NIJ18482/Luis-Nij-Tesis-2022/MODELADO 3D Y ENSAMBLAJES/Renderizado de versiones/v2.png

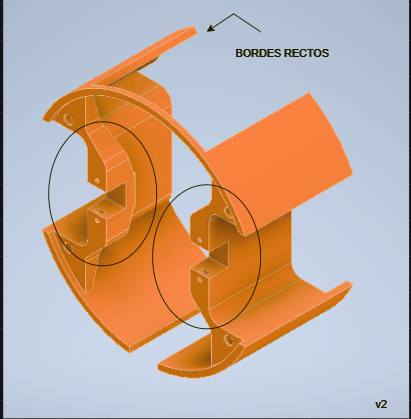
MODELADO 3D Y ENSAMBLAJES/Renderizado de versiones/v2.png
