NIJ18482/Luis-Nij-Tesis-2022/README.md

# ESTIMADO AMIGO LECTOR:

El objetivo de este repositorio es brindarte una herramienta mas con la que puedas trabajar experimentos de robotica de enjambre y que puedas ver el analisis desde la perspectiva de ingeniería de un agente robótico funcional. 

**IMPORTANTE: ESTE PRIMER README TIENE COMO OBJETIVO BRINDARTE UNA BREVE DESCRIPCION DE LOS ELEMENTOS DE ESTE REPOSITORIO
TE RECOMIENDO ENCARECIDAMENTE LEERLO Y PASAR A TRABAJO_DE_GRADUACION.MD PARA DISFRUTAR DEL TRABAJO COMPLETO Y DETALLADO**

Sirvete encontrarte con lo siguiente:

# ALPHABOT: DOCUMENTOS

- En esta carpeta encontrarás el renderizado de la documentación generada como parte del trabajo de graduación del autor. En ella encontrarás el enlace al archivo editable en Canva.com así como un archivo PDF descargable para revisar la version final de la documentación al momento de la entrega del trabajo de graduación. Así mismo se adjunta una libreria de imagenes renderizadas del archivo de documentación en formato PNG con el objetivo de brindar versatilidad a la disponibilidad de los archivos.

- Favor de ponerse en contacto con el autor si en caso quieres realizar actualizaciones al material de documentación para configurar los permisos correspondientes. 

# ALPHABOT: MODELADO 3D Y ENSAMBLAJES

- En esta carpeta encontrarás los modelos 3D de las partes que componen el agente robótico que se analiza en el presente repositorio.
- Es necesario mencionar que para el modelado de las piezas en 3D se utilizó la suite 2023 de Autodesk Inventor Professional. Es immportante mencionar esto ya que necesitarás una version igual o más actualizada para poder abrir dichos archivos ya que por politica de Autodesk (la compañía que desarrolló el software) no existe compatibilidad entre una version reciente de Autodesk Inventor reciente con archivos creados en versiones viejas.
- Para la manufactura de las piezas que veras a continuación se puede optar por varias tecnicas de impresion 3D. Dada la disponibilidad de recursos del autor se optó por impresion 3D por fundicion de material de filamento. El modelo utilizado fue la Ender 3 version 1 y PLA estándar de la marca eSUN. Puedes ponerte en contacto con el autor si deseas mas detalles de cómo fueron manufacturadas las piezas y la compatibilidad de impresoras 3D.
- Así mismo, las piezas planares como los covertores superiores con el emblema de la Universidad del Valle de Guatemala fueron manufacturados por corte laser de plancha de acrílico transparente de 3mm. Para esto se utilizó una cortadora laser de 40W de potencia de origen chino. Nuevamente, puedes ponerte en contacto con el autor para verificar la compatibilidad y viabilidad de utilizar diferente maquinaria.

# ALPHABOT: SCRIPTS Y PROGRAMACIÓN
-En esta carpeta encontrarás los dos scripts de programacion fundamentales con los que se aporto al trabajo de graduación. En su carpeta encontrarás mas información respecto a cada uno, sin embargo te puedo anticipar que corresponden al sistema de comunicacion esclavo-maestro de los agentes roboticos y que sirvio como plataforma para comunicar instrucciones y recibir comandos en el servicor (PC) proveniente de los agentes roboticos 

# ALPHABOT: TRABAJO DE GRADUACION.MD
- Aquí encontraras el consolidado del trabajo de graduación en formato repositorio para que puedas leerlo en GitHub, se adjunta también la version en PDF del trabajo final y posterior a la autorización final por parte de Secretaria General de la UVG de aprobada la tesis en cuanto a forma y redacción.
