NIJ18482/Luis-Nij-Tesis-2022/DOCUMENTOS/README.MD

# BIENVENIDO AMIGO

- En esta sección encontrarás el archivo comprimido de la documentación en formato imagenes JPG para descarga y facil distribución.
Es importante mencionar que corresponde a la V1.0 del mismo. 

Para mas detalles puedes ponerte en contacto con el autor.
