NIJ18482/Luis-Nij-Tesis-2022/Documentos/README_DOCUMENTOS.md

# DOCUMENTACIÓN DEL ANÁLISIS DEL AGENTE ROBÓTICO - DOCUMENTO PDF ADJUNTO

Enlace: https://www.canva.com/design/DAFGcc9DaEw/2KTWVuM6ZRo98AekcS2Smw/edit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

Como parte de los aportes de este trabajo se generó un documento a manera de documentación explicando componente por componente los elementos del Alphabot02. Se deja compartido el documento en este repositorio asi como el enlace a la plataforma Canva para poder descargarlo y/o editarlo segun se requiera. 

Para editar el documento favor escribir al autor para configurar los permisos.
