NIJ18482/Luis-Nij-Tesis-2022/DOCUMENTOS/Images/1.png

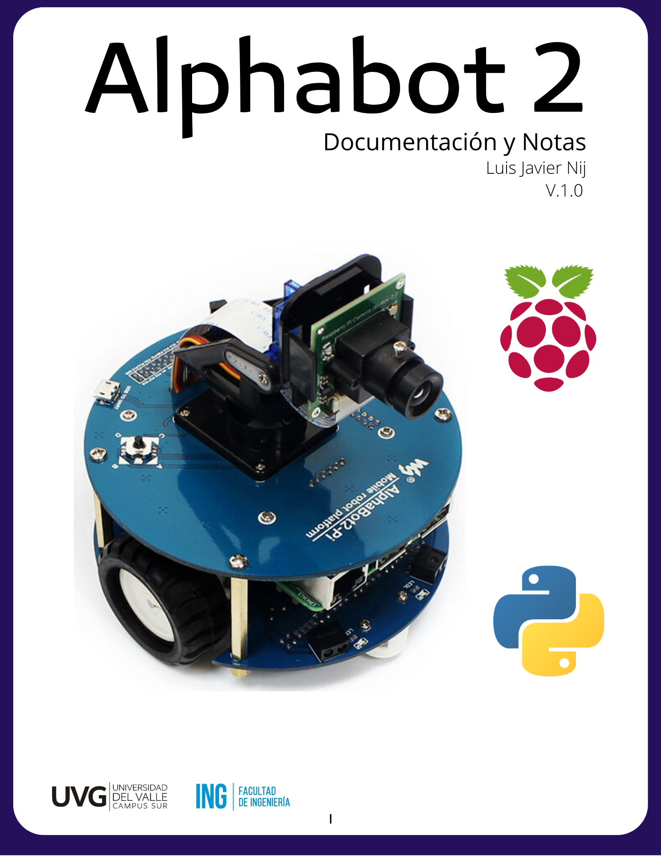
DOCUMENTOS/Images/1.png
