NIJ18482/Luis-Nij-Tesis-2022/DOCUMENTOS/Images/2.png

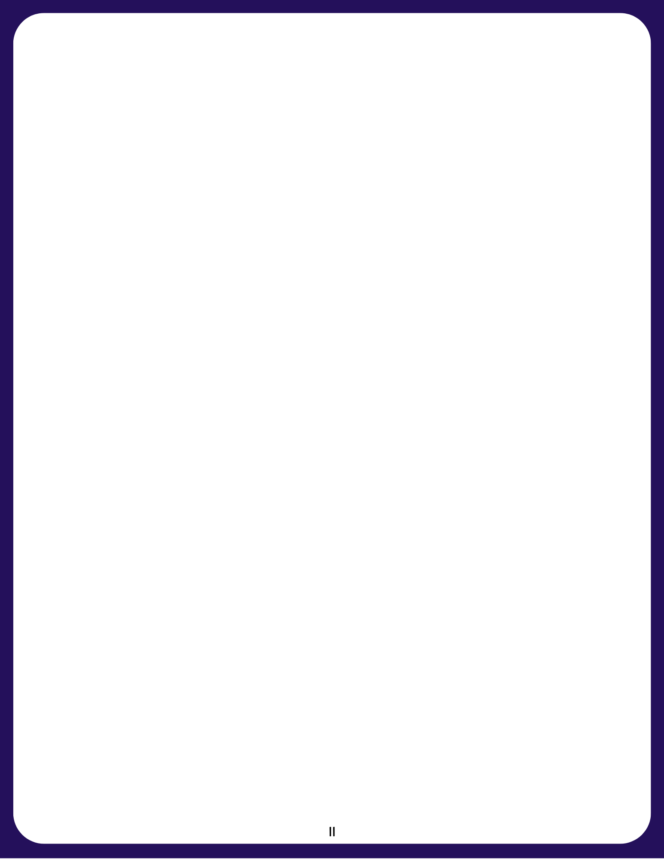
DOCUMENTOS/Images/2.png
