NIJ18482/Luis-Nij-Tesis-2022/DOCUMENTOS/Images/3.png

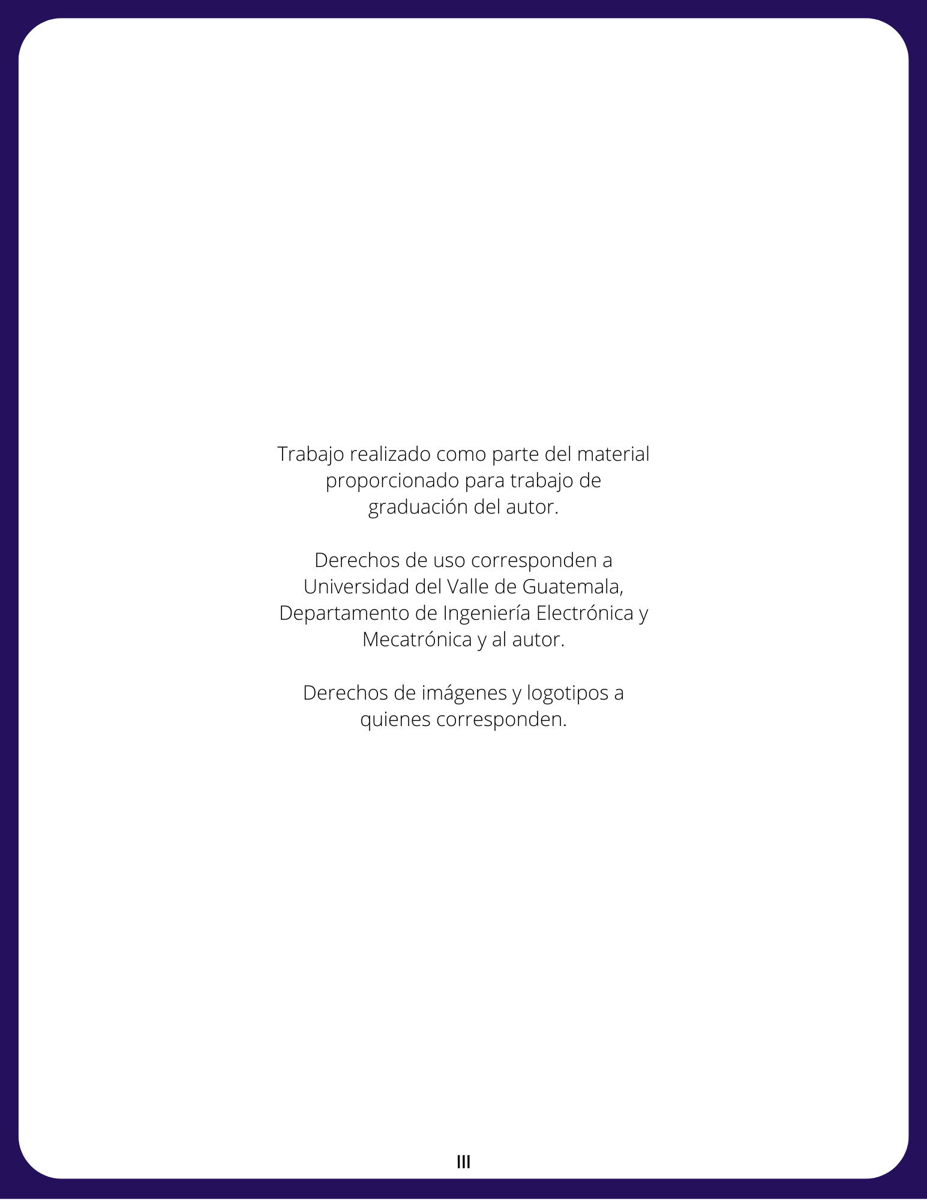
DOCUMENTOS/Images/3.png
