NIJ18482/Luis-Nij-Tesis-2022/DOCUMENTOS/Images/7.png

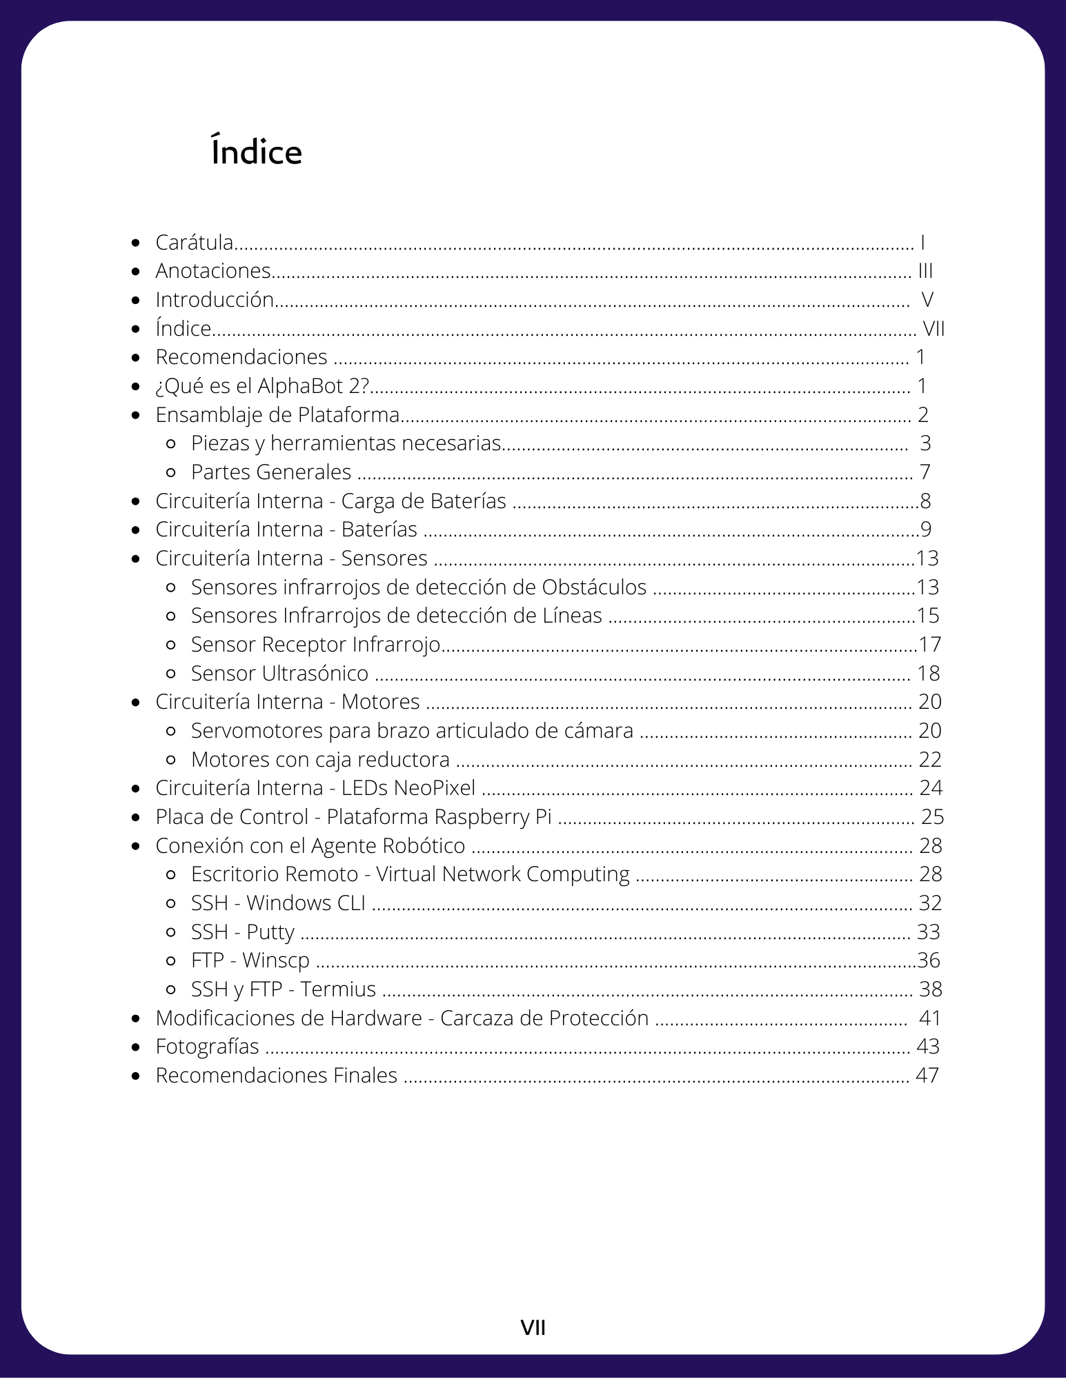
DOCUMENTOS/Images/7.png
