NIJ18482/Luis-Nij-Tesis-2022/DOCUMENTOS/Images/8.png

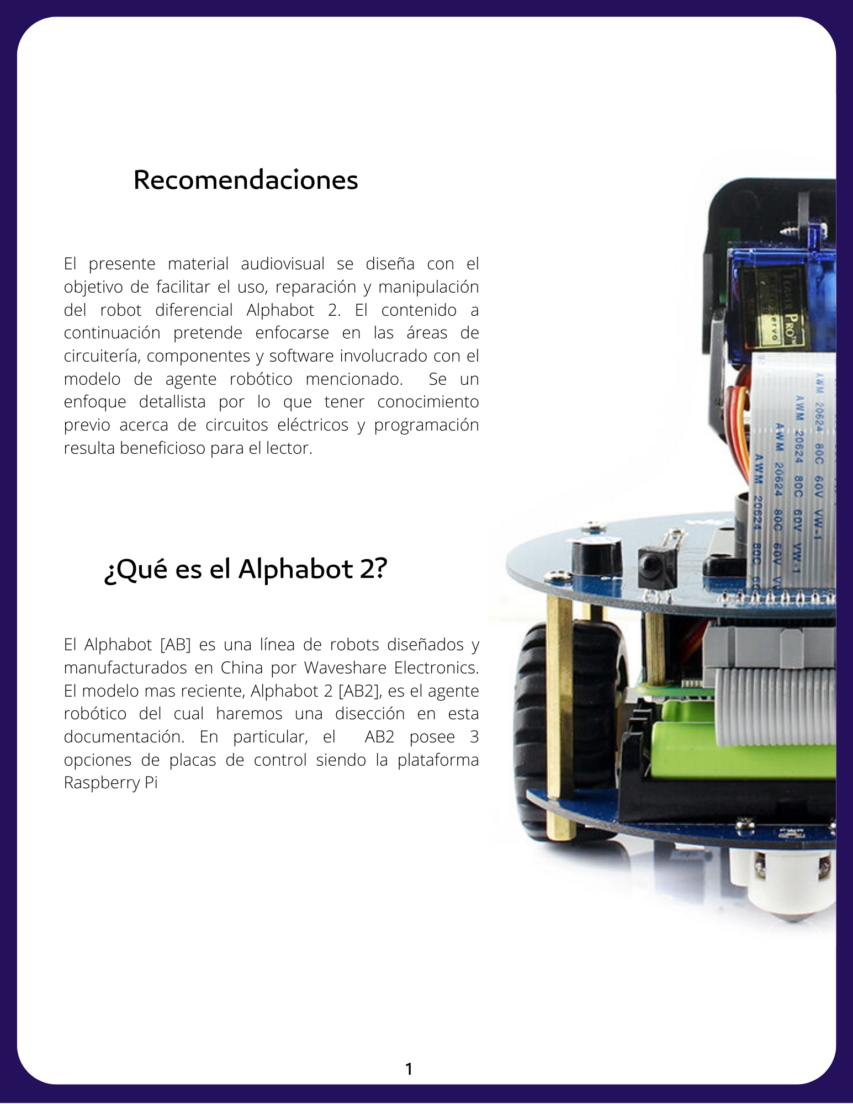
DOCUMENTOS/Images/8.png
