NIJ18482/Luis-Nij-Tesis-2022/DOCUMENTOS/Images/9.png

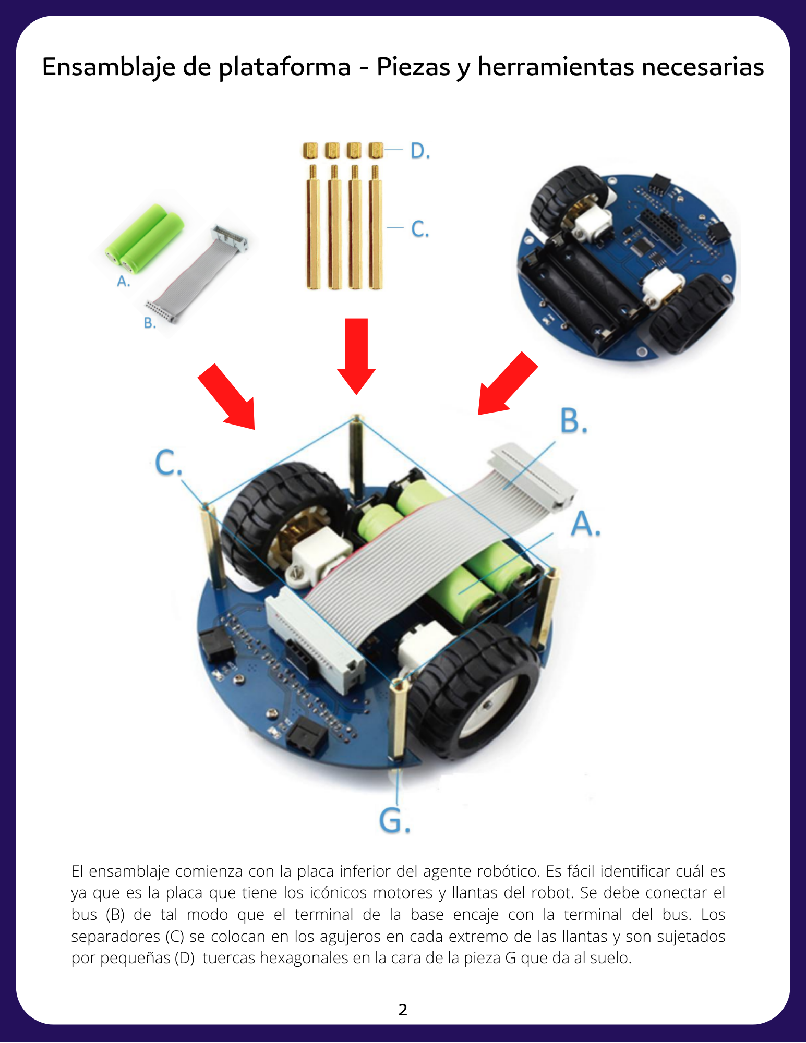
DOCUMENTOS/Images/9.png
