NIJ18482/Luis-Nij-Tesis-2022/DOCUMENTOS/Images/10.png

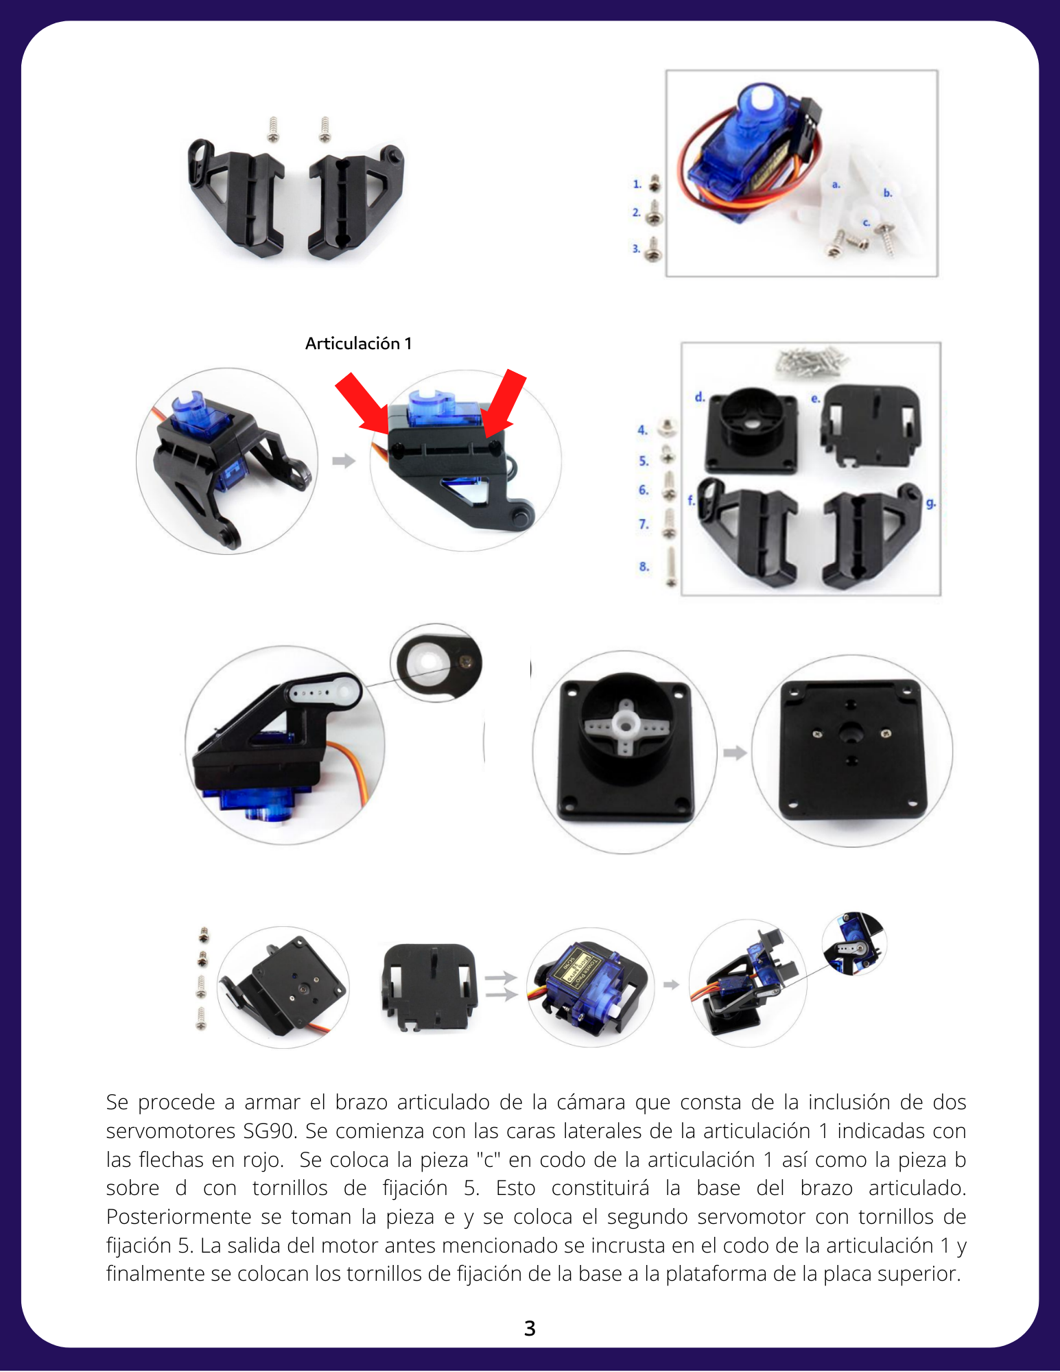
DOCUMENTOS/Images/10.png
