NIJ18482/Luis-Nij-Tesis-2022/DOCUMENTOS/Images/11.png

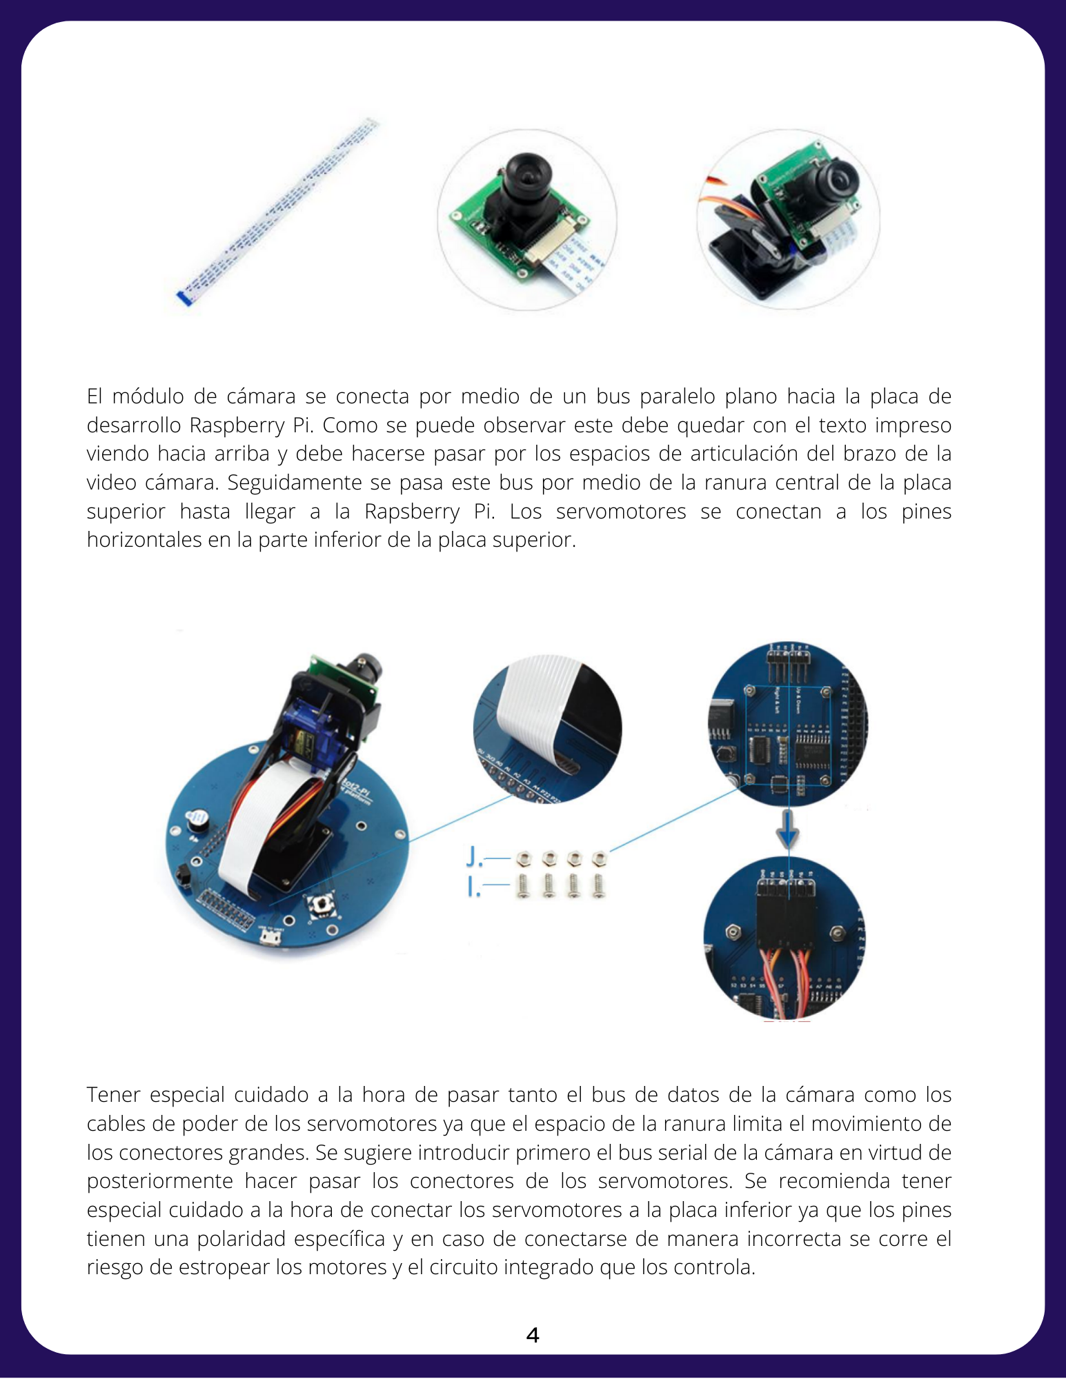
DOCUMENTOS/Images/11.png
