NIJ18482/Luis-Nij-Tesis-2022/DOCUMENTOS/Images/12.png

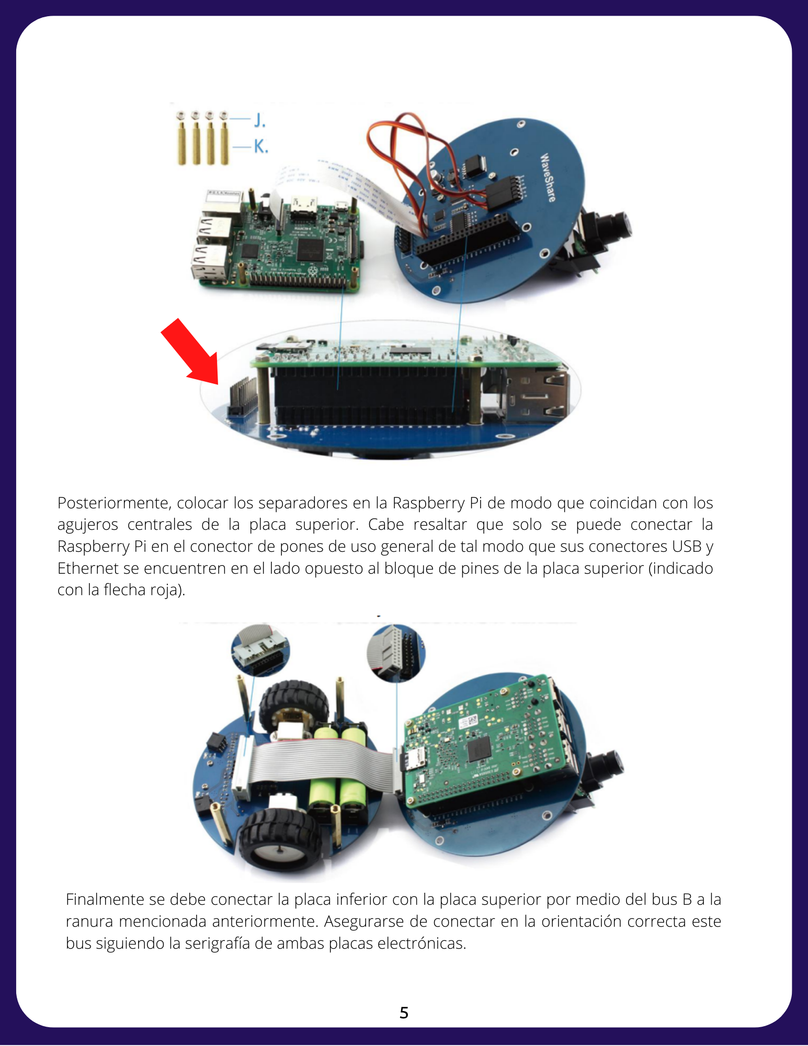
DOCUMENTOS/Images/12.png
