NIJ18482/Luis-Nij-Tesis-2022/DOCUMENTOS/Images/13.png

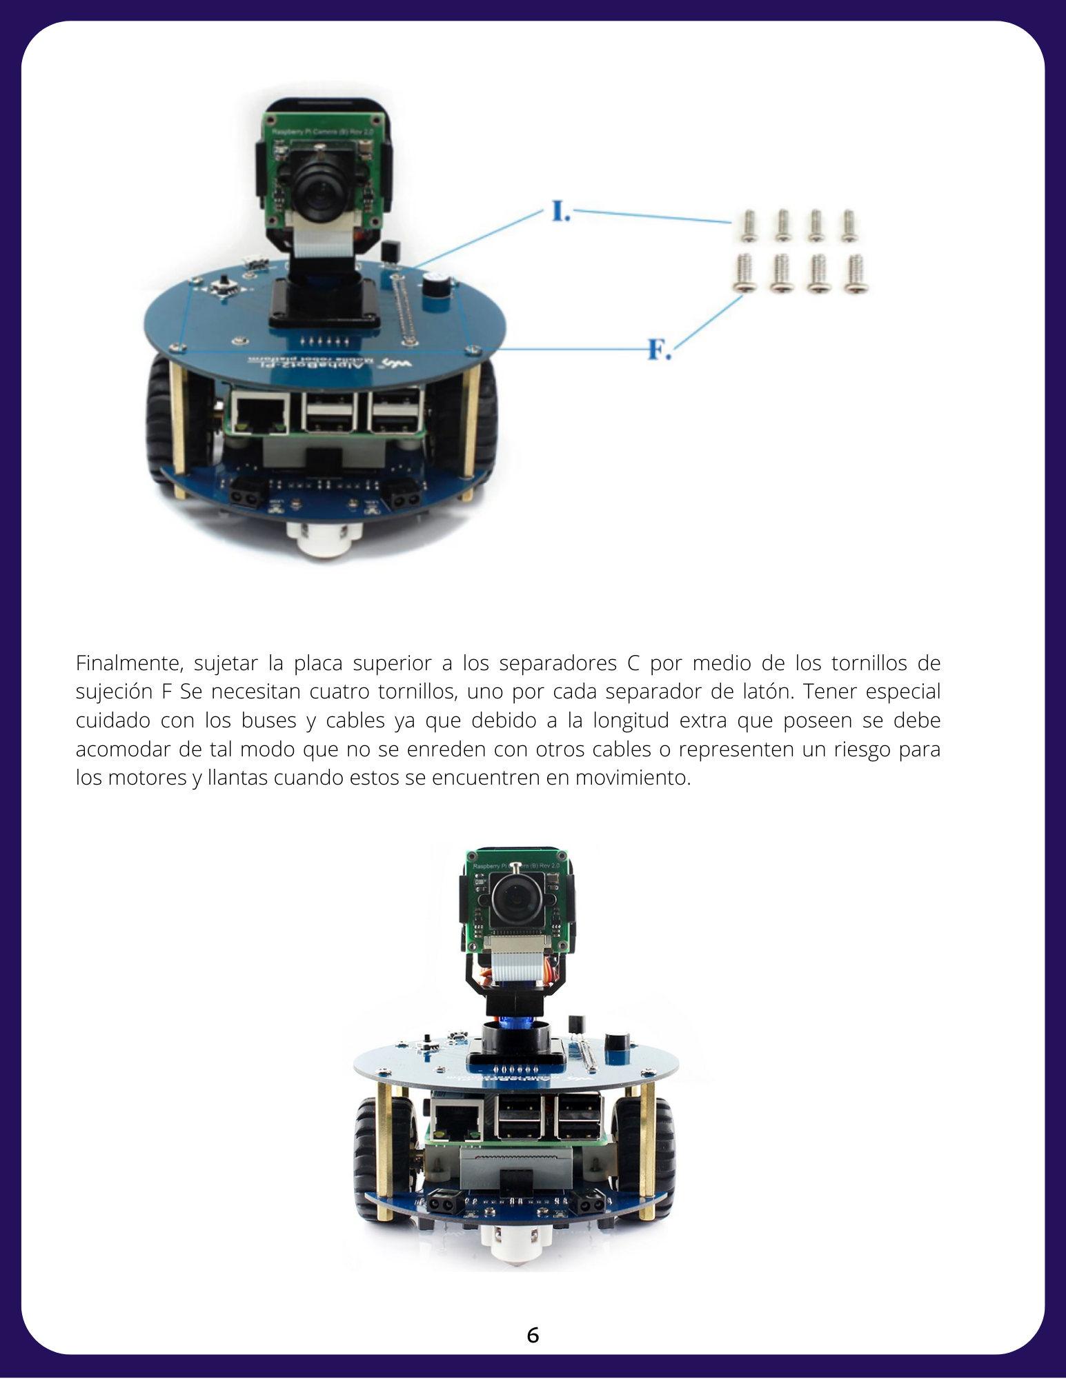
DOCUMENTOS/Images/13.png
