NIJ18482/Luis-Nij-Tesis-2022/DOCUMENTOS/Images/14.png

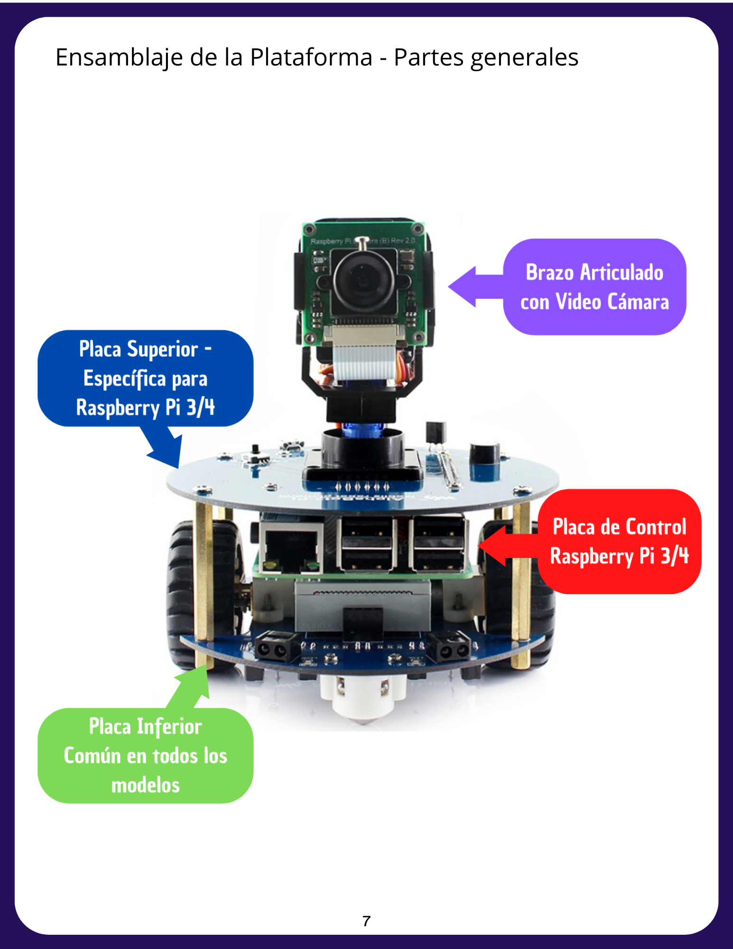
DOCUMENTOS/Images/14.png
