NIJ18482/Luis-Nij-Tesis-2022/DOCUMENTOS/Images/15.png

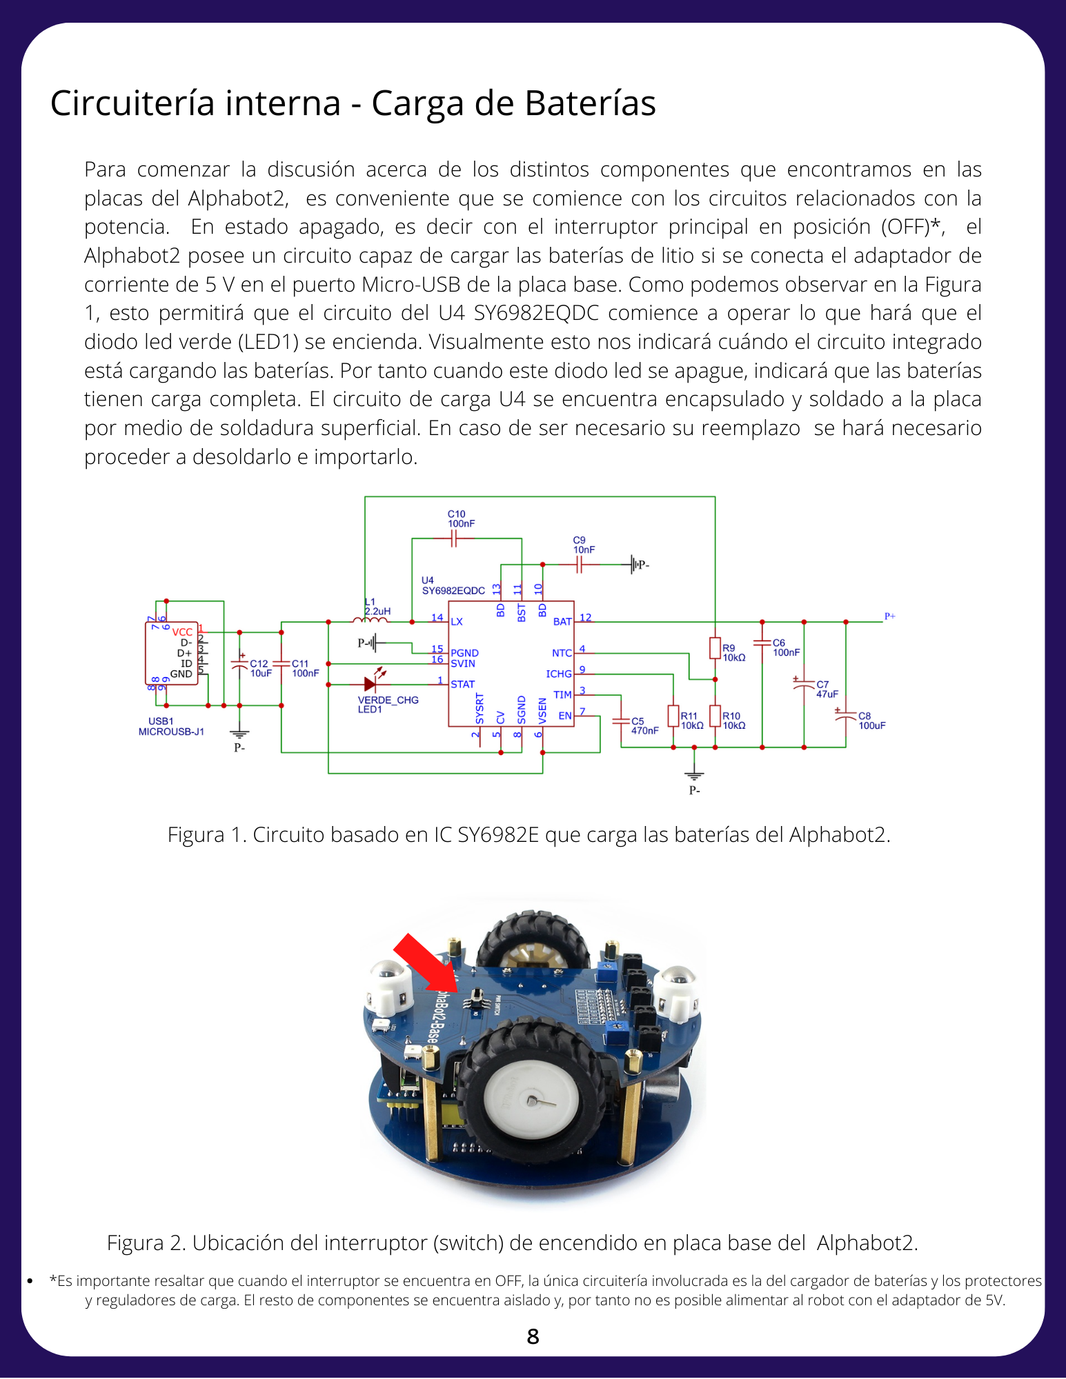
DOCUMENTOS/Images/15.png
