NIJ18482/Luis-Nij-Tesis-2022/DOCUMENTOS/Images/16.png

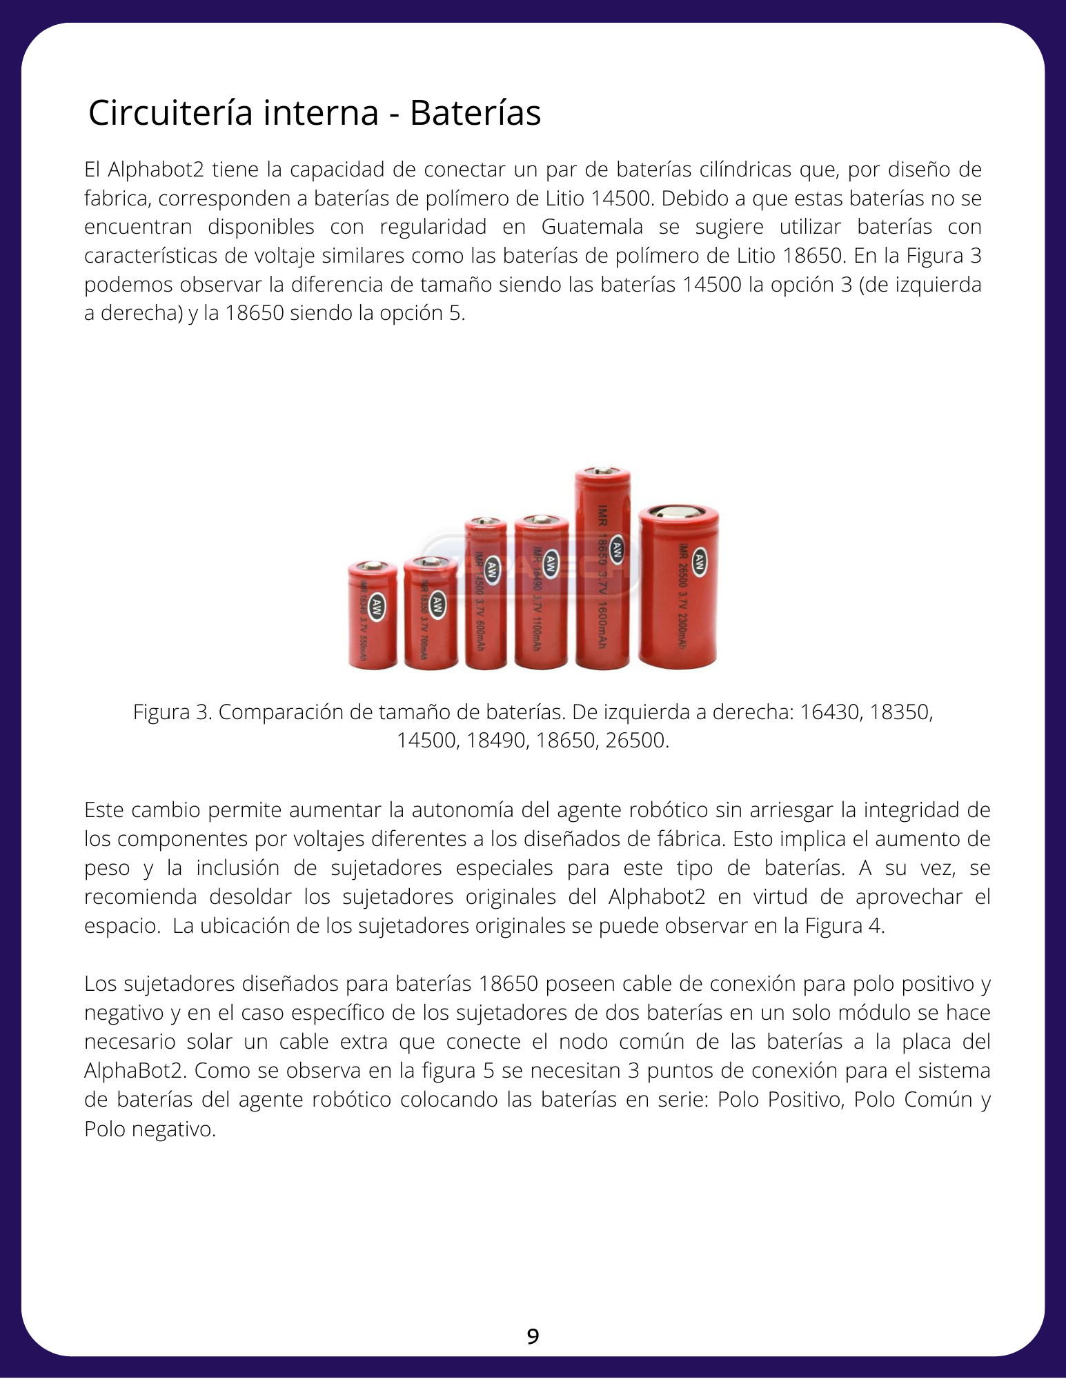
DOCUMENTOS/Images/16.png
