NIJ18482/Luis-Nij-Tesis-2022/DOCUMENTOS/Images/17.png

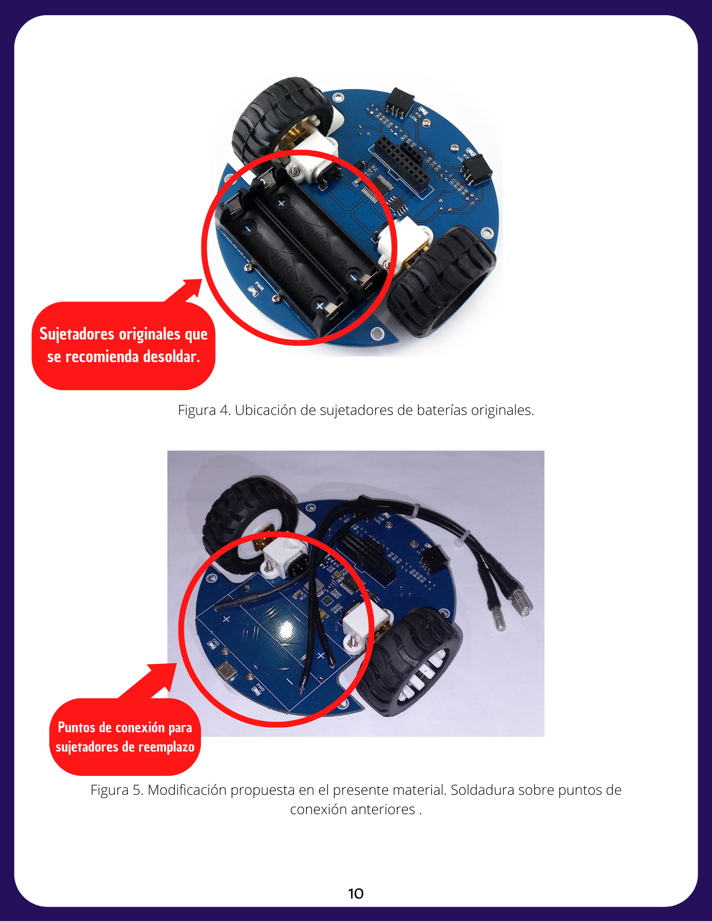
DOCUMENTOS/Images/17.png
