NIJ18482/Luis-Nij-Tesis-2022/DOCUMENTOS/Images/18.png

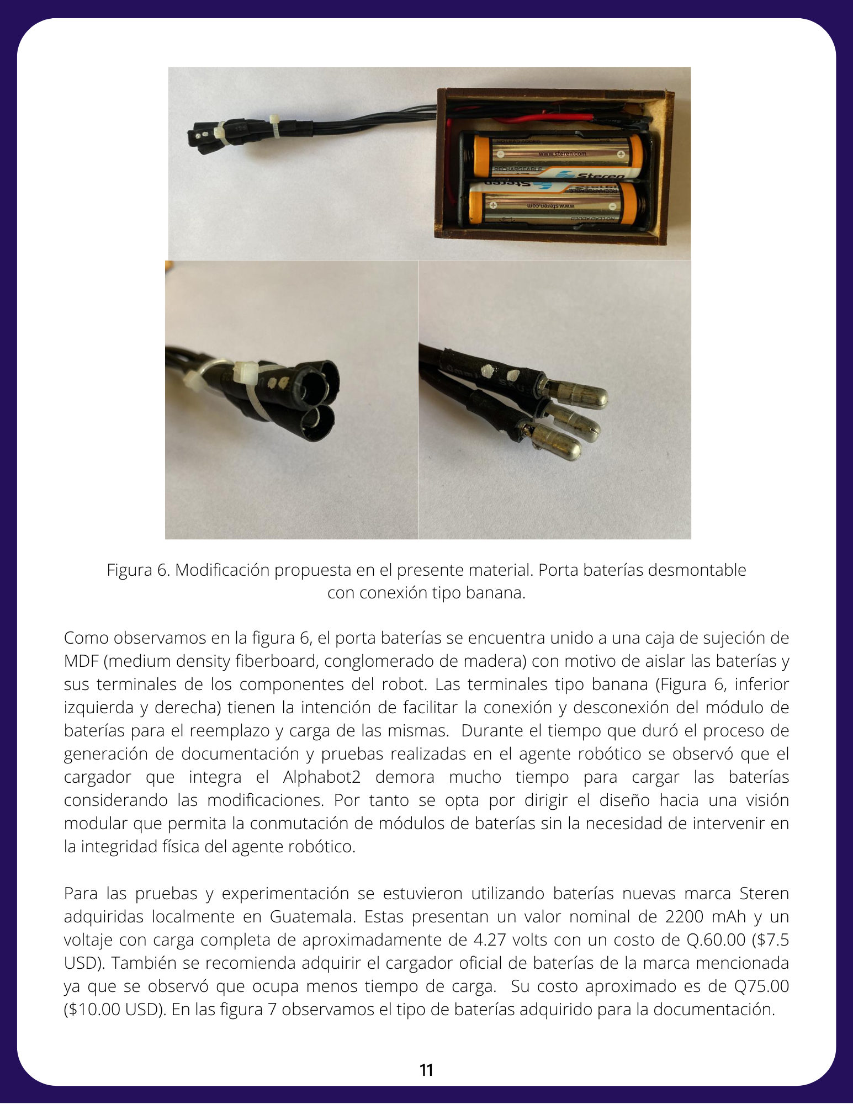
DOCUMENTOS/Images/18.png
