NIJ18482/Luis-Nij-Tesis-2022/DOCUMENTOS/Images/19.png

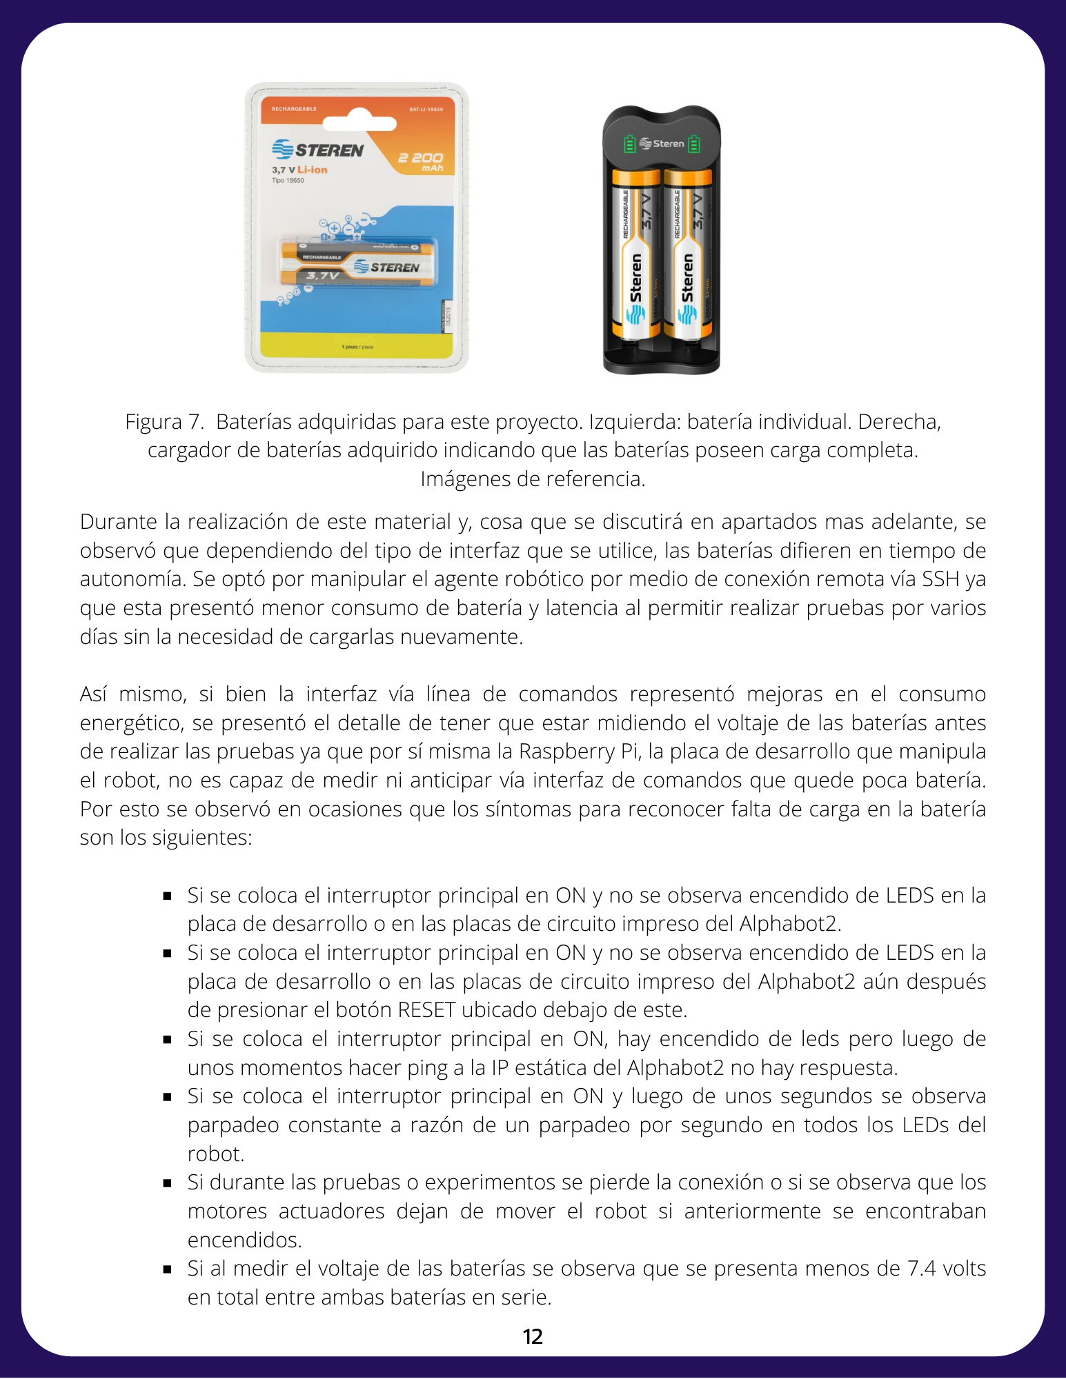
DOCUMENTOS/Images/19.png
