NIJ18482/Luis-Nij-Tesis-2022/DOCUMENTOS/Images/20.png

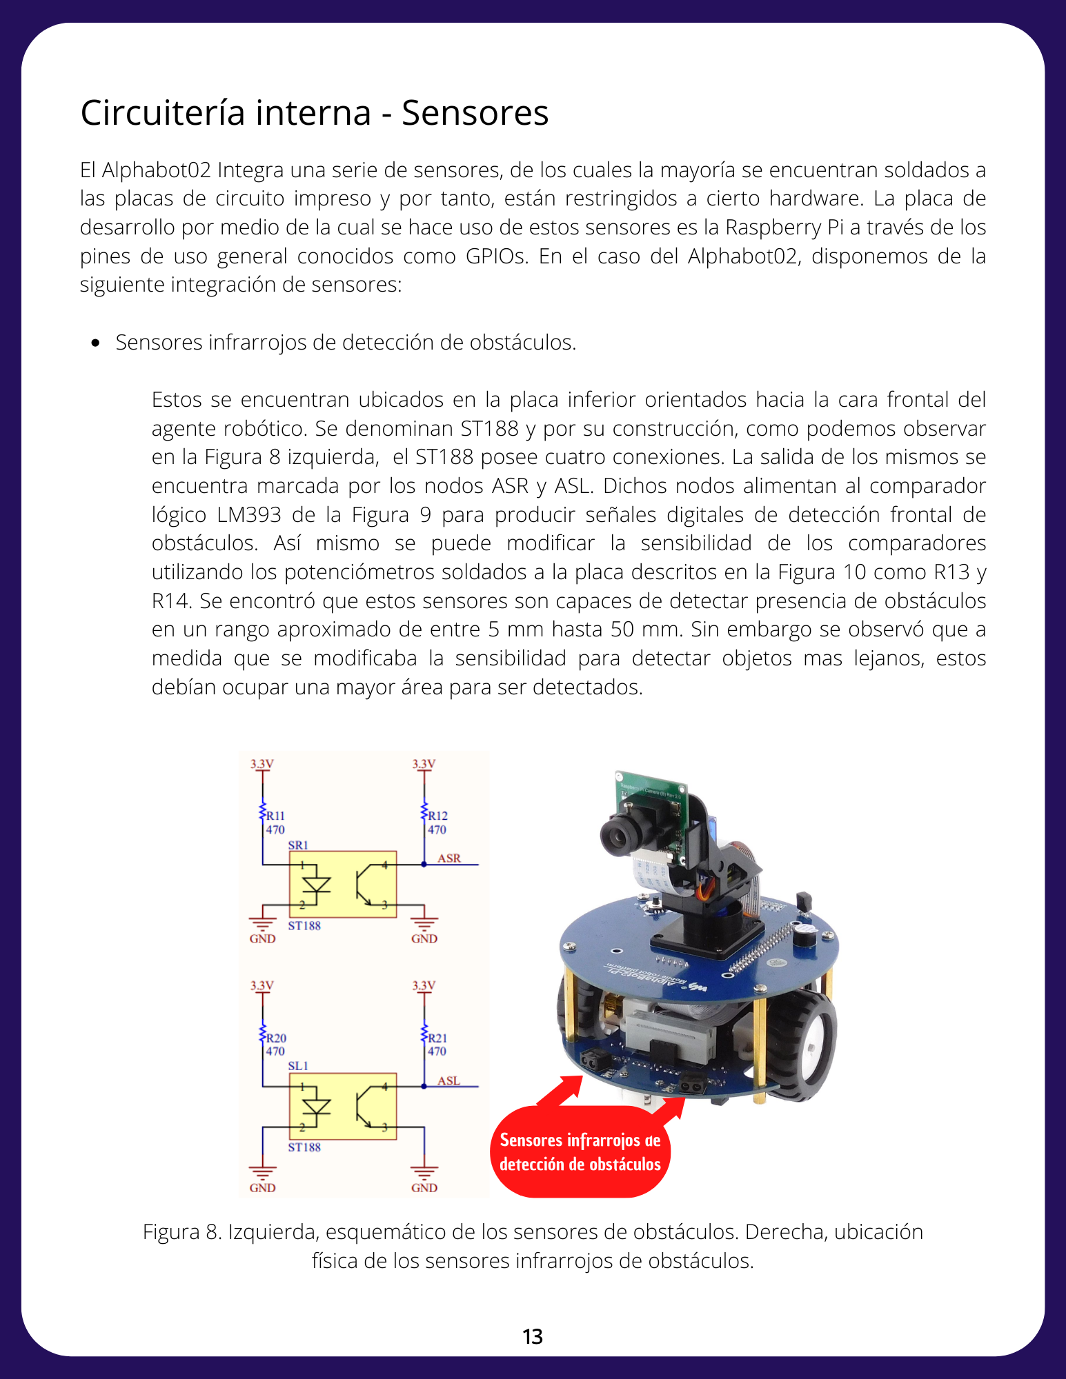
DOCUMENTOS/Images/20.png
