NIJ18482/Luis-Nij-Tesis-2022/DOCUMENTOS/Images/21.png

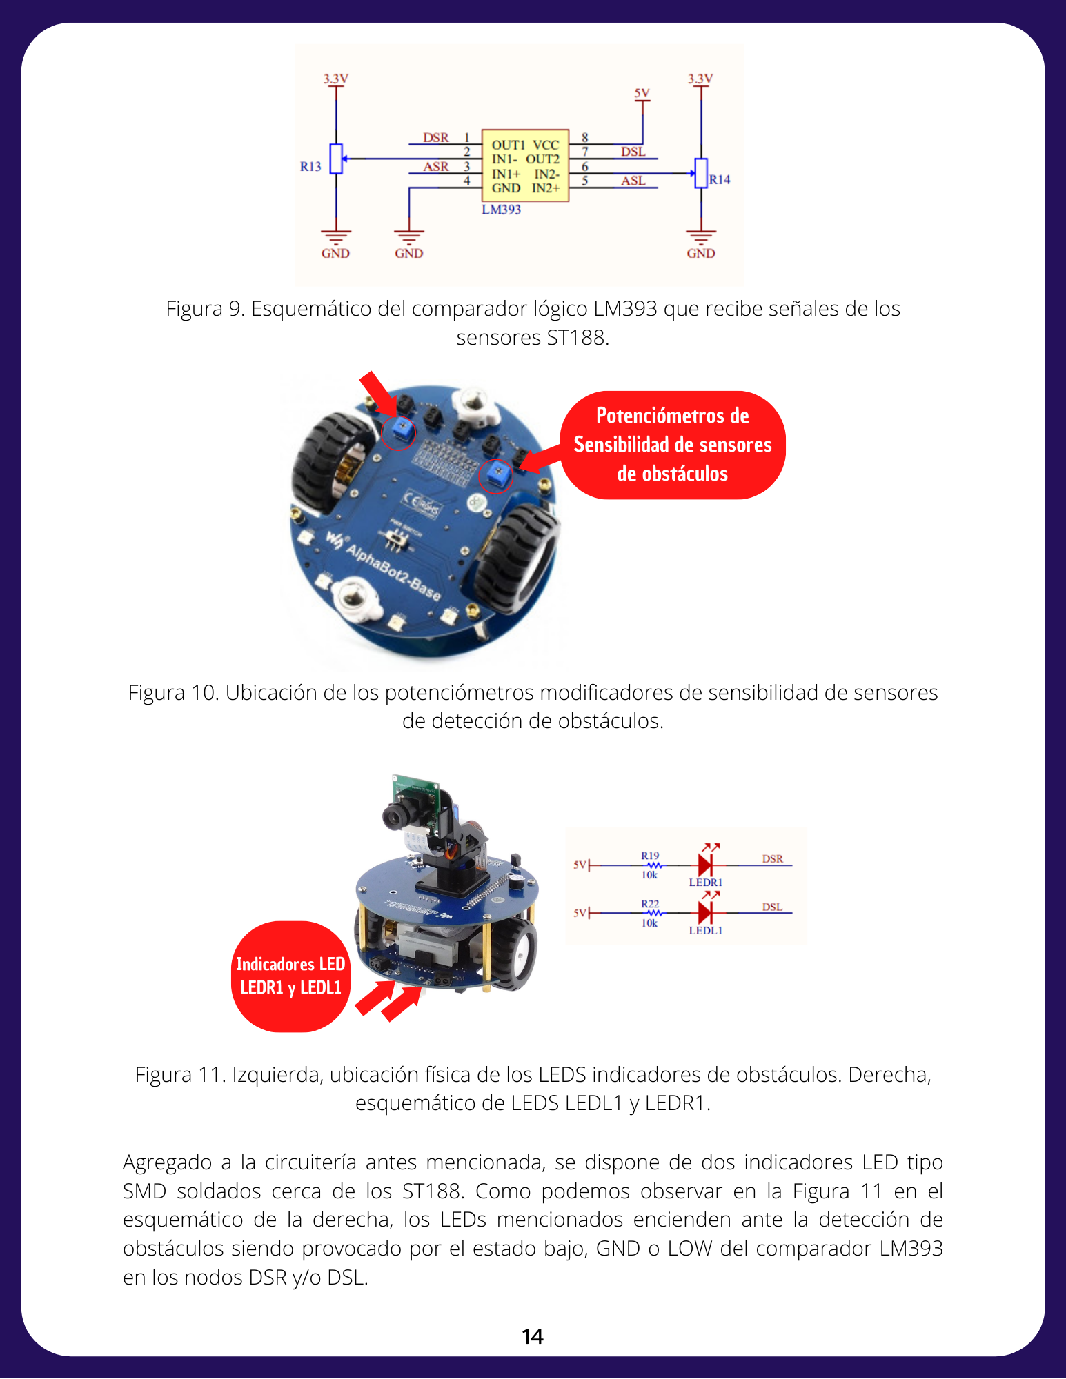
DOCUMENTOS/Images/21.png
