NIJ18482/Luis-Nij-Tesis-2022/DOCUMENTOS/Images/22.png

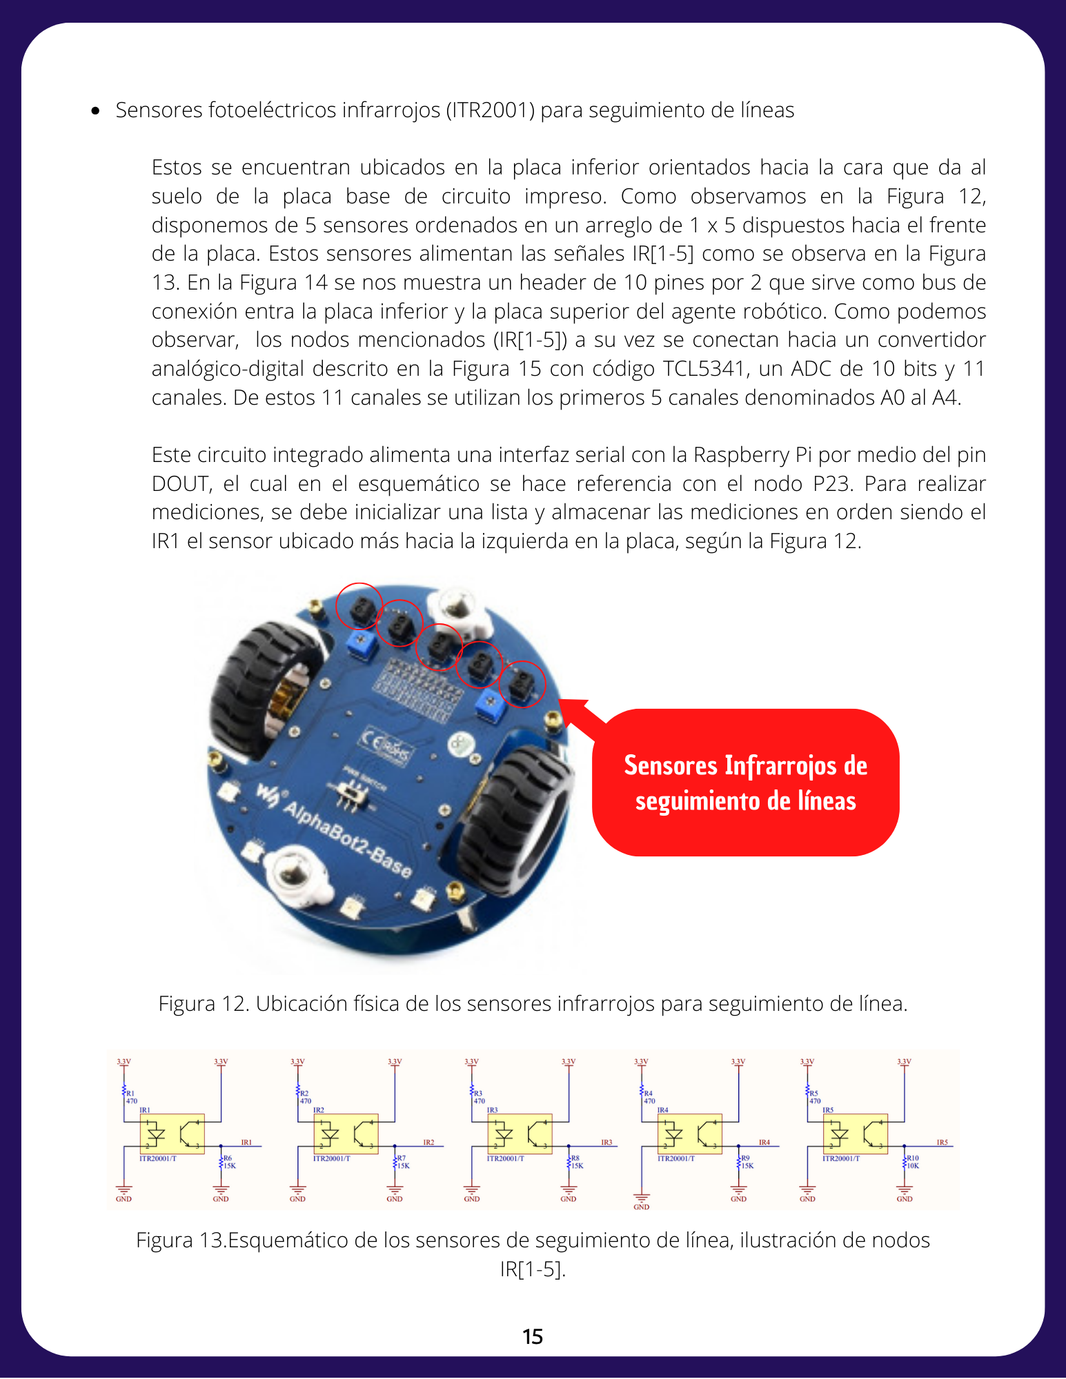
DOCUMENTOS/Images/22.png
