NIJ18482/Luis-Nij-Tesis-2022/DOCUMENTOS/Images/23.png

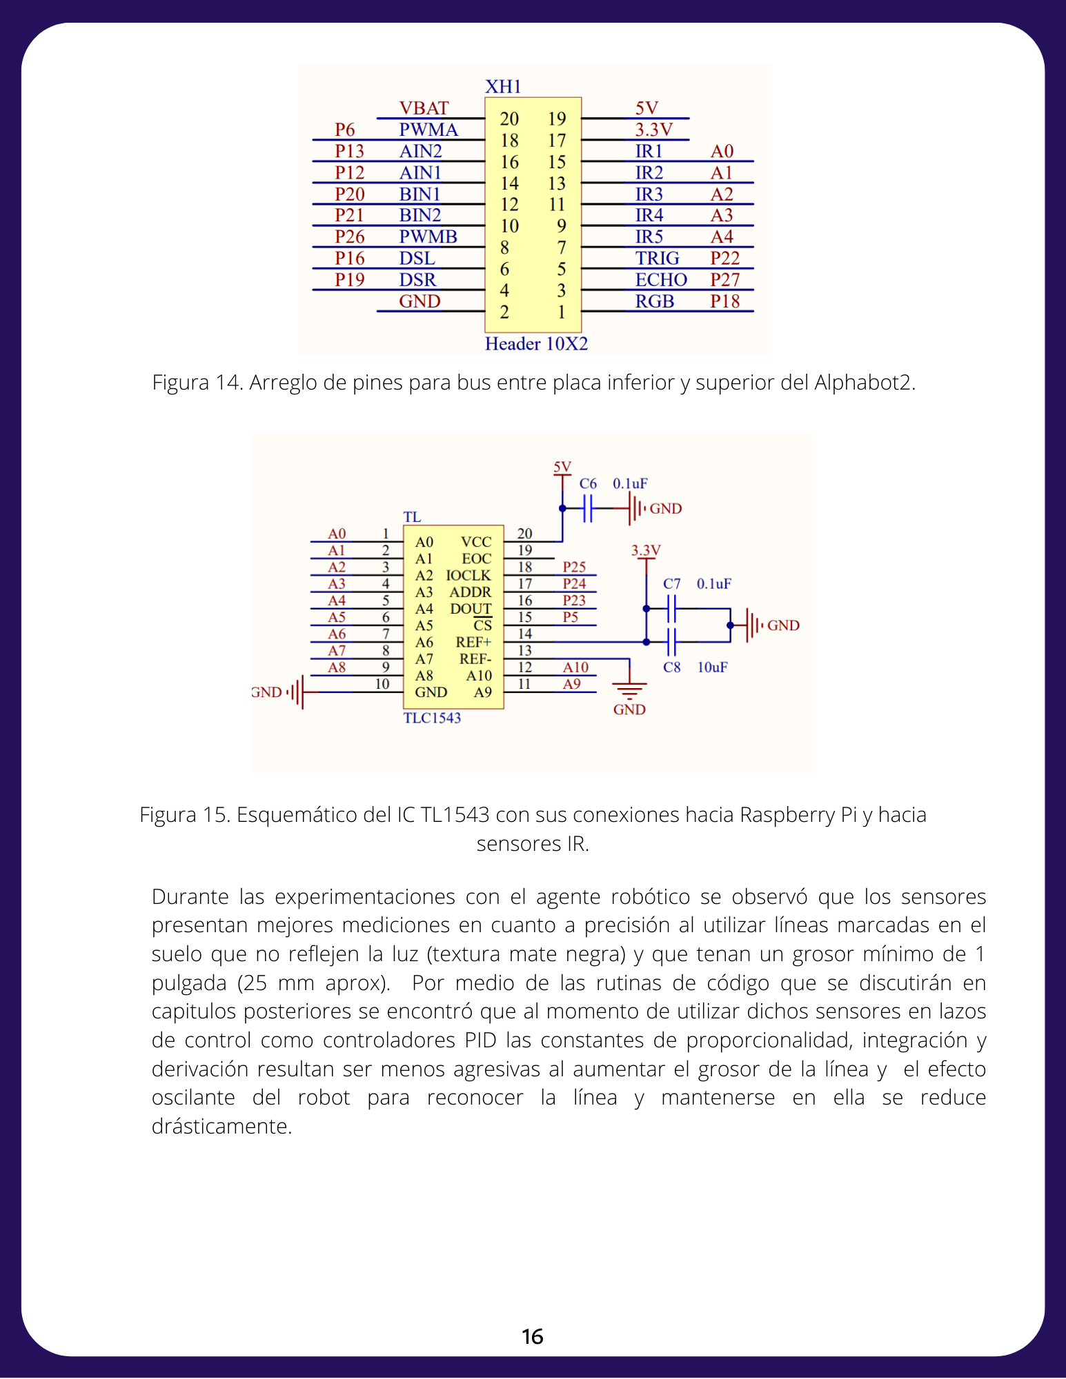
DOCUMENTOS/Images/23.png
