NIJ18482/Luis-Nij-Tesis-2022/DOCUMENTOS/Images/24.png

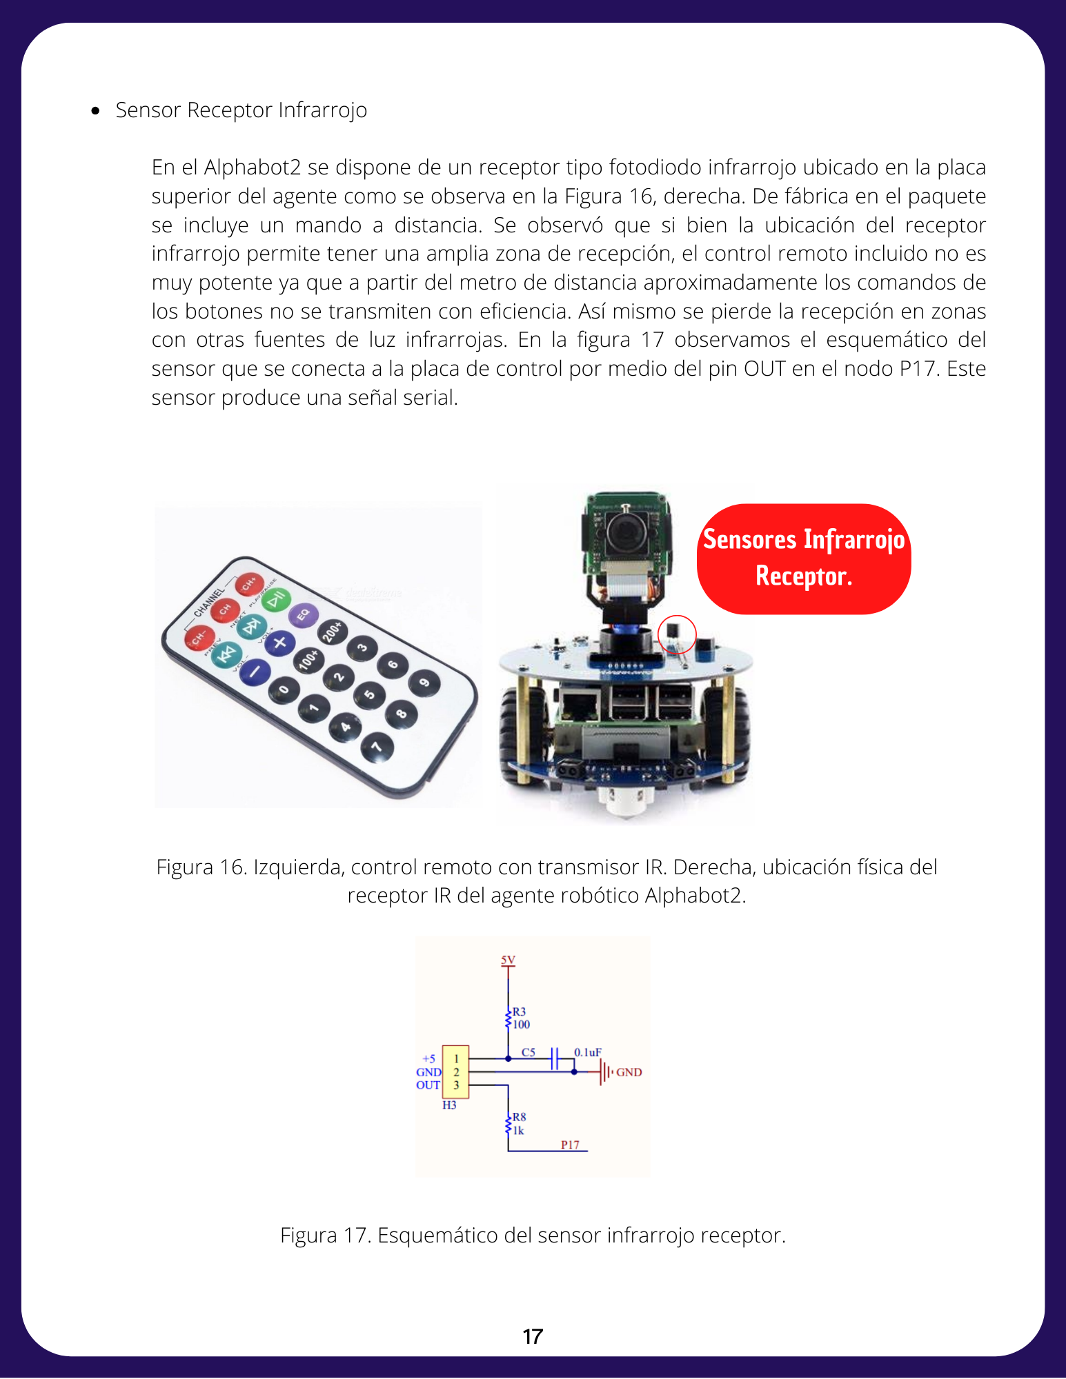
DOCUMENTOS/Images/24.png
