NIJ18482/Luis-Nij-Tesis-2022/DOCUMENTOS/Images/25.png

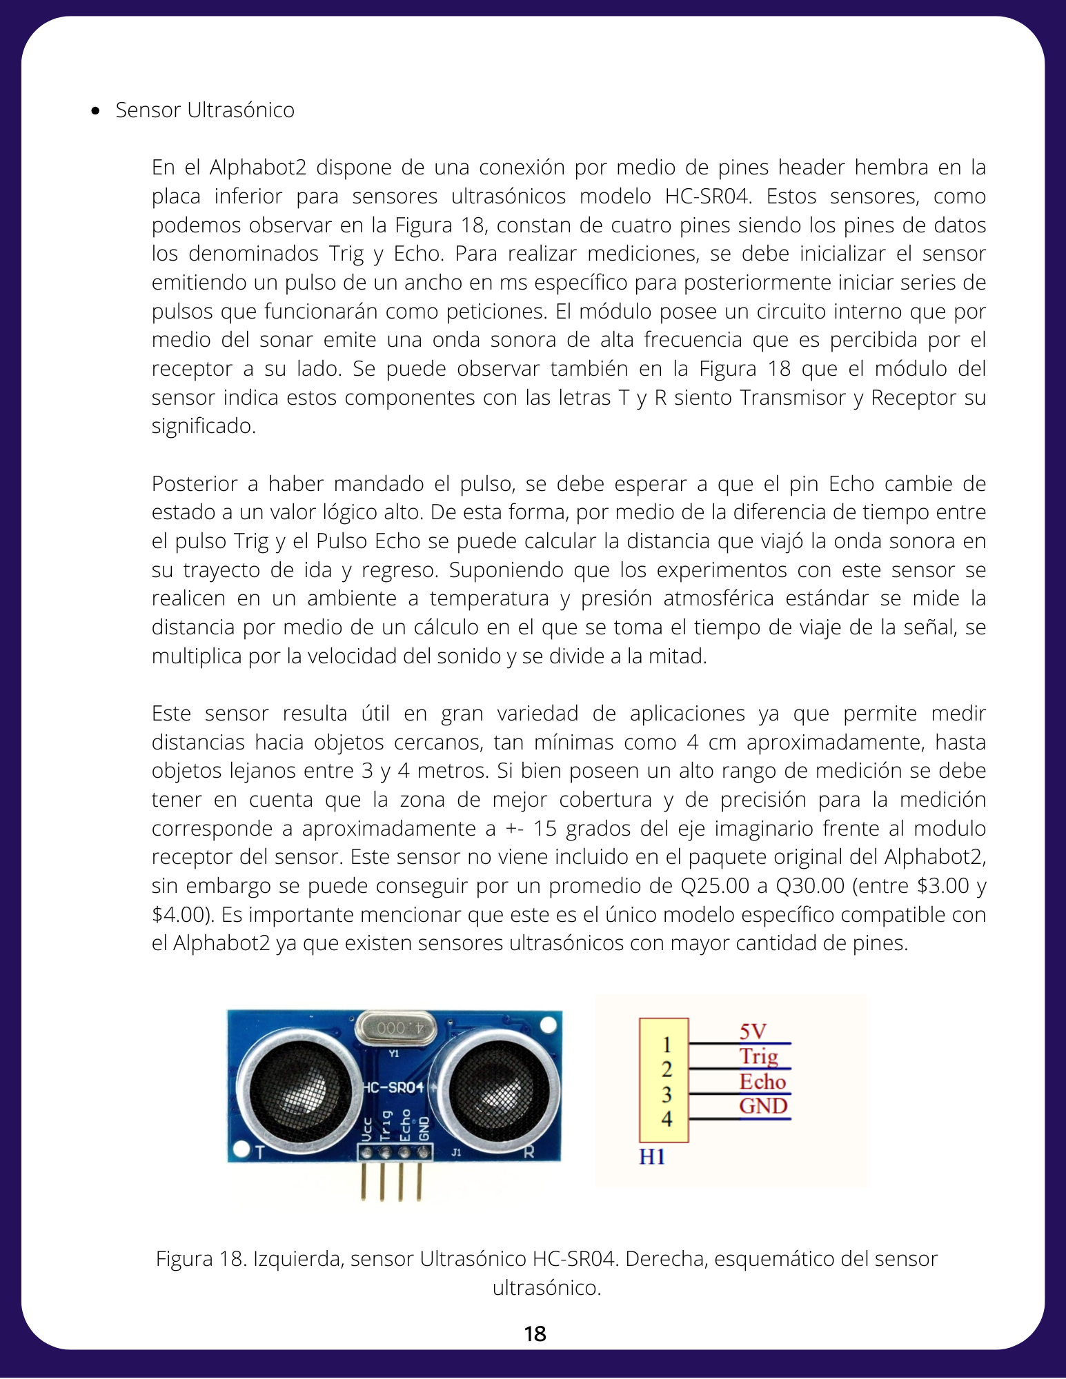
DOCUMENTOS/Images/25.png
