NIJ18482/Luis-Nij-Tesis-2022/DOCUMENTOS/Images/26.png

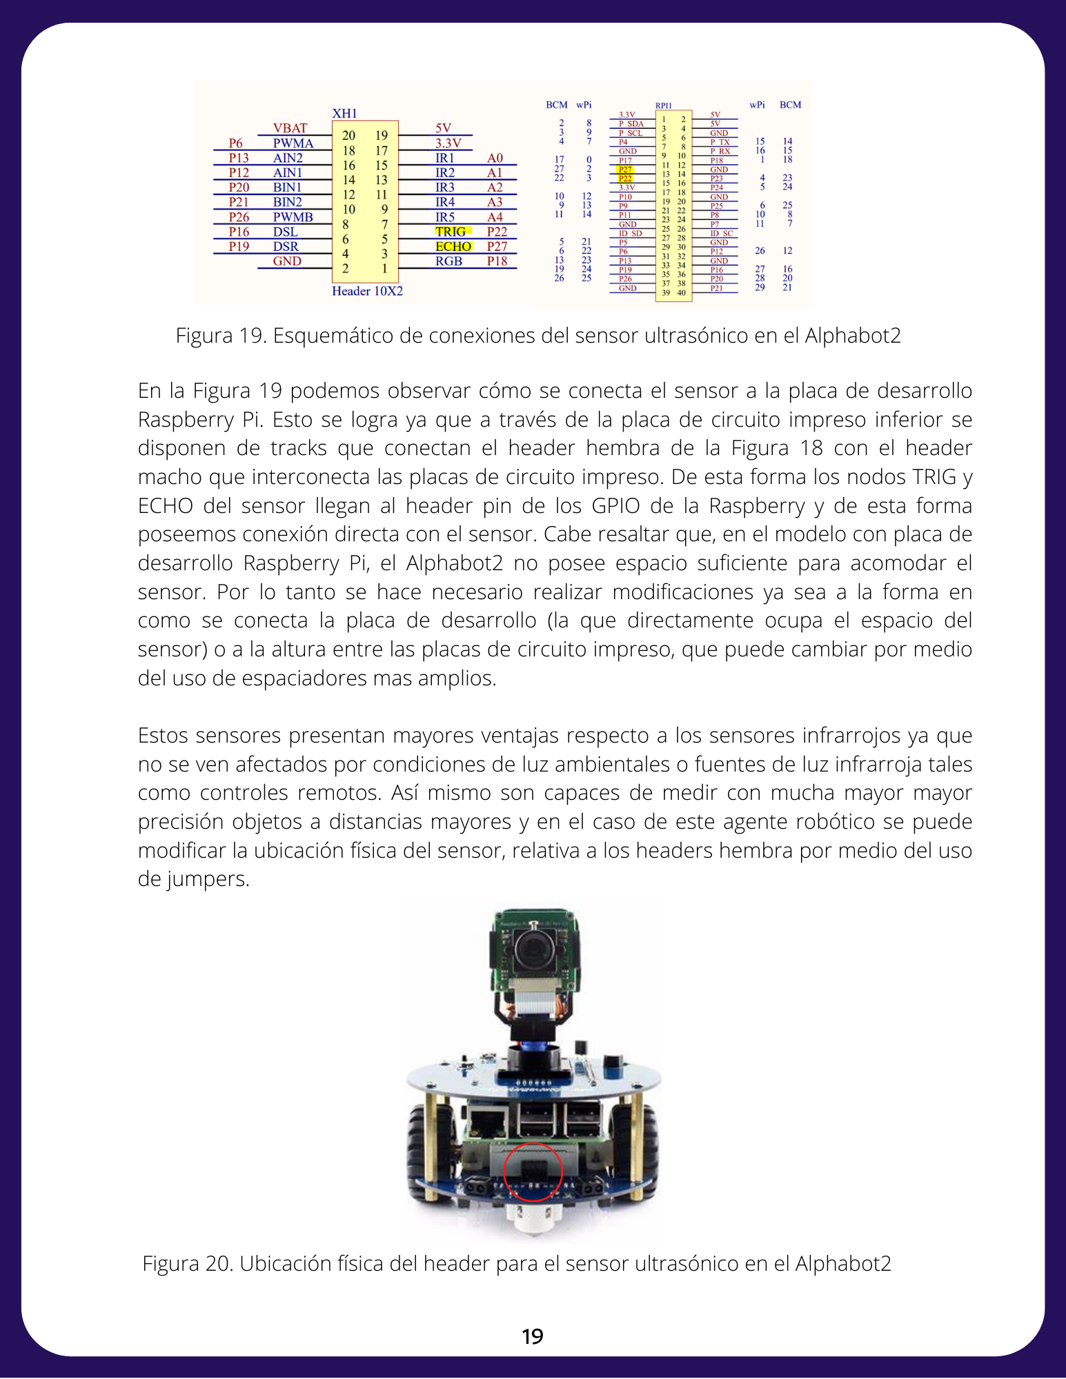
DOCUMENTOS/Images/26.png
