NIJ18482/Luis-Nij-Tesis-2022/DOCUMENTOS/Images/27.png

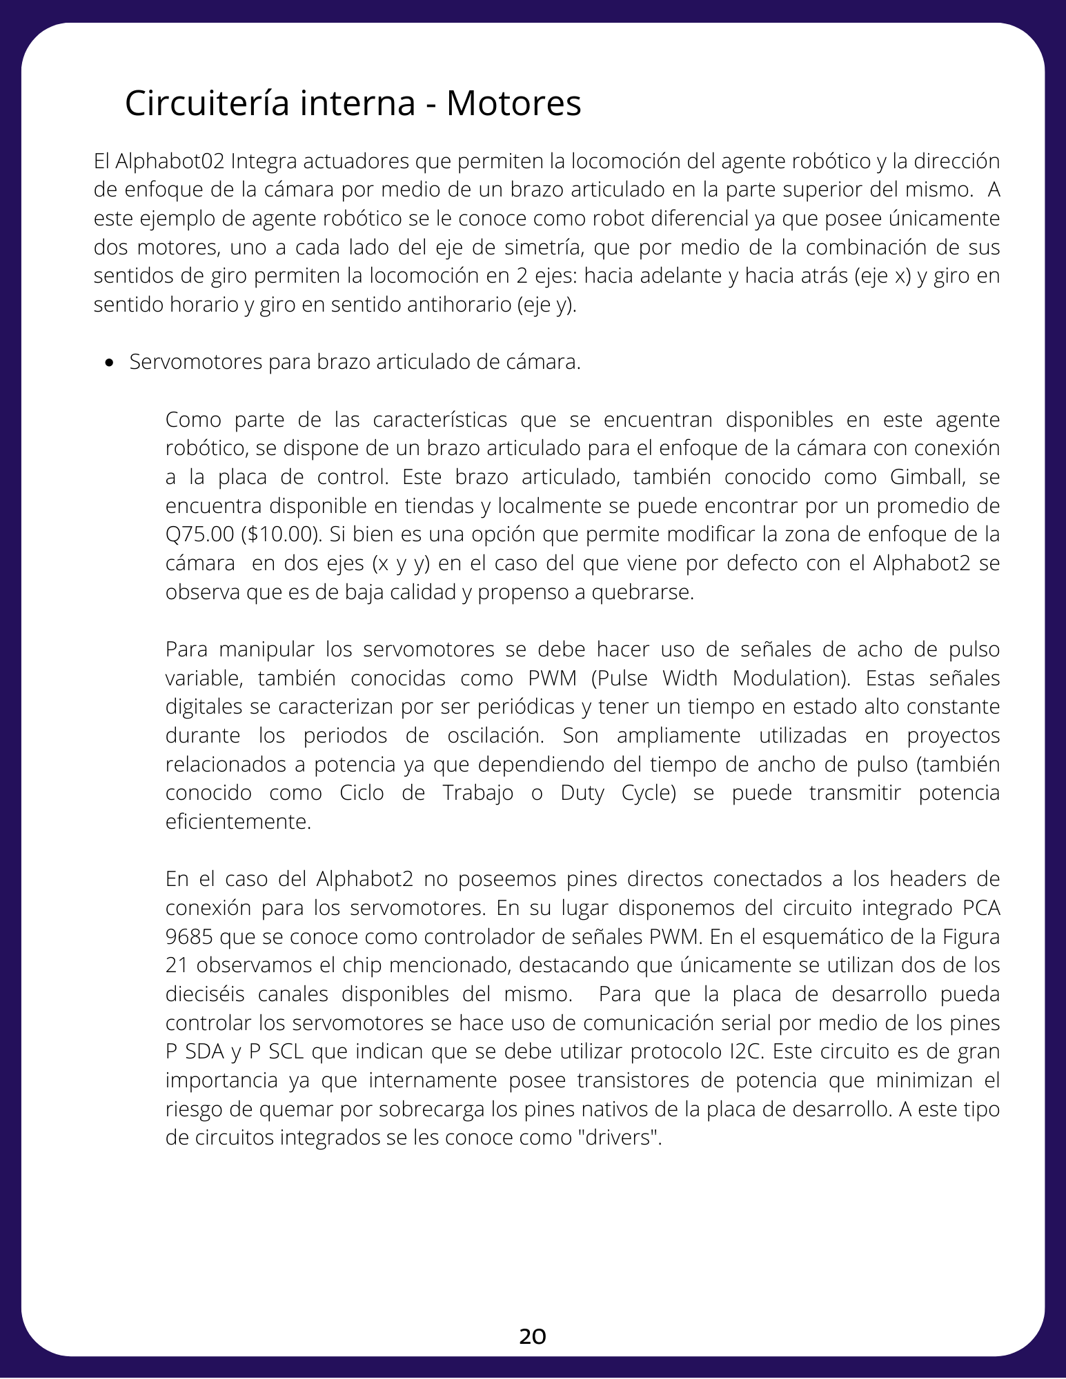
DOCUMENTOS/Images/27.png
