NIJ18482/Luis-Nij-Tesis-2022/DOCUMENTOS/Images/28.png

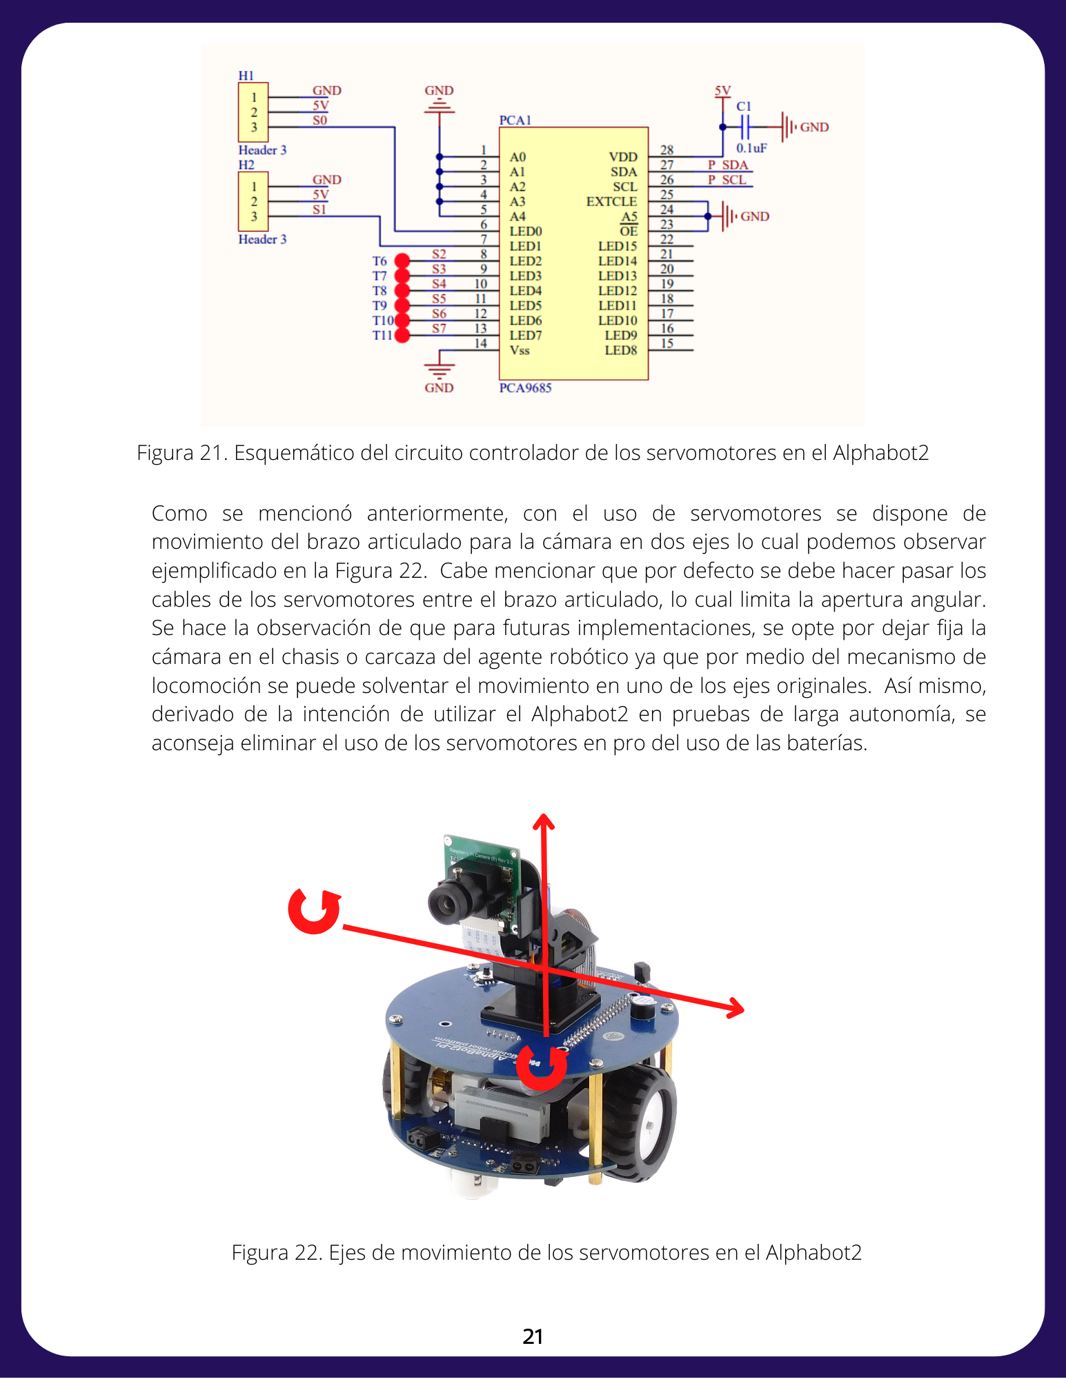
DOCUMENTOS/Images/28.png
