NIJ18482/Luis-Nij-Tesis-2022/DOCUMENTOS/Images/29.png

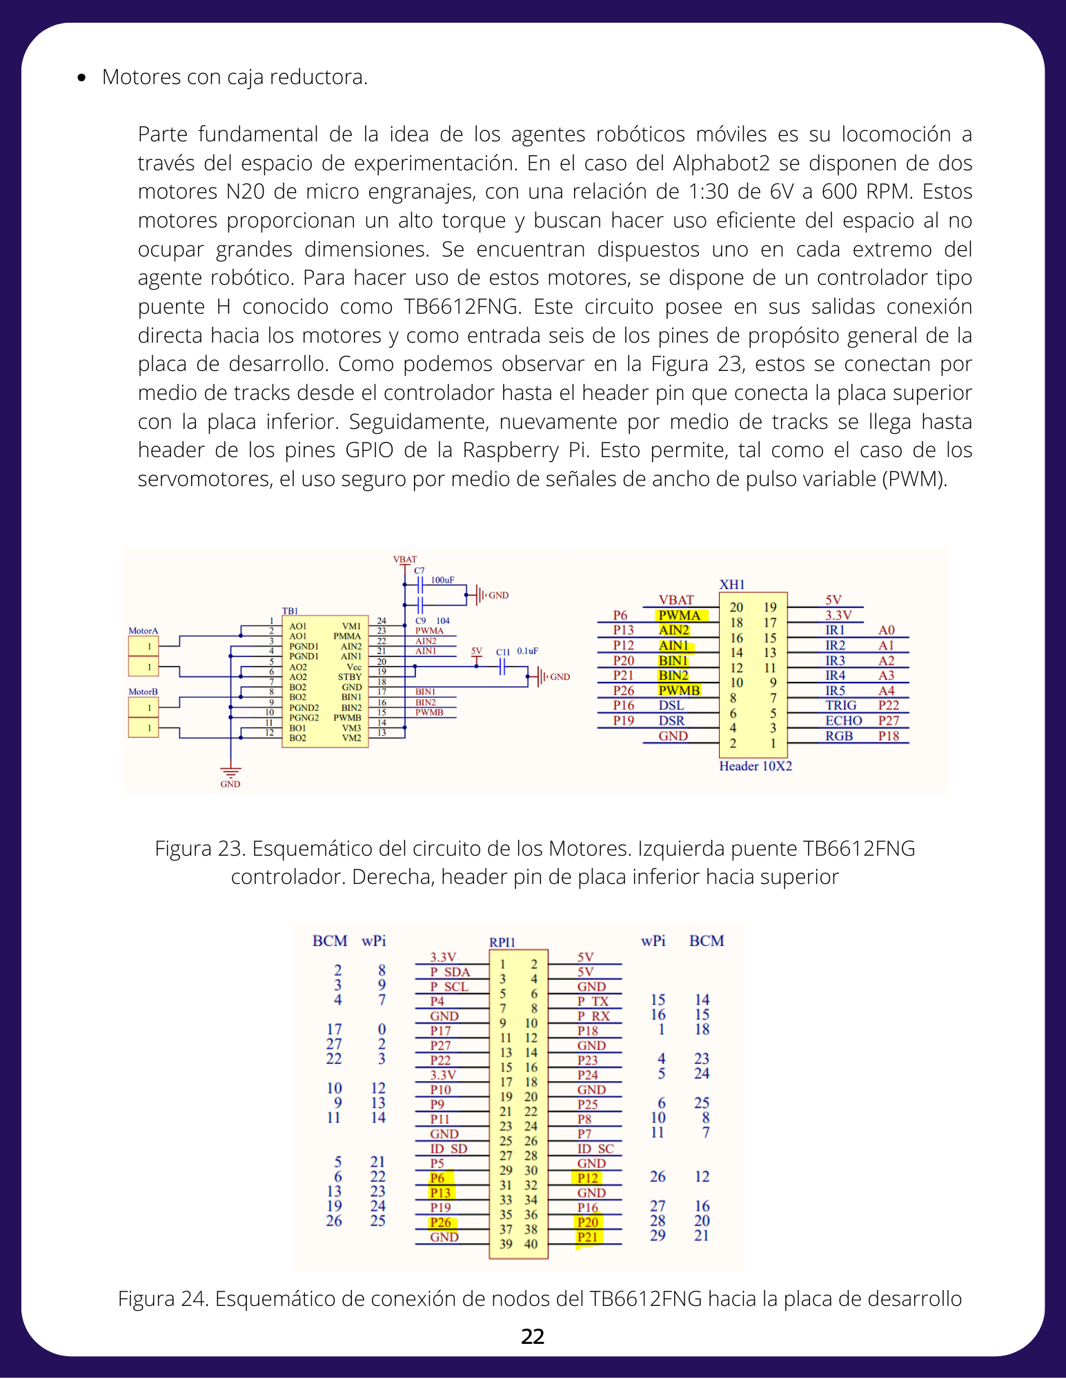
DOCUMENTOS/Images/29.png
