NIJ18482/Luis-Nij-Tesis-2022/DOCUMENTOS/Images/30.png

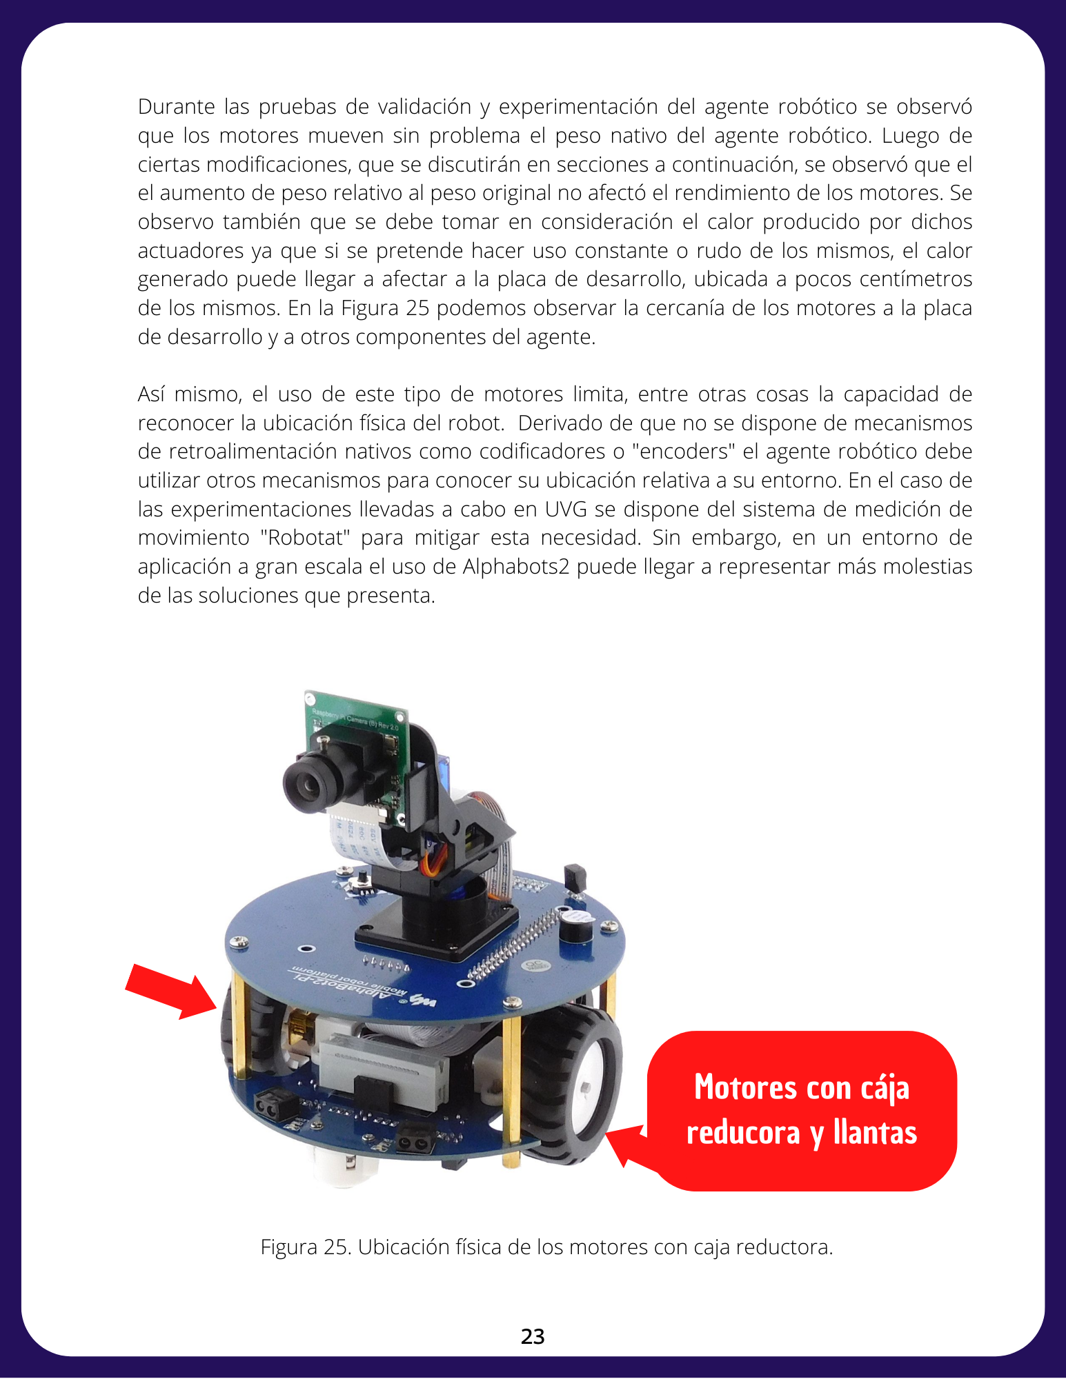
DOCUMENTOS/Images/30.png
