NIJ18482/Luis-Nij-Tesis-2022/DOCUMENTOS/Images/31.png

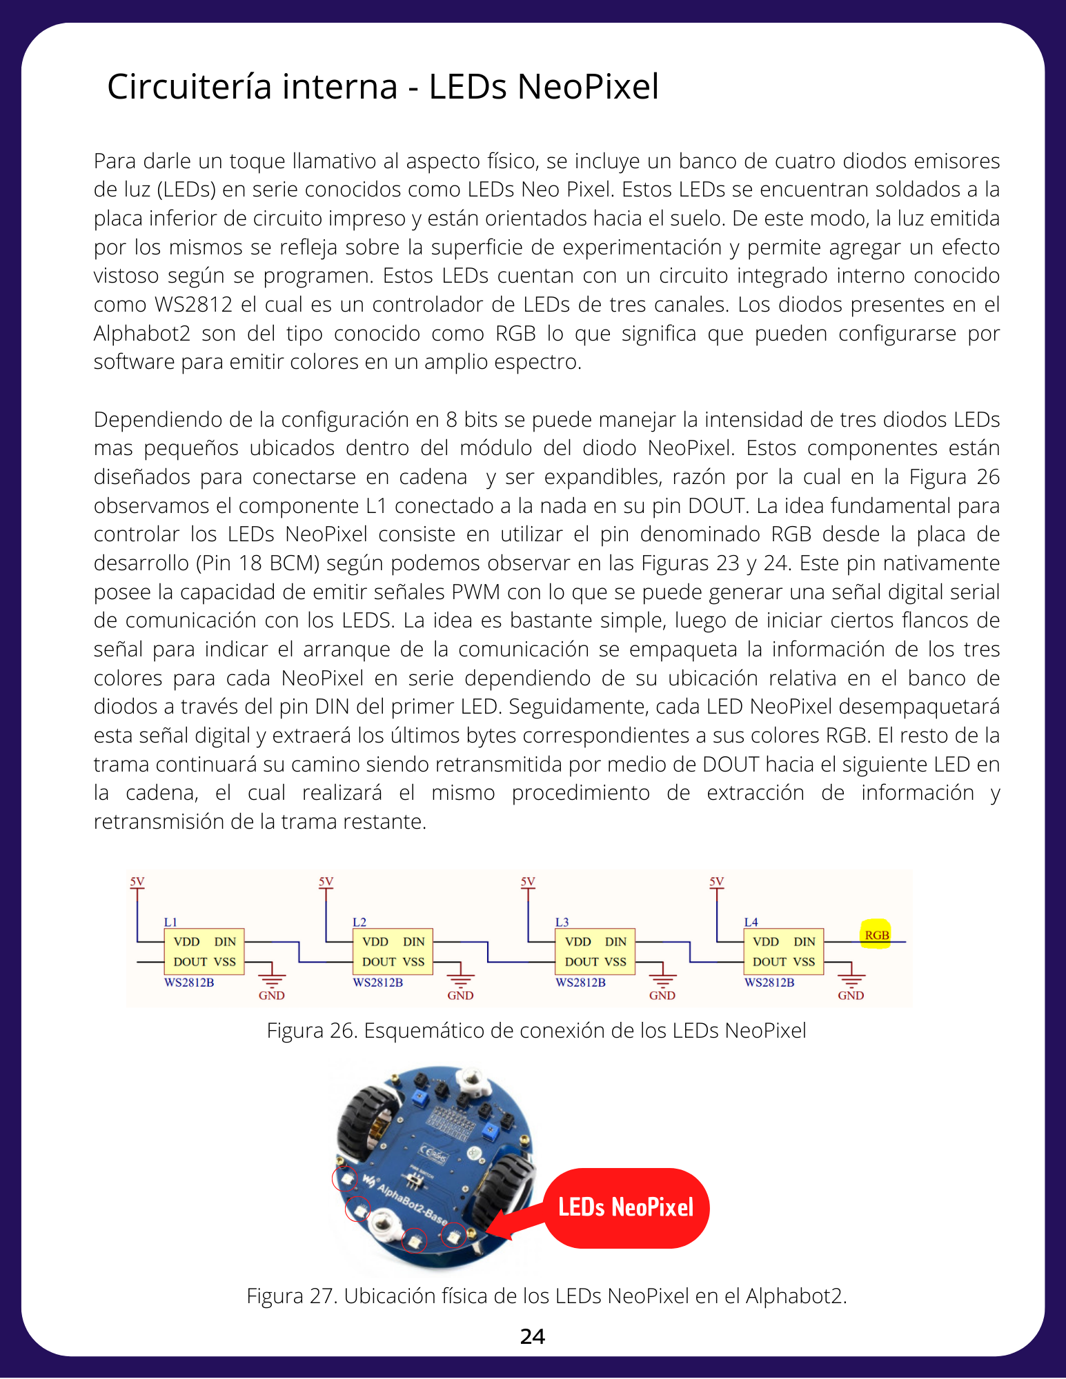
DOCUMENTOS/Images/31.png
