NIJ18482/Luis-Nij-Tesis-2022/DOCUMENTOS/Images/32.png

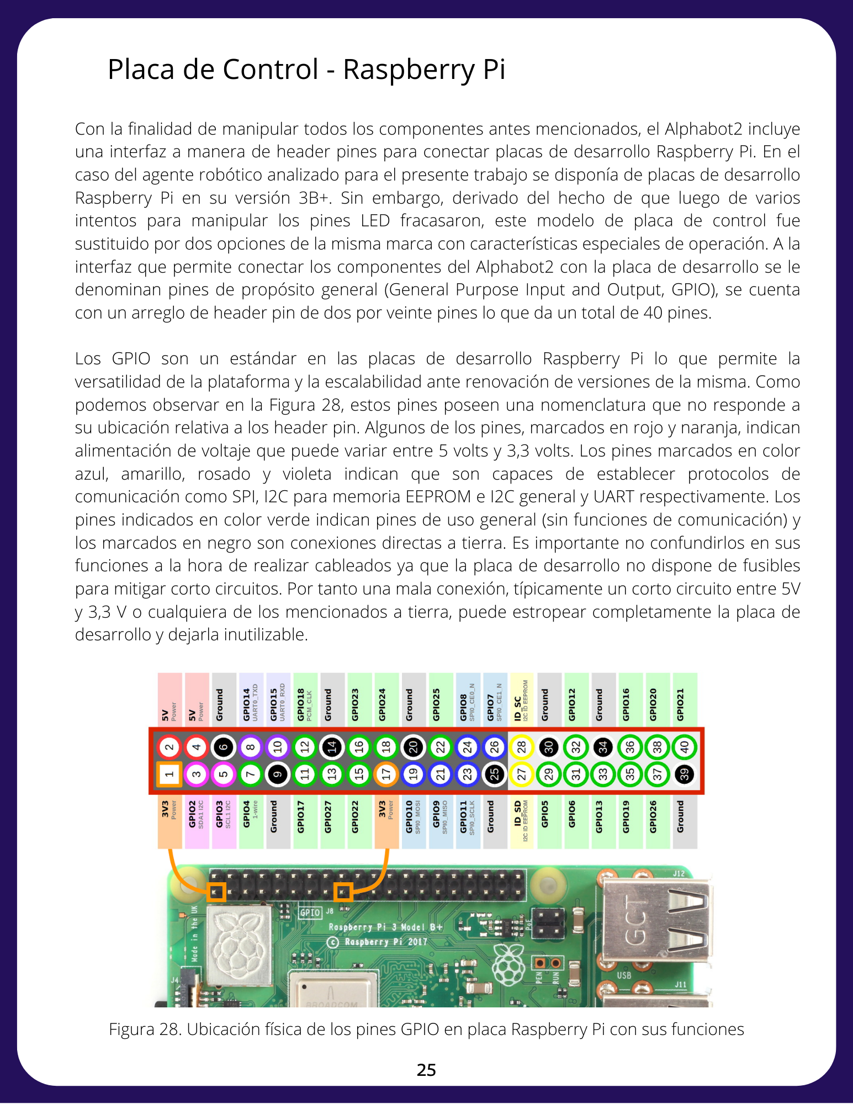
DOCUMENTOS/Images/32.png
