NIJ18482/Luis-Nij-Tesis-2022/DOCUMENTOS/Images/33.png

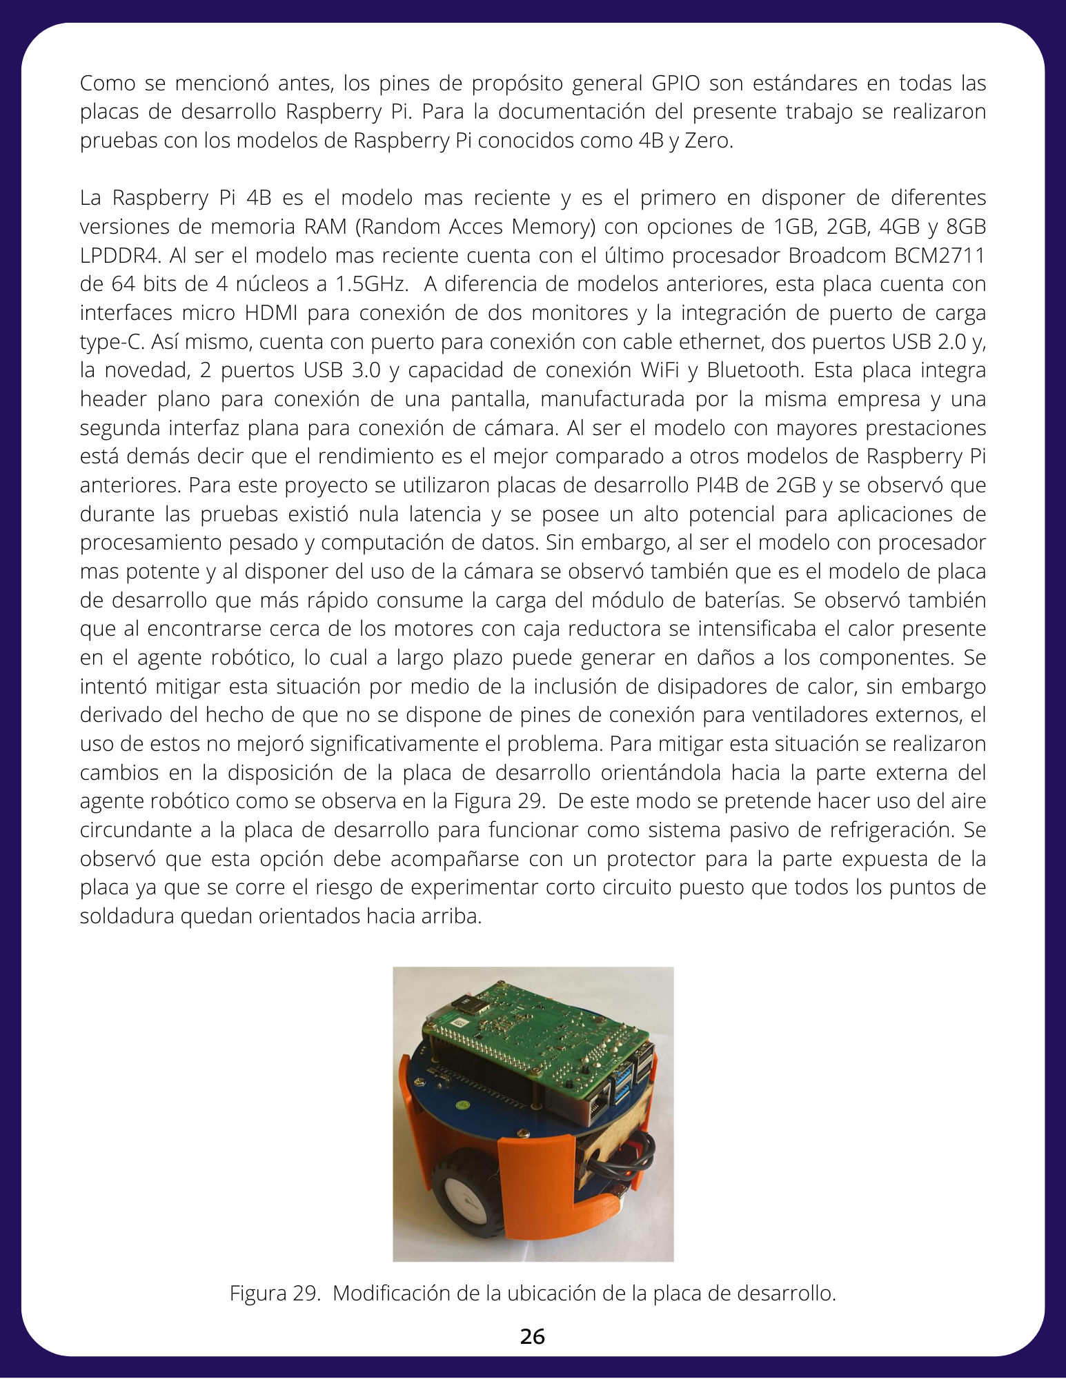
DOCUMENTOS/Images/33.png
