NIJ18482/Luis-Nij-Tesis-2022/DOCUMENTOS/Images/34.png

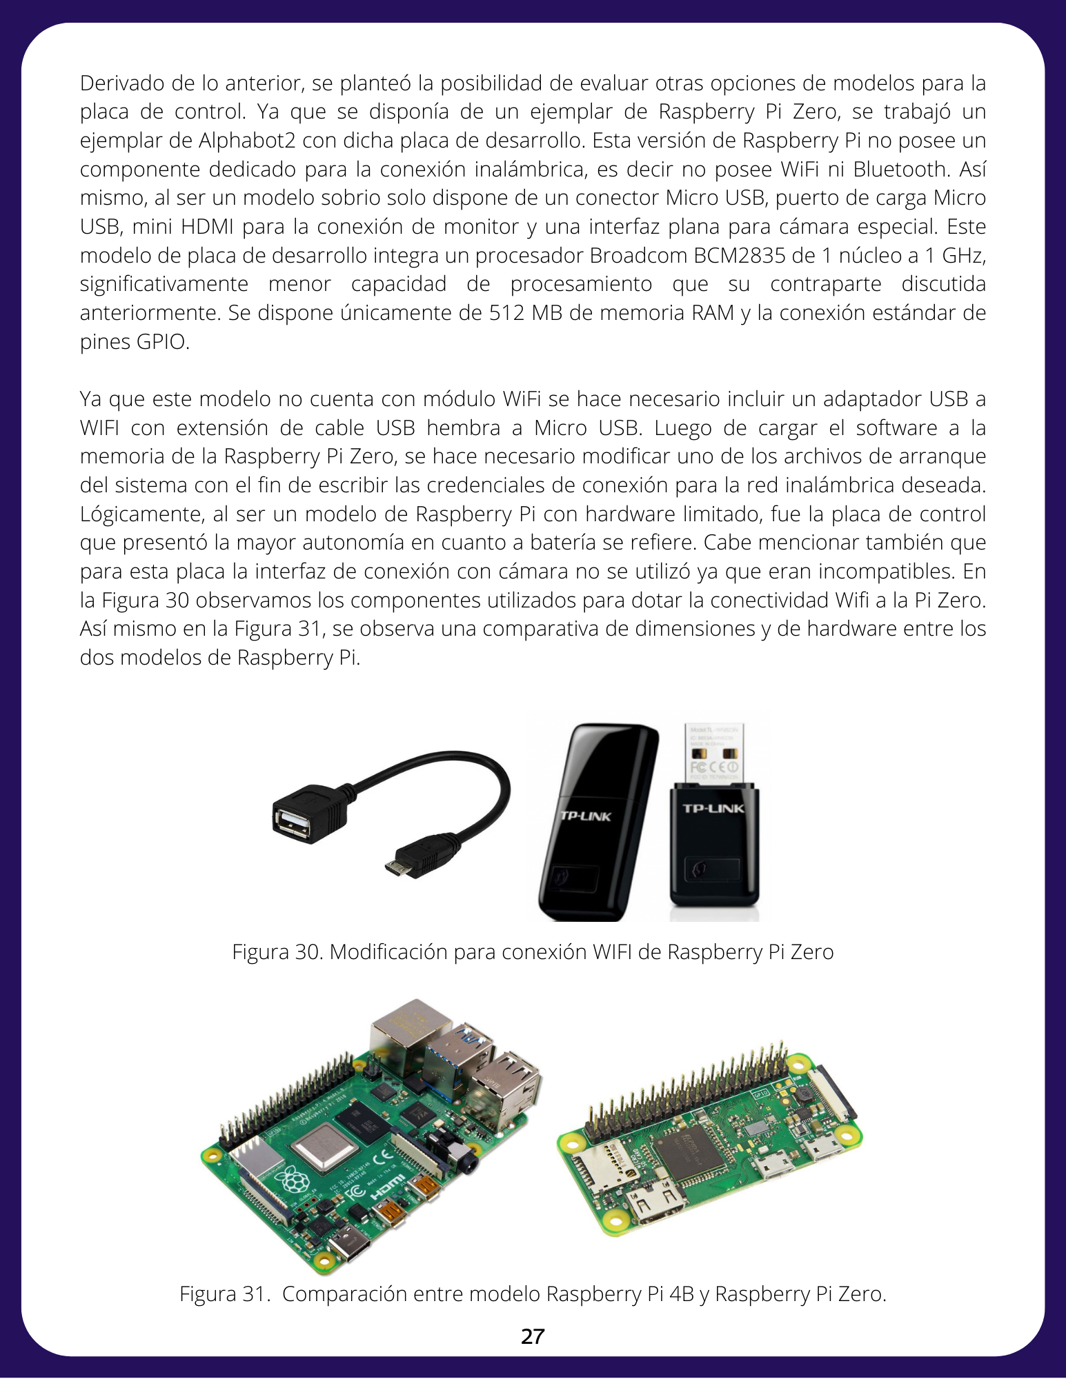
DOCUMENTOS/Images/34.png
