NIJ18482/Luis-Nij-Tesis-2022/DOCUMENTOS/Images/35.png

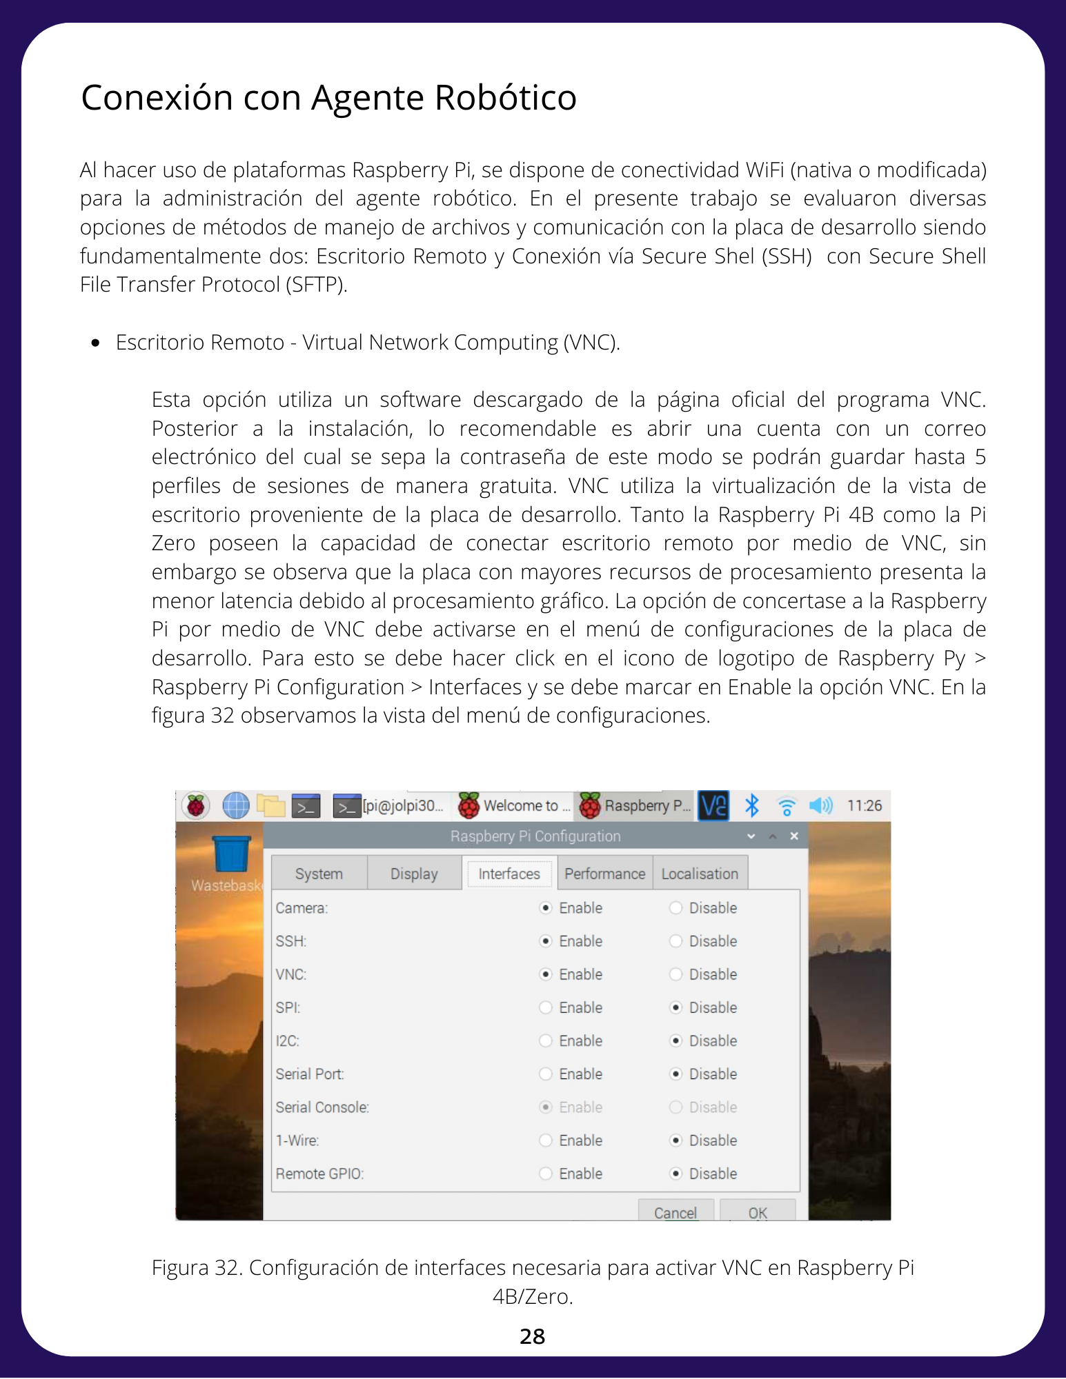
DOCUMENTOS/Images/35.png
