NIJ18482/Luis-Nij-Tesis-2022/DOCUMENTOS/Images/36.png

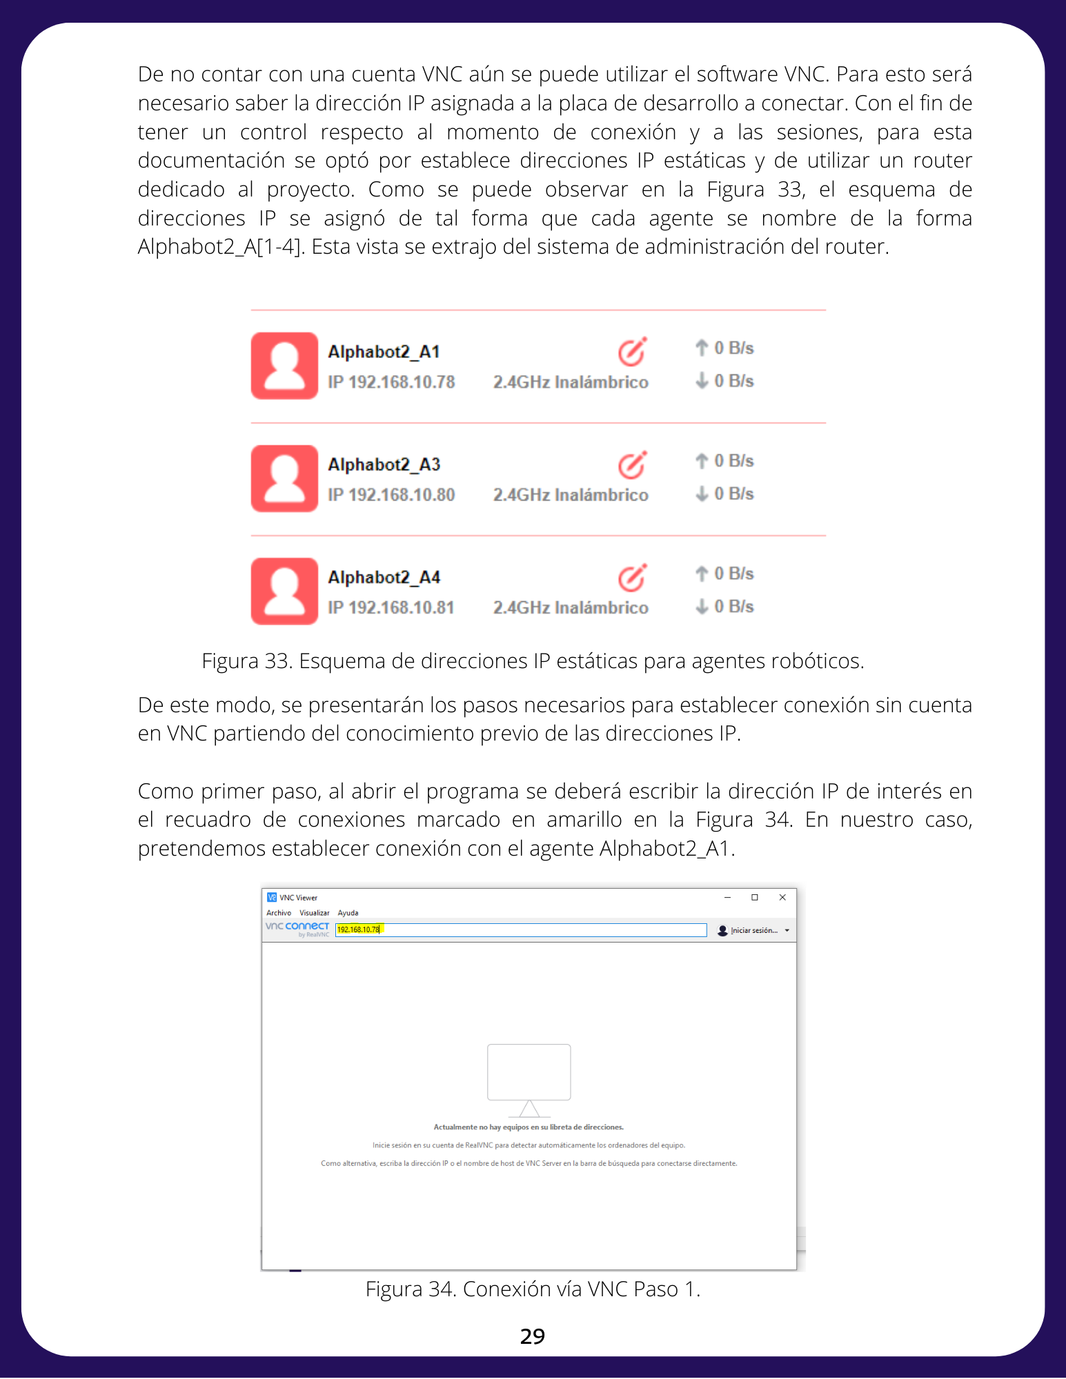
DOCUMENTOS/Images/36.png
