NIJ18482/Luis-Nij-Tesis-2022/DOCUMENTOS/Images/37.png

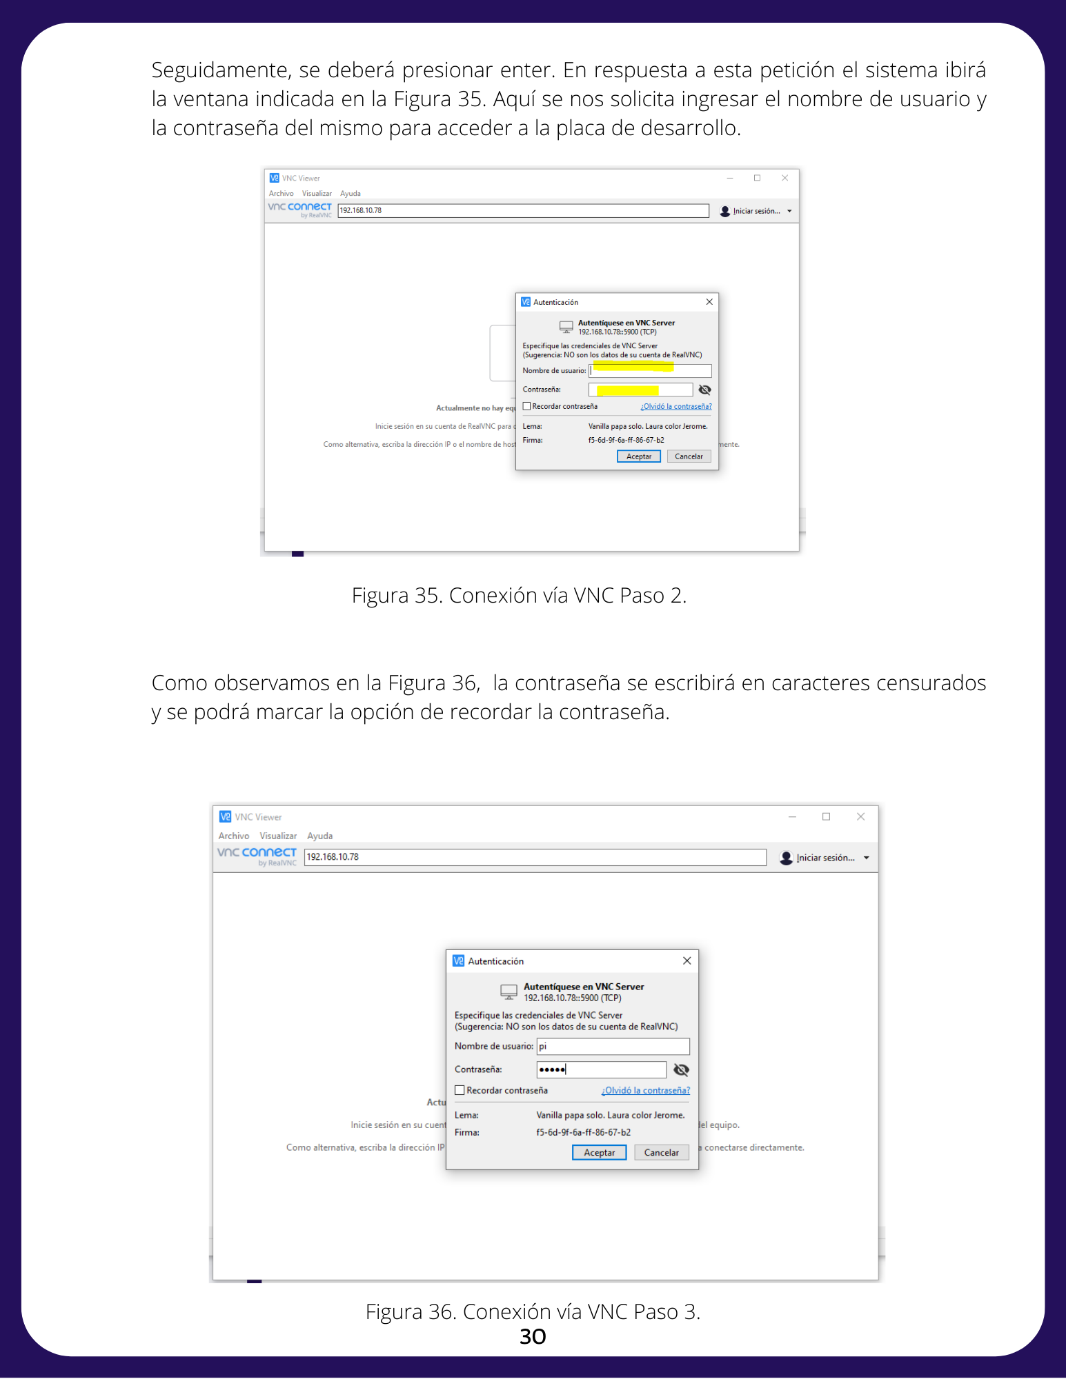
DOCUMENTOS/Images/37.png
