NIJ18482/Luis-Nij-Tesis-2022/DOCUMENTOS/Images/38.png

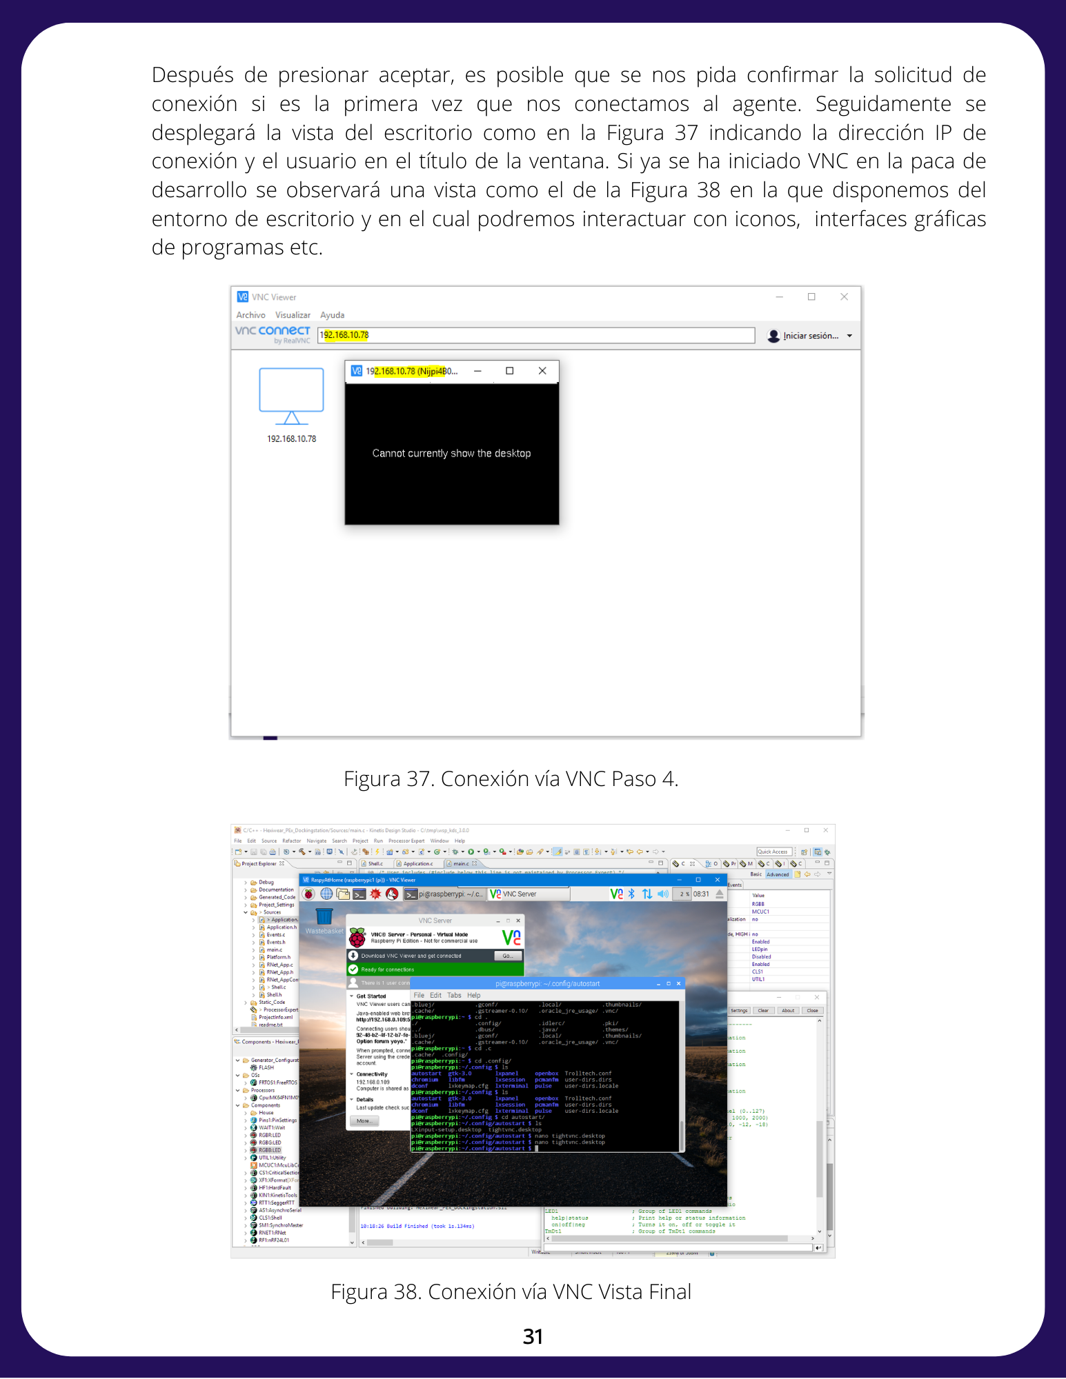
DOCUMENTOS/Images/38.png
