NIJ18482/Luis-Nij-Tesis-2022/DOCUMENTOS/Images/39.png

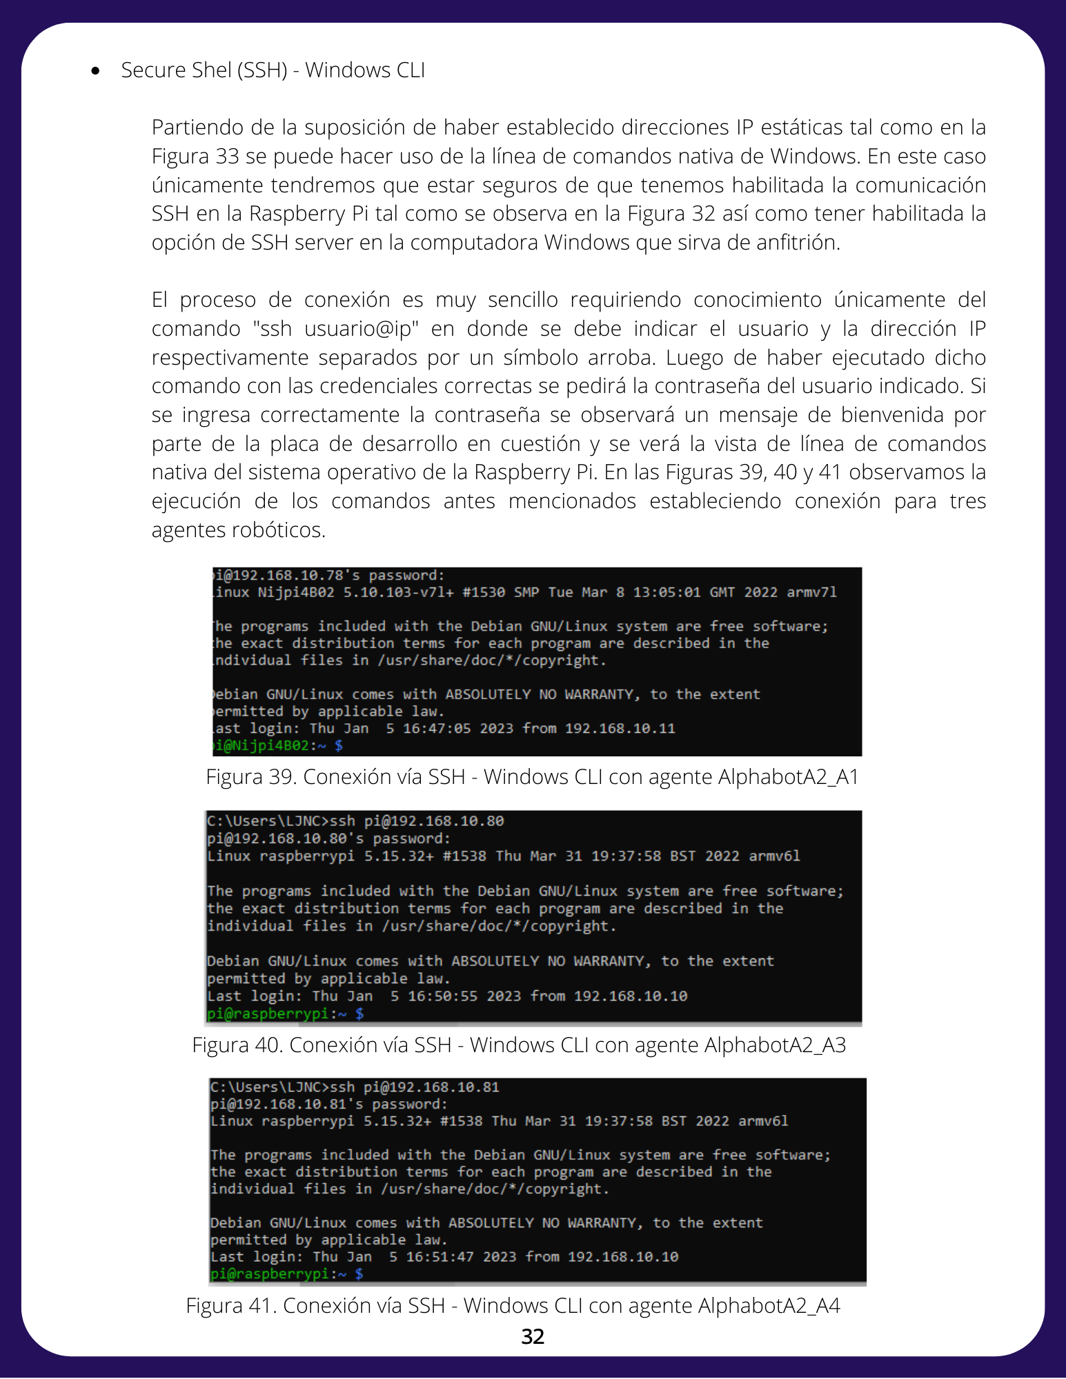
DOCUMENTOS/Images/39.png
