NIJ18482/Luis-Nij-Tesis-2022/DOCUMENTOS/Images/40.png

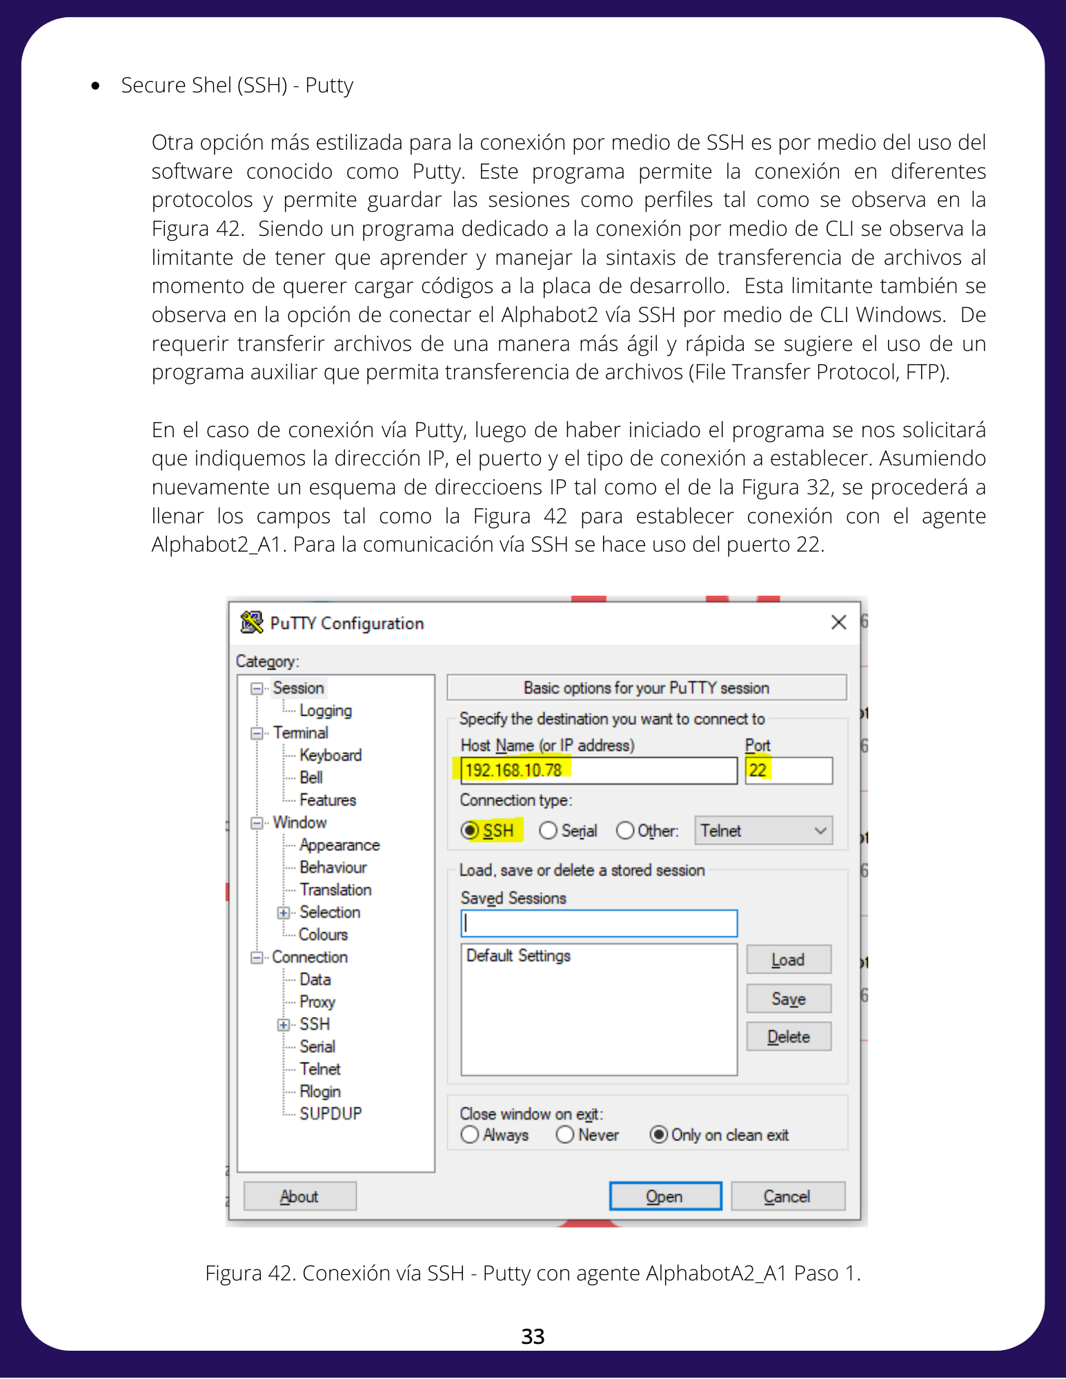
DOCUMENTOS/Images/40.png
