NIJ18482/Luis-Nij-Tesis-2022/DOCUMENTOS/Images/41.png

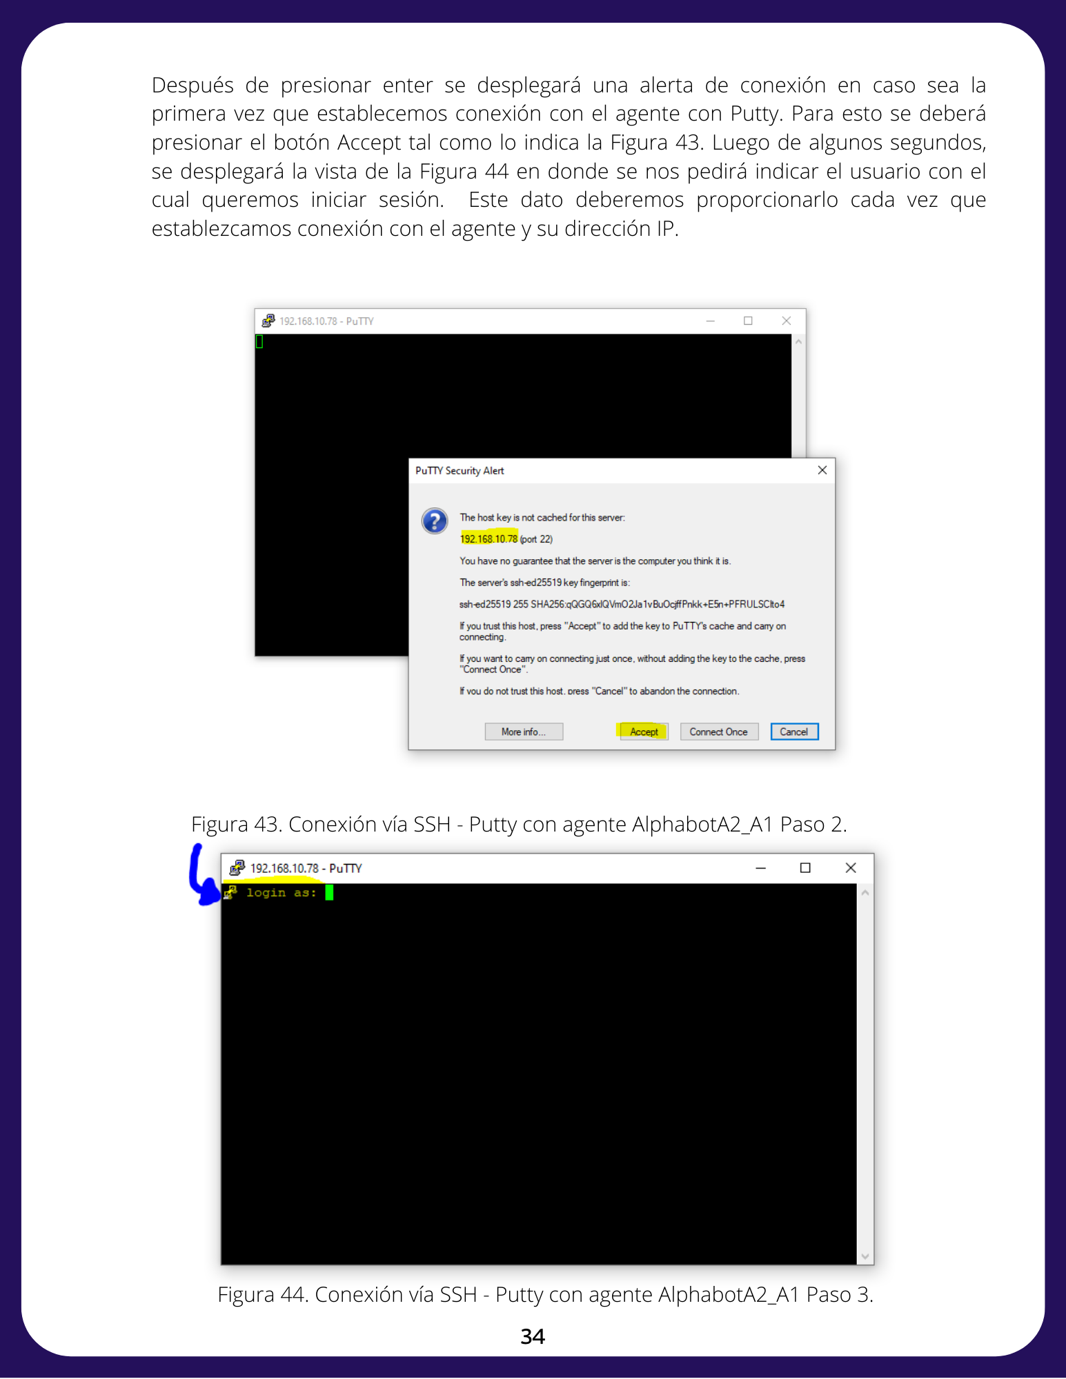
DOCUMENTOS/Images/41.png
