NIJ18482/Luis-Nij-Tesis-2022/DOCUMENTOS/Images/42.png

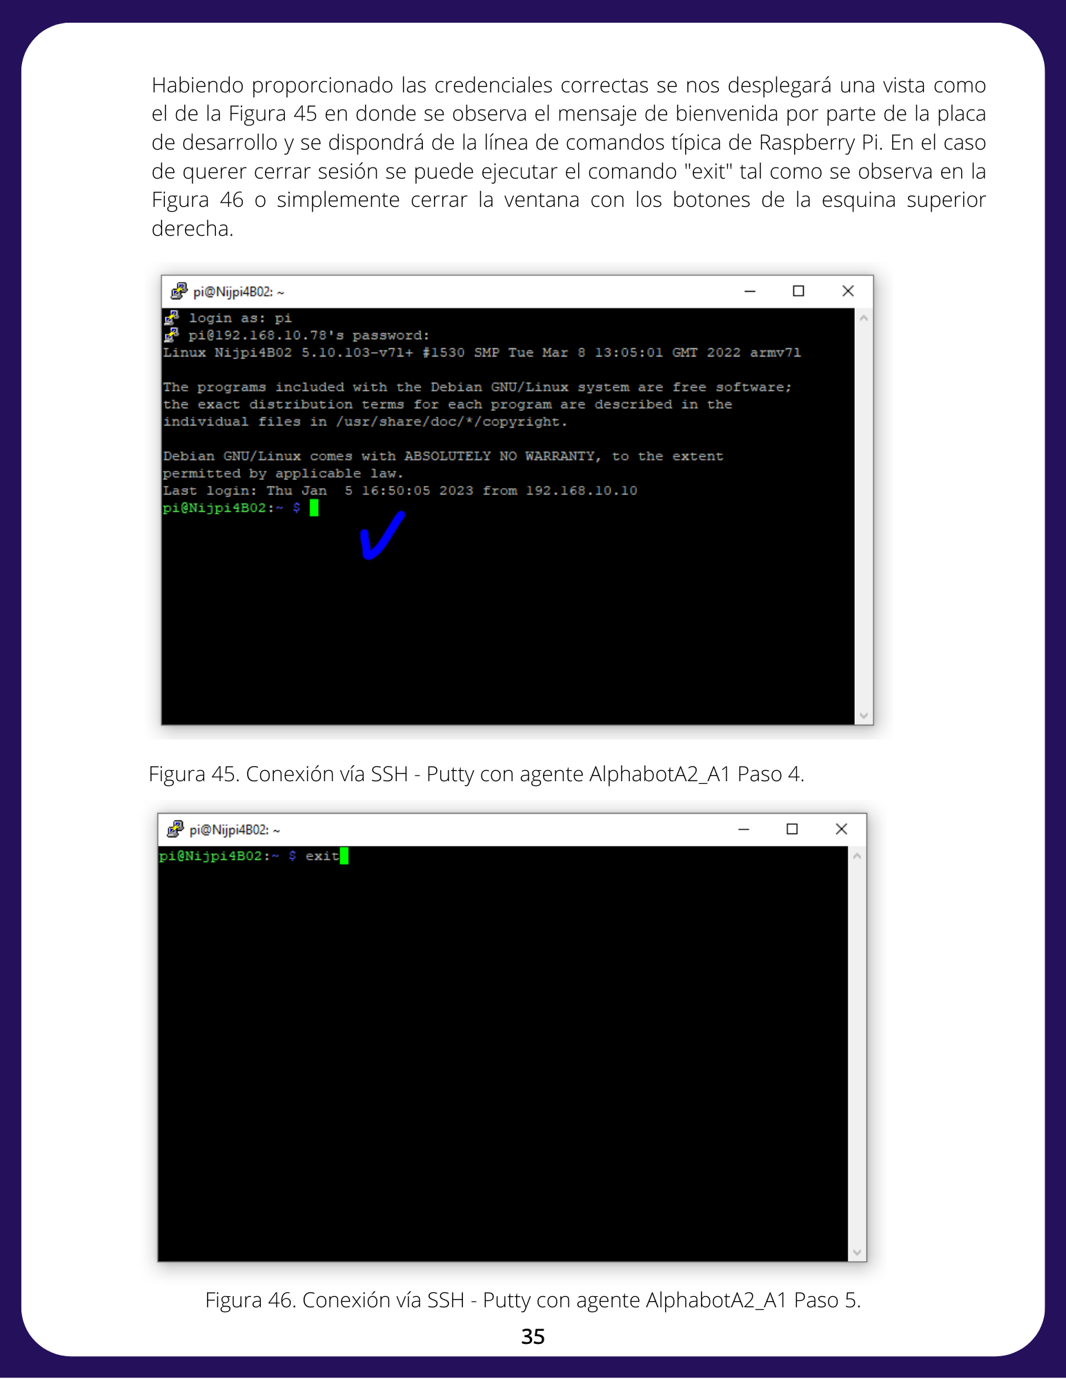
DOCUMENTOS/Images/42.png
