NIJ18482/Luis-Nij-Tesis-2022/DOCUMENTOS/Images/43.png

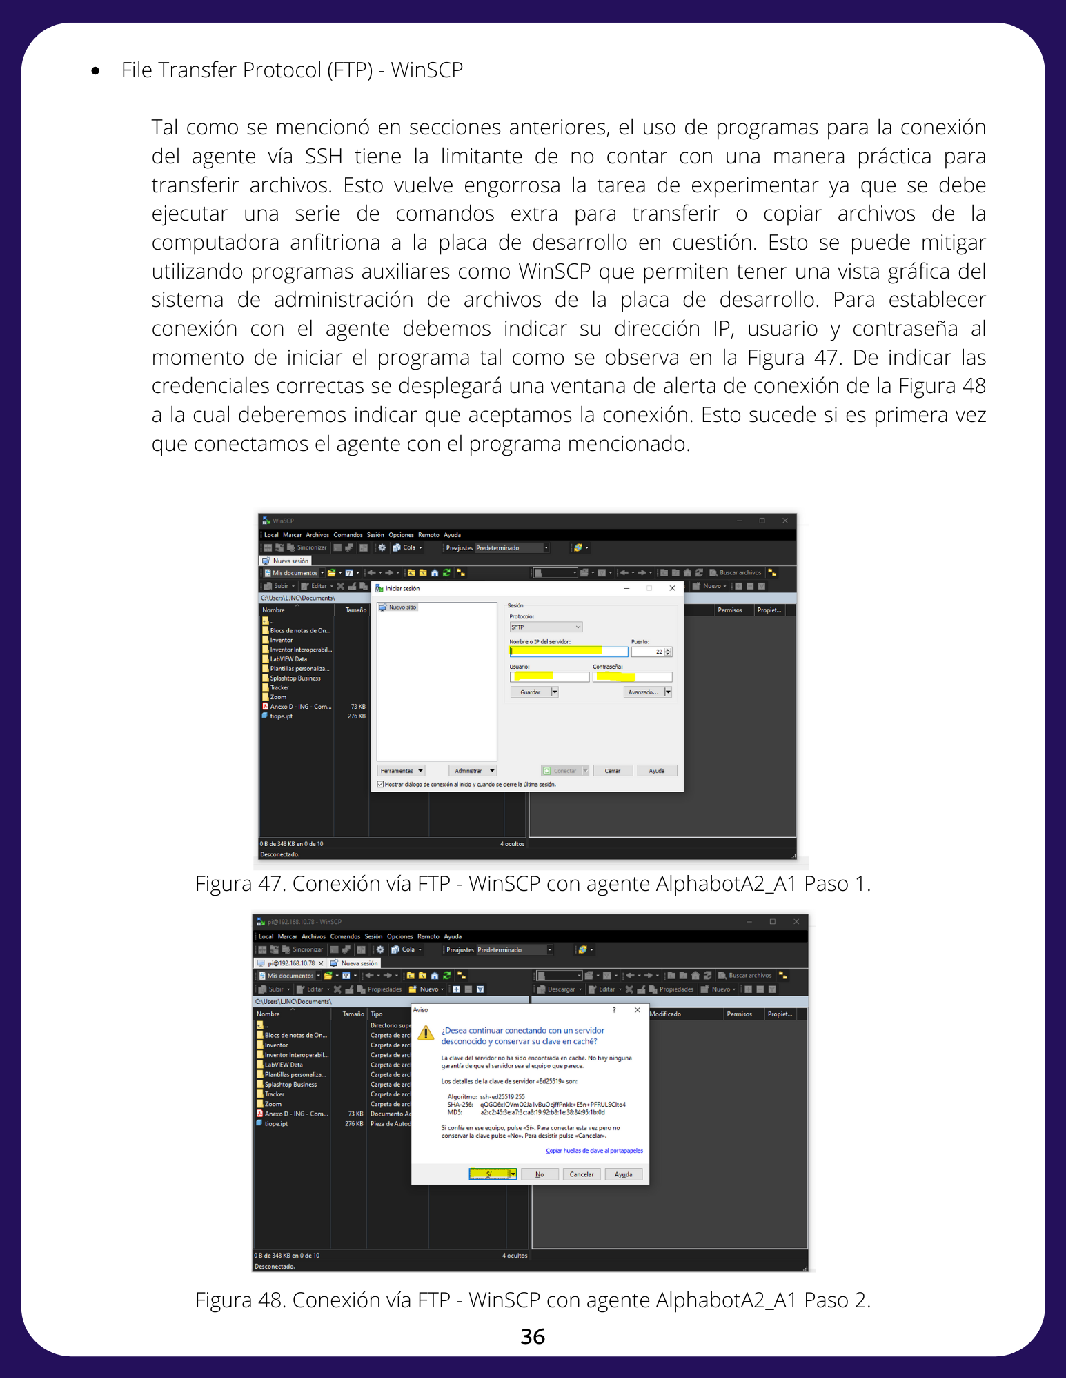
DOCUMENTOS/Images/43.png
