NIJ18482/Luis-Nij-Tesis-2022/DOCUMENTOS/Images/44.png

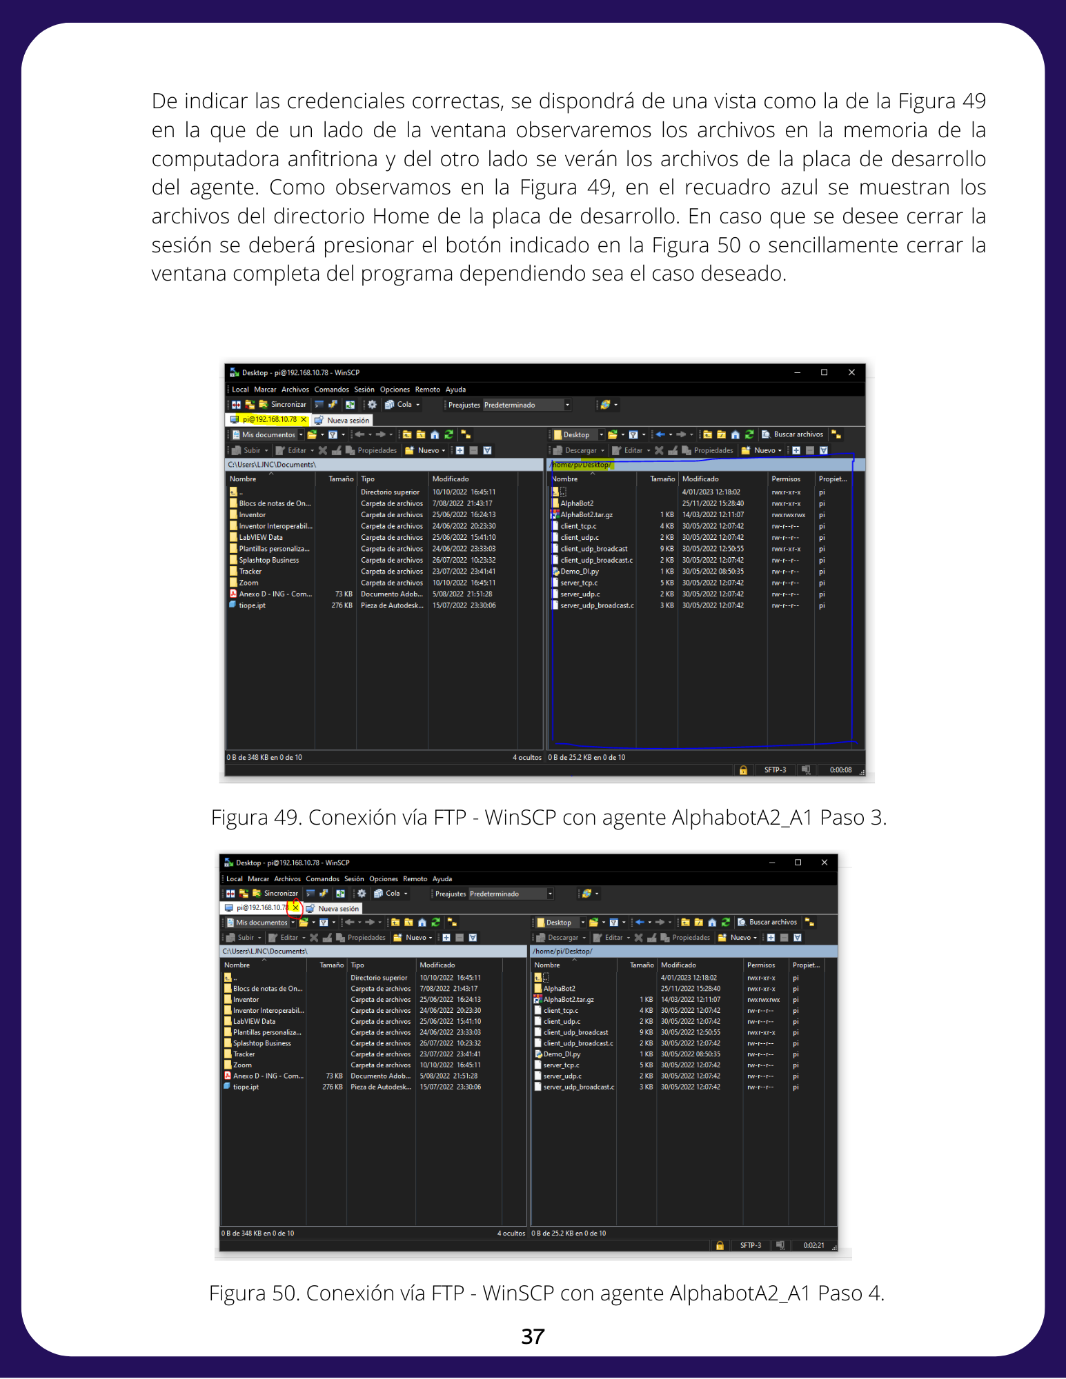
DOCUMENTOS/Images/44.png
