NIJ18482/Luis-Nij-Tesis-2022/DOCUMENTOS/Images/45.png

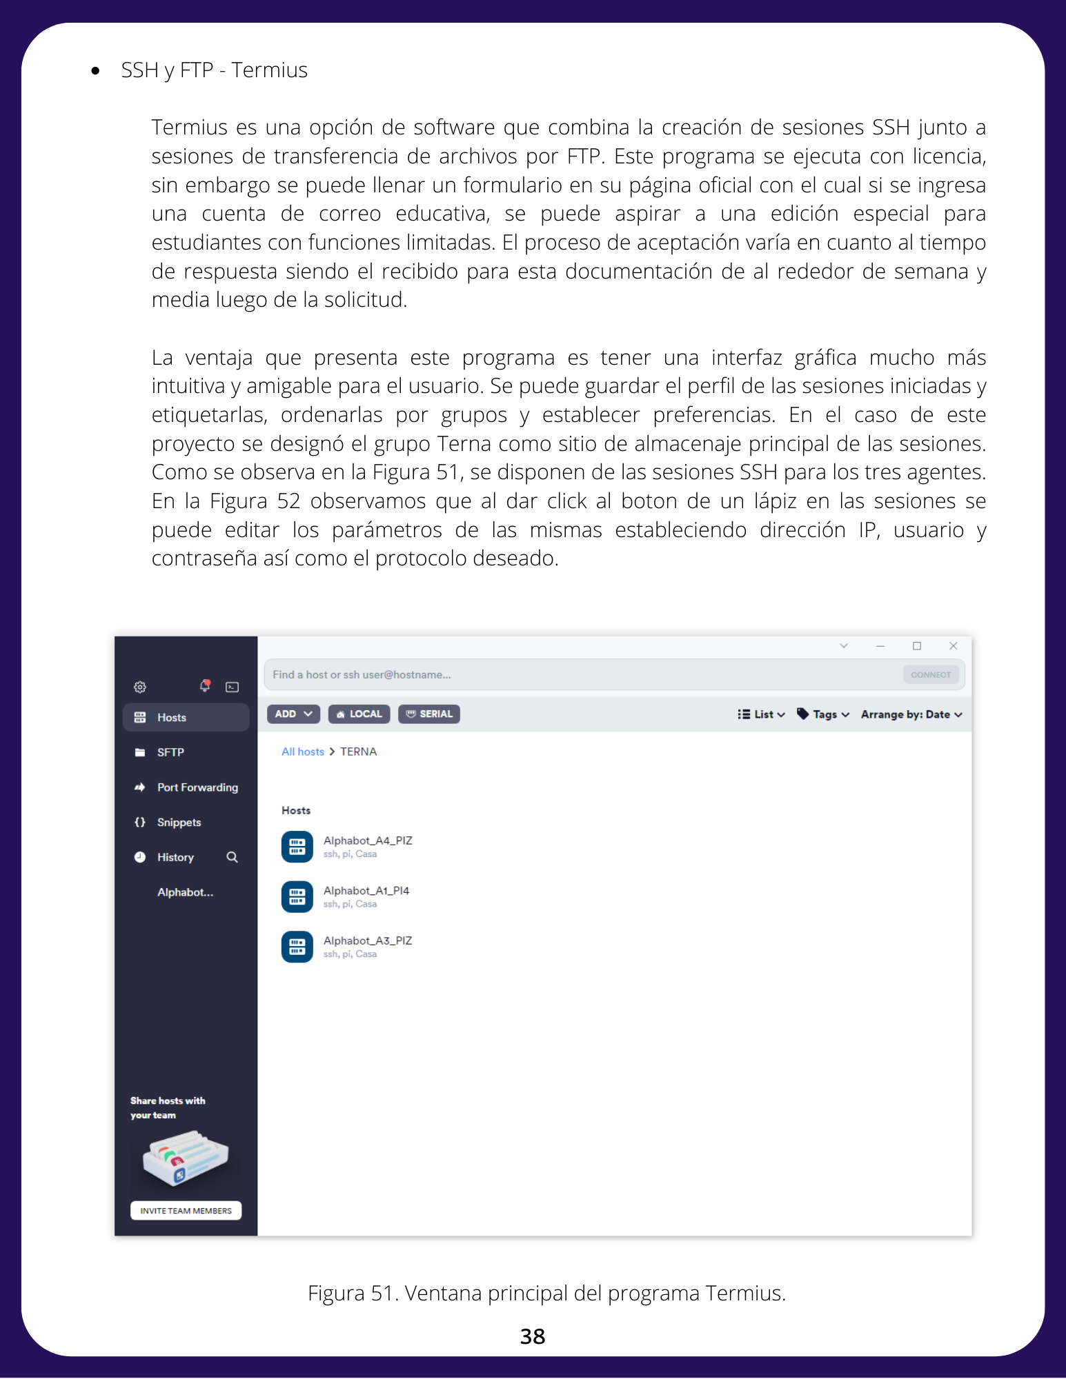
DOCUMENTOS/Images/45.png
