NIJ18482/Luis-Nij-Tesis-2022/DOCUMENTOS/Images/46.png

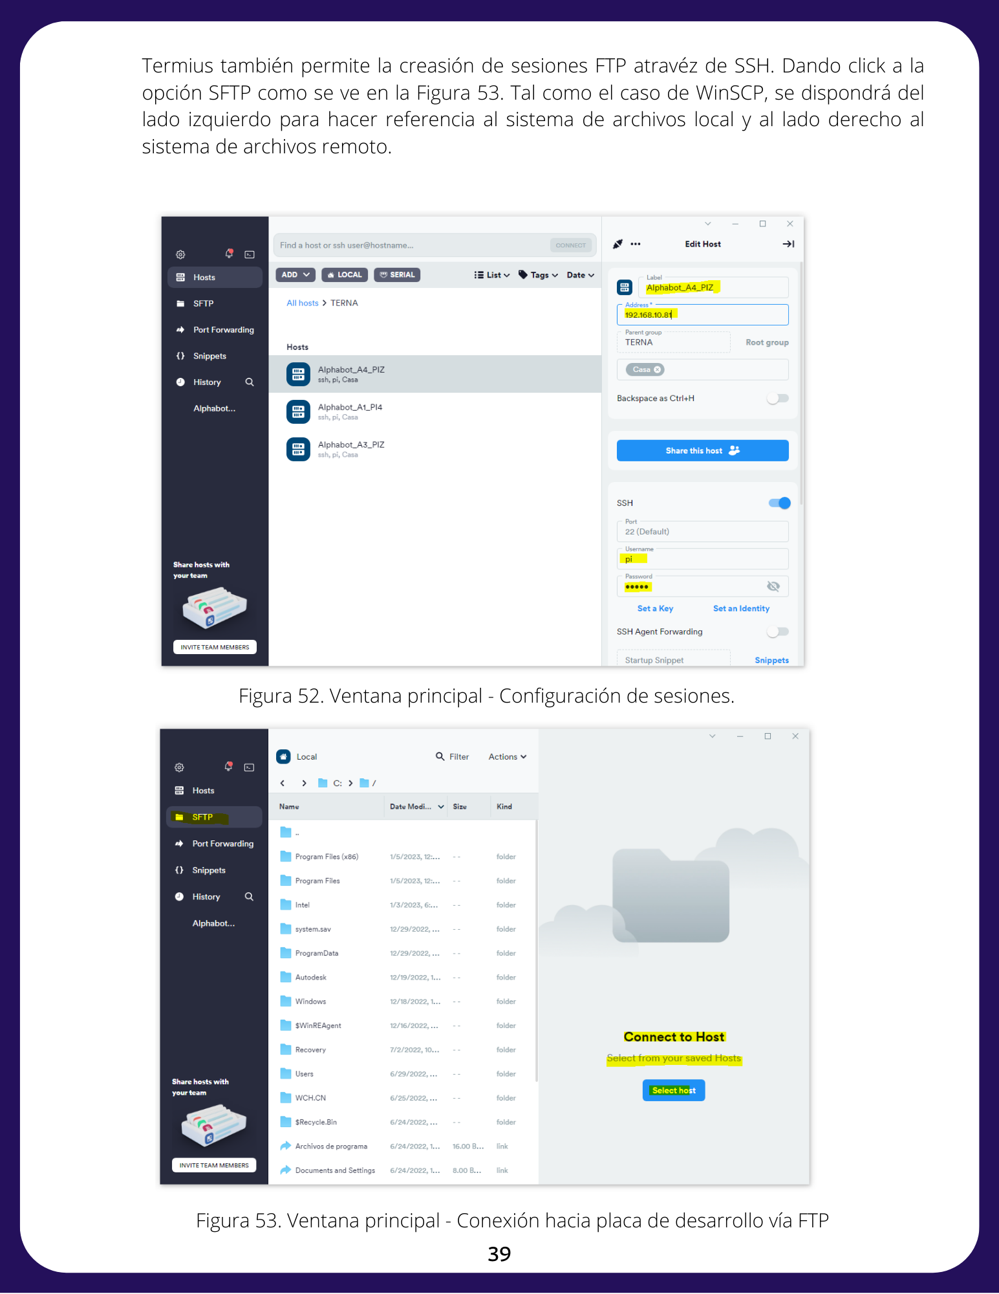
DOCUMENTOS/Images/46.png
