NIJ18482/Luis-Nij-Tesis-2022/DOCUMENTOS/Images/47.png

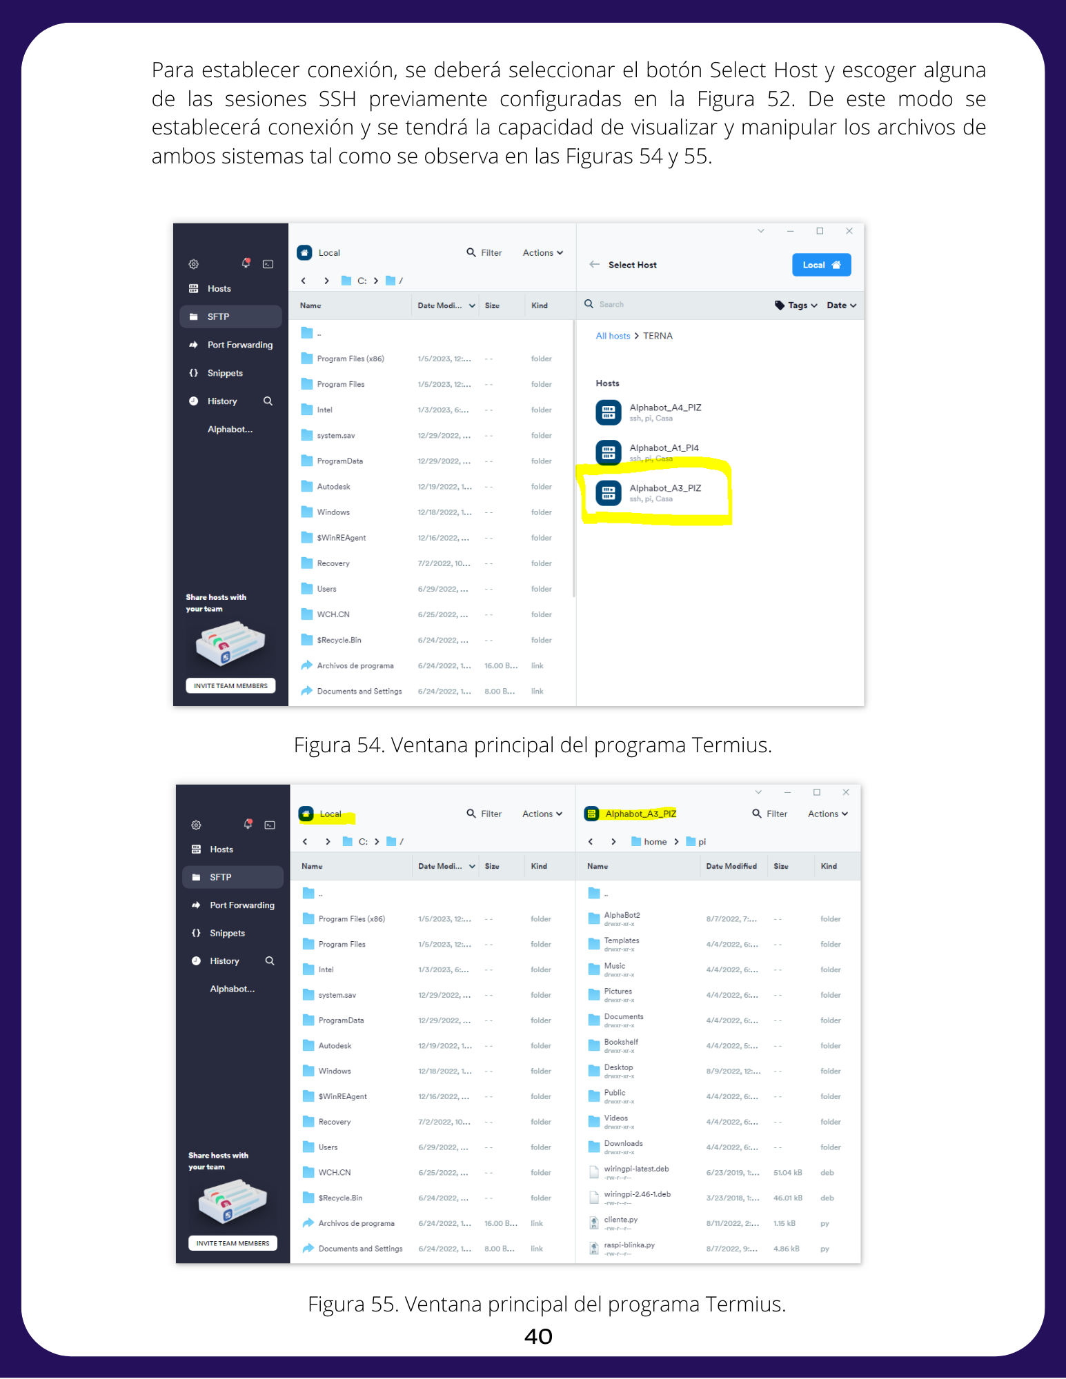
DOCUMENTOS/Images/47.png
