NIJ18482/Luis-Nij-Tesis-2022/DOCUMENTOS/Images/48.png

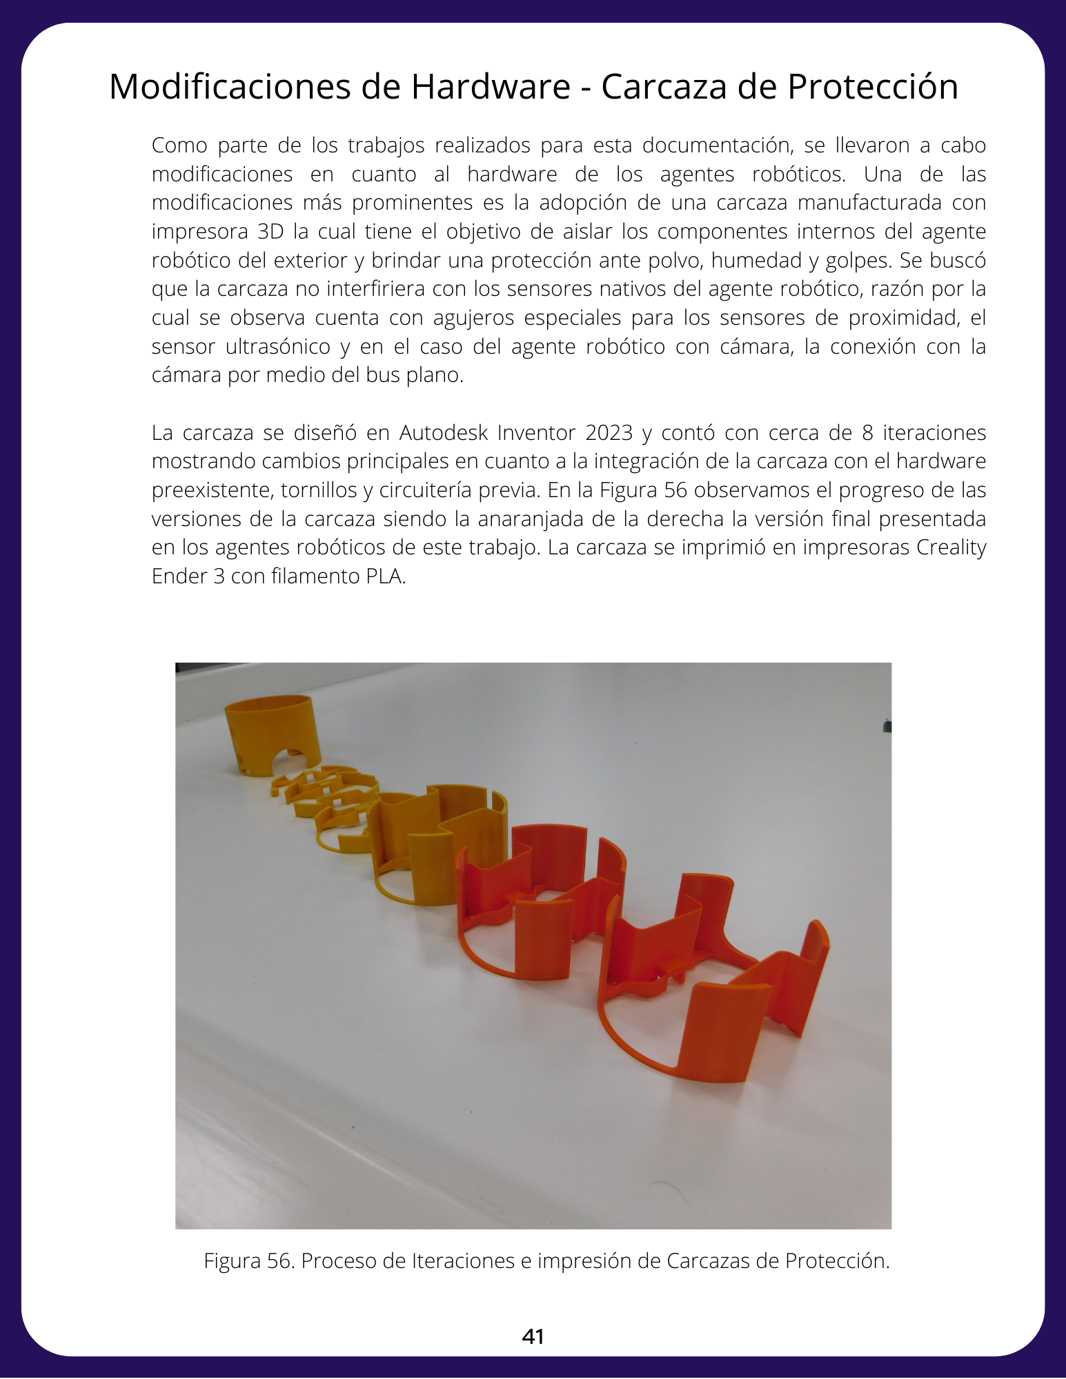
DOCUMENTOS/Images/48.png
