NIJ18482/Luis-Nij-Tesis-2022/DOCUMENTOS/Images/49.png

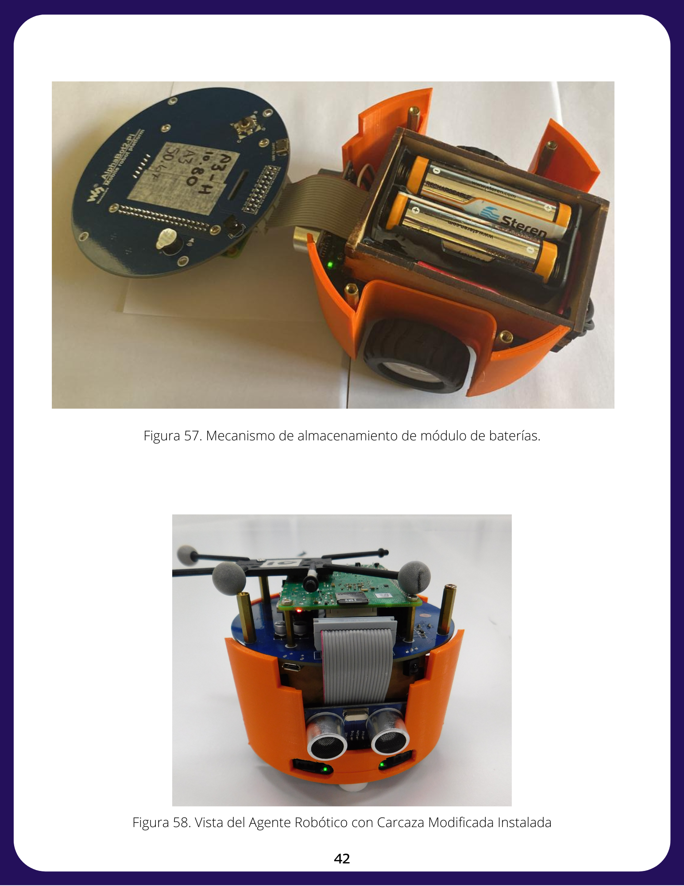
DOCUMENTOS/Images/49.png
