NIJ18482/Luis-Nij-Tesis-2022/DOCUMENTOS/Images/50.png

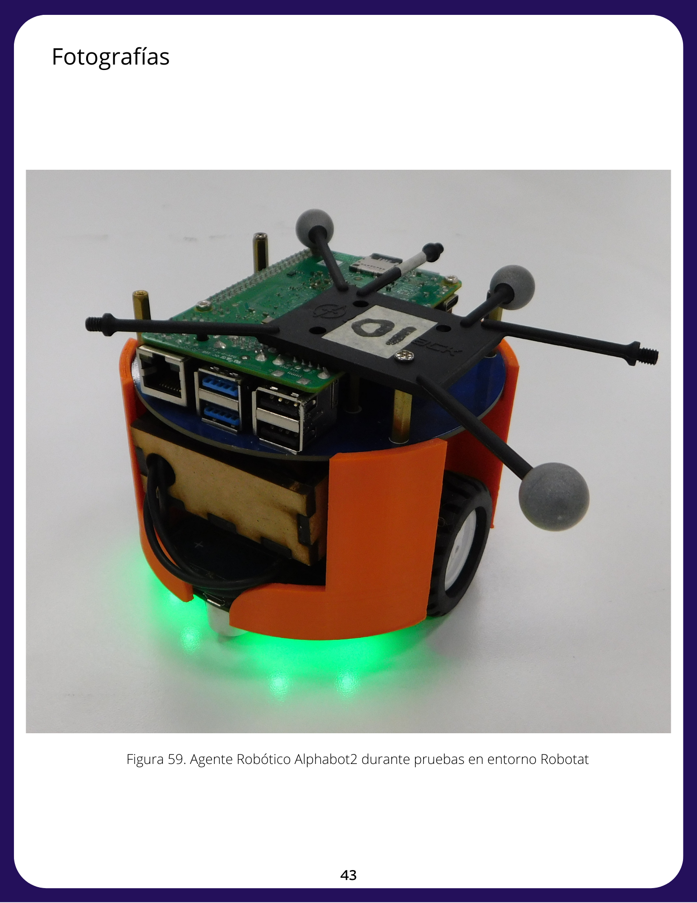
DOCUMENTOS/Images/50.png
