NIJ18482/Luis-Nij-Tesis-2022/DOCUMENTOS/Images/51.png

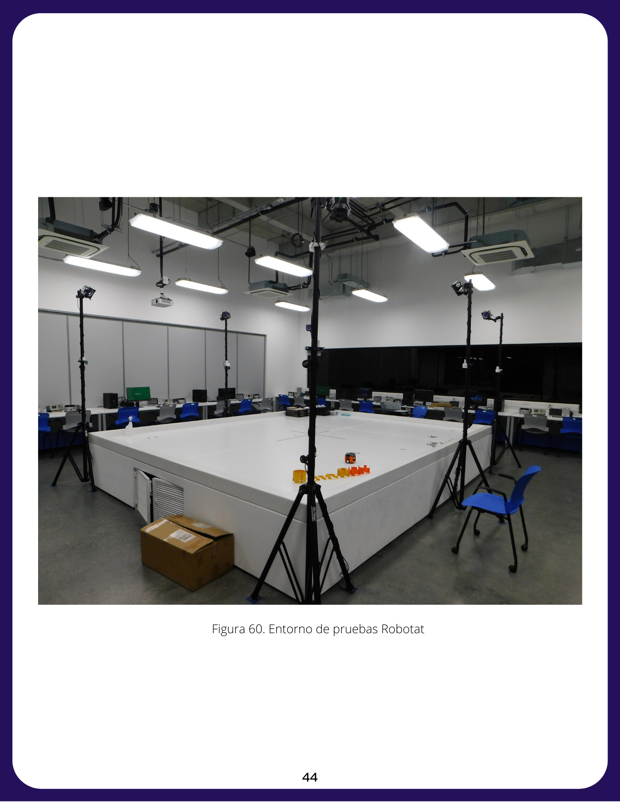
DOCUMENTOS/Images/51.png
