NIJ18482/Luis-Nij-Tesis-2022/DOCUMENTOS/Images/52.png

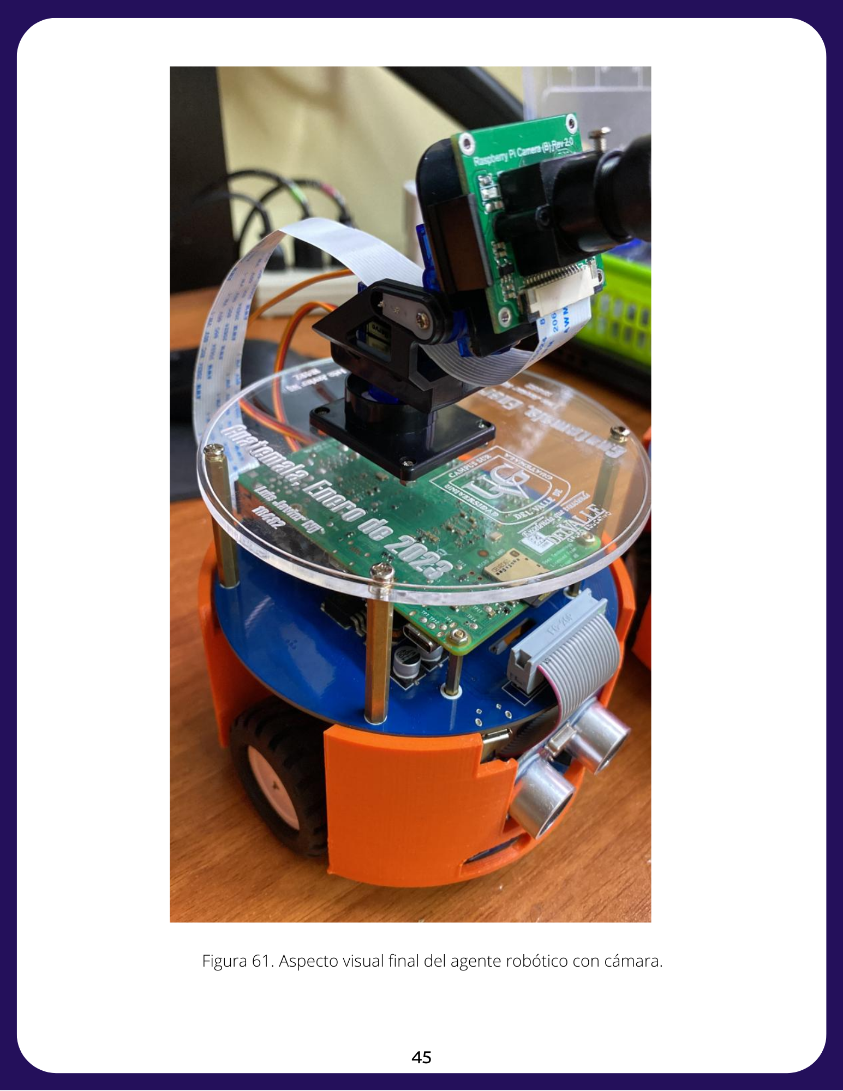
DOCUMENTOS/Images/52.png
