NIJ18482/Luis-Nij-Tesis-2022/DOCUMENTOS/Images/53.png

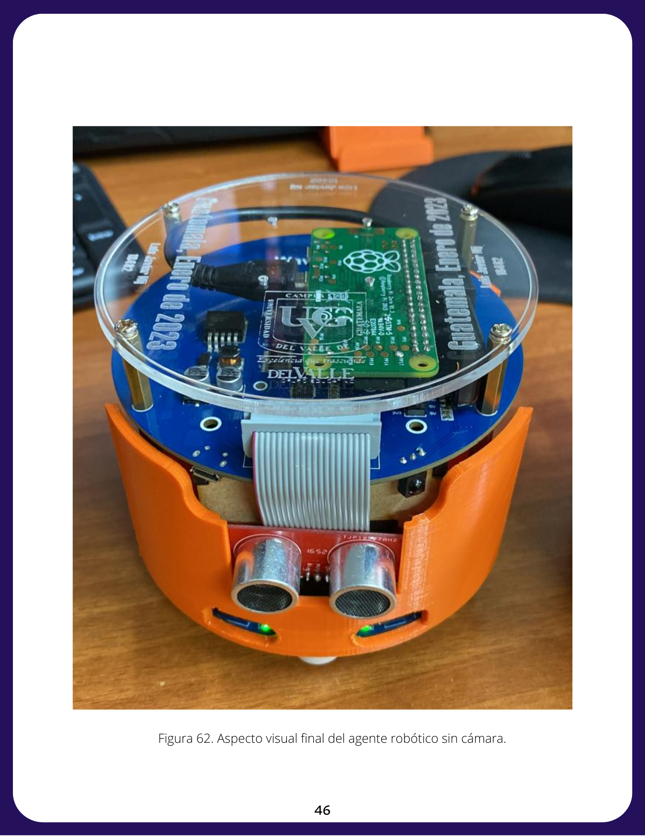
DOCUMENTOS/Images/53.png
