NIJ18482/Luis-Nij-Tesis-2022/DOCUMENTOS/Images/54.png

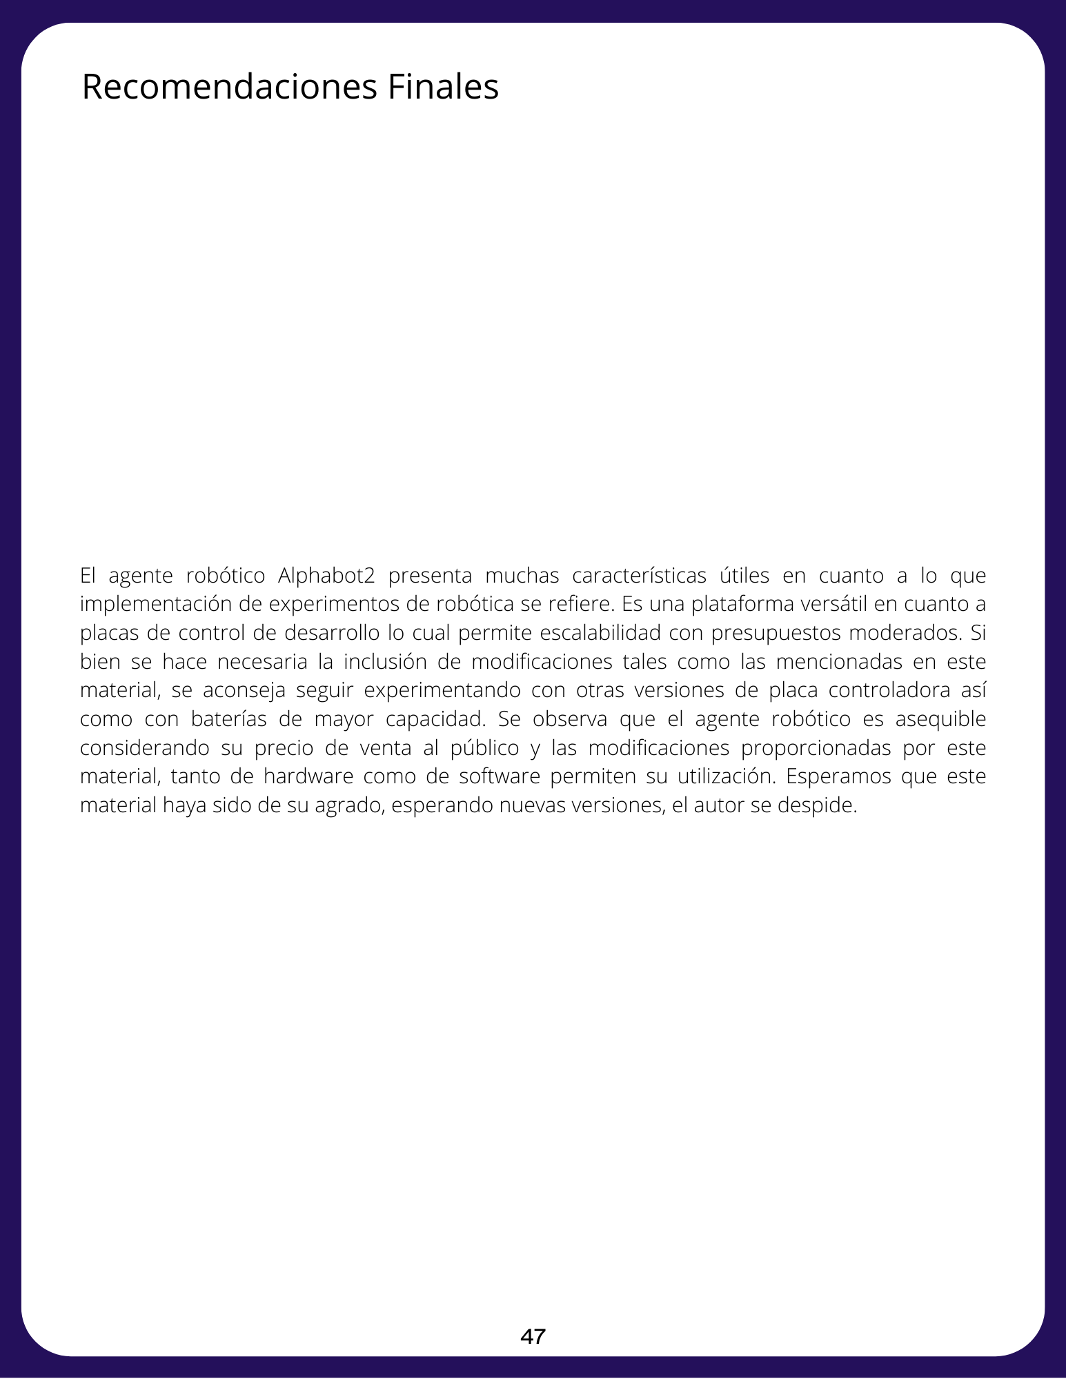
DOCUMENTOS/Images/54.png
