NIJ18482/Luis-Nij-Tesis-2022/MODELADO 3D Y ENSAMBLAJES/ARCHIVOS DE IMPRESION/Carcaza04.obj

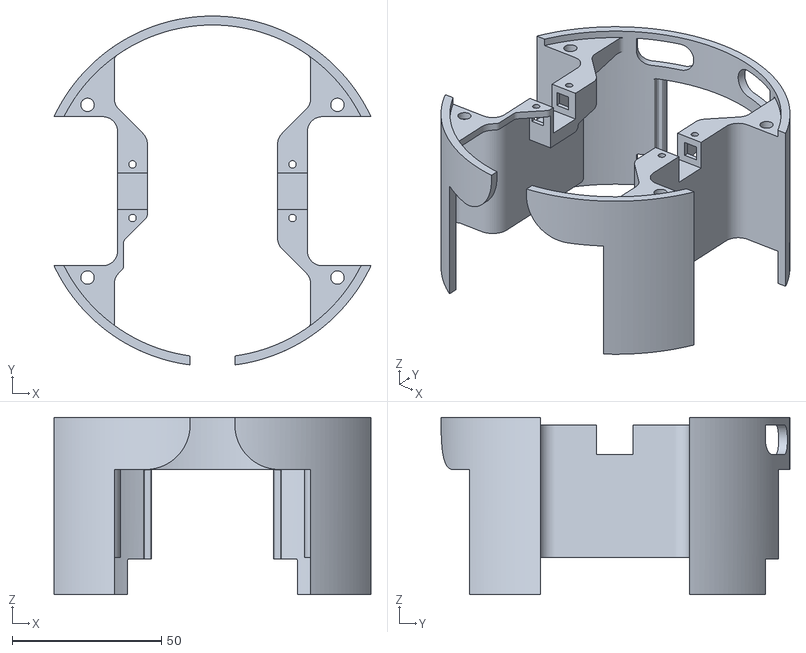
[picture p55: CAD file, 2024-04-12]
MODELADO 3D Y ENSAMBLAJES/ARCHIVOS DE IMPRESION/Carcaza04.obj
106.3 x 117.0 x 59.5
