NIJ18482/Luis-Nij-Tesis-2022/MODELADO 3D Y ENSAMBLAJES/ARCHIVOS DE IMPRESION/Carcazav2.obj

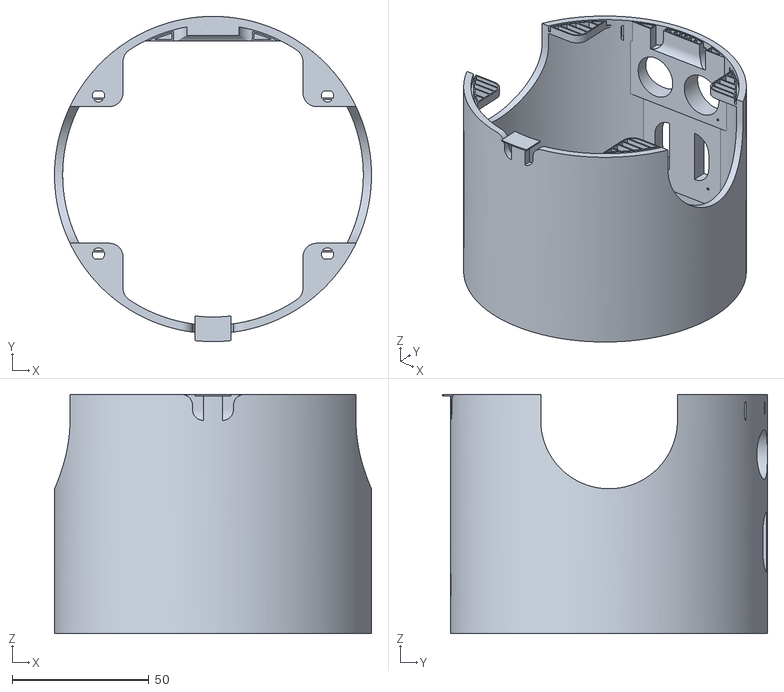
[picture p57: CAD file, 2024-04-12]
MODELADO 3D Y ENSAMBLAJES/ARCHIVOS DE IMPRESION/Carcazav2.obj
116.0 x 119.0 x 87.5
