NIJ18482/Luis-Nij-Tesis-2022/MODELADO 3D Y ENSAMBLAJES/ARCHIVOS DE IMPRESION/Rueda.obj

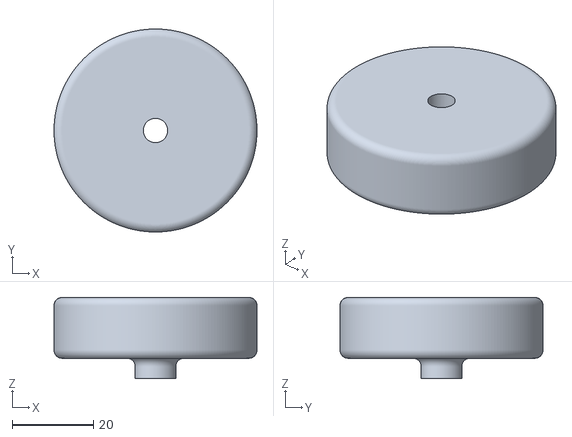
[picture p58: CAD file, 2024-04-12]
MODELADO 3D Y ENSAMBLAJES/ARCHIVOS DE IMPRESION/Rueda.obj
50.0 x 50.0 x 20.0
