NIJ18482/Luis-Nij-Tesis-2022/(list of files, cad)

Other CAD files:
MODELADO 3D Y ENSAMBLAJES/Alphabot_SUP.ipt
MODELADO 3D Y ENSAMBLAJES/Carcaza01.ipt
MODELADO 3D Y ENSAMBLAJES/Carcaza02.ipt
MODELADO 3D Y ENSAMBLAJES/Carcaza03.ipt
MODELADO 3D Y ENSAMBLAJES/Carcaza04.ipt
MODELADO 3D Y ENSAMBLAJES/Ensamblaje1.iam
MODELADO 3D Y ENSAMBLAJES/Espaciador_40mm.ipt
MODELADO 3D Y ENSAMBLAJES/Inferior.ipt
MODELADO 3D Y ENSAMBLAJES/OldVersions/Alphabot_SUP.0002.ipt
MODELADO 3D Y ENSAMBLAJES/OldVersions/Carcaza.0014.ipt
MODELADO 3D Y ENSAMBLAJES/OldVersions/Carcaza04.0001.ipt
MODELADO 3D Y ENSAMBLAJES/OldVersions/Ensamblaje1.0004.iam
MODELADO 3D Y ENSAMBLAJES/OldVersions/Inferior.0006.ipt
MODELADO 3D Y ENSAMBLAJES/OldVersions/PiCam.0002.ipt
MODELADO 3D Y ENSAMBLAJES/PiCam.ipt
MODELADO 3D Y ENSAMBLAJES/US.ipt
