NIJ18482/Luis-Nij-Tesis-2022/SCRIPTS Y PROGRAMACIÓN/cliente.py

import socket

host = '192.168.10.12' #Dirección IP de 
port = 18482

s = socket.socket(socket.AF_INET, socket.SOCK_STREAM)
s.connect((host,port))

while True:
    command = input("Ingrese su comando")
    if command == 'EXIT':
        s.send(str.encode(command))
        break
    elif command == 'KILL':
        s.send(str.encode(command))
        break
    s.send(str.encode(command))
    reply = s.recv(1024)
    print(reply.decode('utf-8'))
    
s.close()
