NIJ18482/Luis-Nij-Tesis-2022/(commit log)

2022-08-23 Add files via upload
    Primera carga de archivos trabajados.
    [1mmCarcaza.obj, Alphabot_SUP.0002.ipt, Alphabot_SUP.ipt, Carcaza.0014.ipt, Carcaza.ipt, Carcaza.obj, Carcaza02.ipt, Carcazav2.obj]
2022-11-20 Add files via upload
    Cuarta Iteración de la Carcaza para el Alphabot 02
    [Carcaza04.ipt, Carcaza04.obj]
2022-11-20 Add files via upload
    Cuarta Iteración del Modelo de la Carcaza para el Alphabot 2
    Esta versión, se imprimió de color naranja.
    Posee apertura para el sujetador de baterías y apertura frontal para el juego de sensores infrarrojos y el ultrasónico,
    Impresión duró 5:30 horas, 0.2 altura de capa y 4 lineas de grosor para aumentar la dureza.
    [Carcaza04.ipt, Carcaza04.obj]
2022-11-20 Update README.md
    Agregado de la descripción del Alphabot2, robot diferencial que se usará para el presente trabajo.
2022-11-20 Add files via upload
    Quinta Iteración de la carcaza.
    Se modificaron las aprturas para tornillos. El grosor de la base para resistir mas y las alturas de los protectores de llantas para no topar con el buzzer ni el joystick
    Se agregaron empalmes en esquinas frontales y traseras para lucir mas estético y se amplió la apertura trasera para el sostenedor de baterías.
    Se imprimió en PLA naranja, altura de capa 0.2 mm, 4 lineas de borde y duró 5 horas y 15 minutos aproximadamente.
    [Carcaza05.ipt, Carcaza05.obj]
2022-11-21 Add files via upload
    Version de la Carcaza 7 iteración.
    Inclusión de socket para el sensor ultrasónico.
    Se agregaron los agujeros para los sensores de proximidad infrarojos y un agregado soporte para el holder de baterías.
    Se imprimió en PLA Naranja, capa 0.2 mm y 4 capas.
    Se observó que la inclusión del socket para el ultrasónico brindó rigidez a la pieza.
    Resultó complicado retirar el soporte de los agujeros para el infrarojo.
    [Carcaza07.ipt, Carcaza07.obj]
2022-11-29 Add files via upload
    Carpata de documentación gráfica para el manejo de los Alphabot
2024-04-10 Update README.md
    Adicion de Imagenes
2024-04-10 Update README.md
    Prueba de los nombramientos de las figuras
2024-04-10 Update README.md
    Actualización de primera parte
2024-04-10 Update README.md
    Actualización de la primera parte
2024-04-10 Update README.md
    ACtualización 2 de PRimera parte
2024-04-10 Update README.md
    Final de parte 1
2024-04-10 Update README_DOCUMENTOS.md
    advice de documento
2024-04-12 Duplicated Files
    Archivos Duplicados
    [Carcaza04.ipt, Carcaza04.obj]
2024-04-12 Rename README.md to TRABAJO DE GRADUACION.md
    Cambio en nombre para dar mejor organización al repositorio
2024-04-12 Create README.md
    Creación del ReadMe General para describir los archivos
2024-04-12 Update README.md
    Adicion de descripcion al README General
2024-04-12 renaming
    renombramiento de archivos para mejor localizacióon
    [1mmCarcaza.obj, Alphabot_SUP.0002.ipt, Alphabot_SUP.ipt, Carcaza.0014.ipt, Carcaza.ipt, Carcaza.obj, Carcaza02.ipt, Carcaza04.ipt]
2024-04-12 add material
    adicion de material de documentacion
2024-04-12 Create README.MD
    Adición del readme de la parte de las imagenes.
2024-04-12 file naming
    file naming for reference
    [1mmCarcaza.obj, Carcaza.obj, Carcaza01.ipt, Carcaza02.ipt, Carcaza02.obj, Carcaza03.ipt, Carcaza03.obj, Carcaza04.0001.ipt]
2024-04-12 adicion de renders
    adicion de renders
